louiscklaw/kicad_library/README.md

# My kicad library and footprint collection

### build status
#### master


#### develop
