louiscklaw/kicad_library/kicad-packages3d/15EDGK/15EDGRC_15EDGK_5_08.PNG

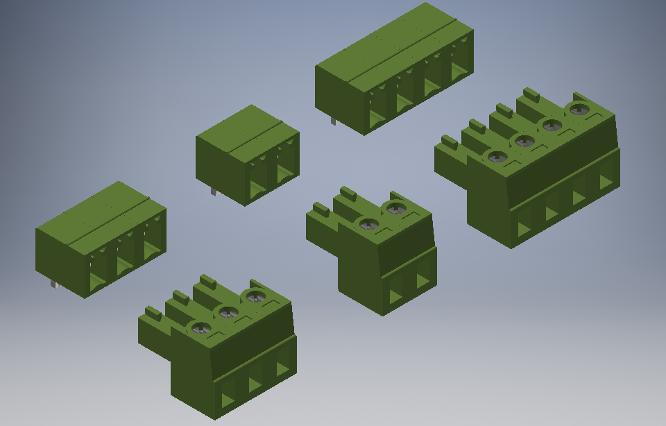
kicad-packages3d/15EDGK/15EDGRC_15EDGK_5_08.PNG
