louiscklaw/kicad_library/kicad-packages3d/connectors TH/Renderings/overview.png

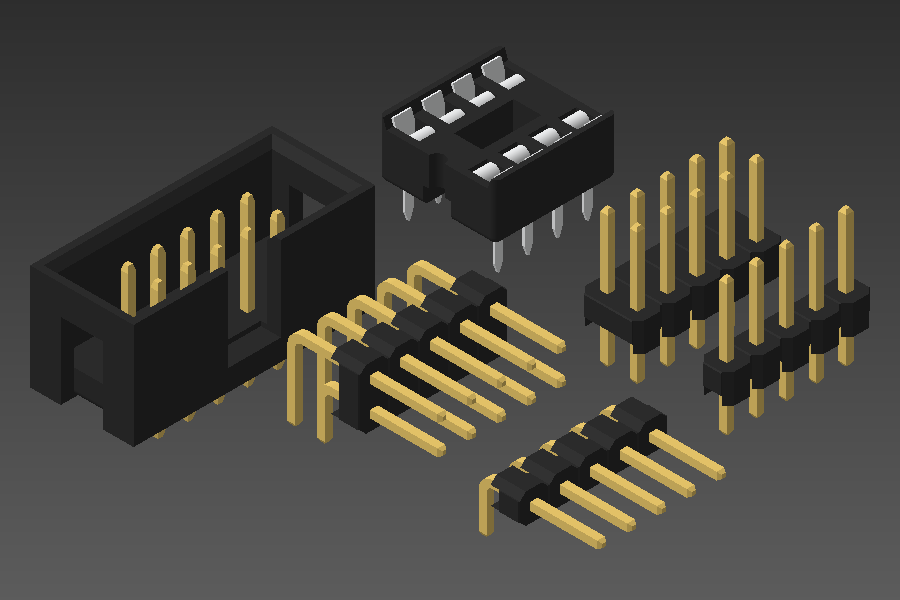
kicad-packages3d/connectors TH/Renderings/overview.png
