louiscklaw/kicad_library/kicad-packages3d/passive smd/Renderings/overview.png

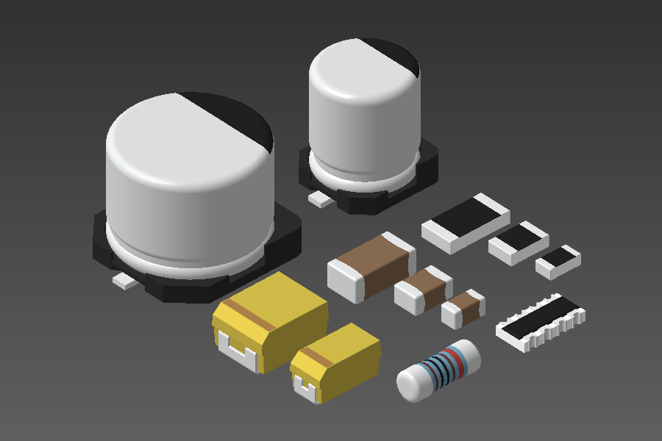
kicad-packages3d/passive smd/Renderings/overview.png
