louiscklaw/kicad_library/components/espressif/ESP-WROOM-32.step

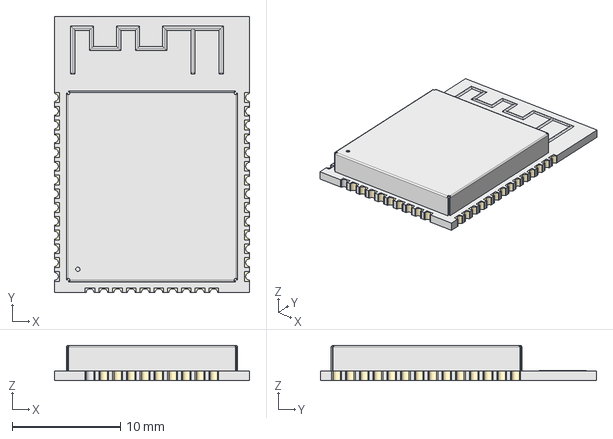
[picture p22: CAD file, 2019-06-11]
components/espressif/ESP-WROOM-32.step
18.0 x 25.5 x 3.25 mm
