louiscklaw/kicad_library/components/KiCad-SSD1306_OLED-0.91-128x32/OLED_0.91_128x32.stp

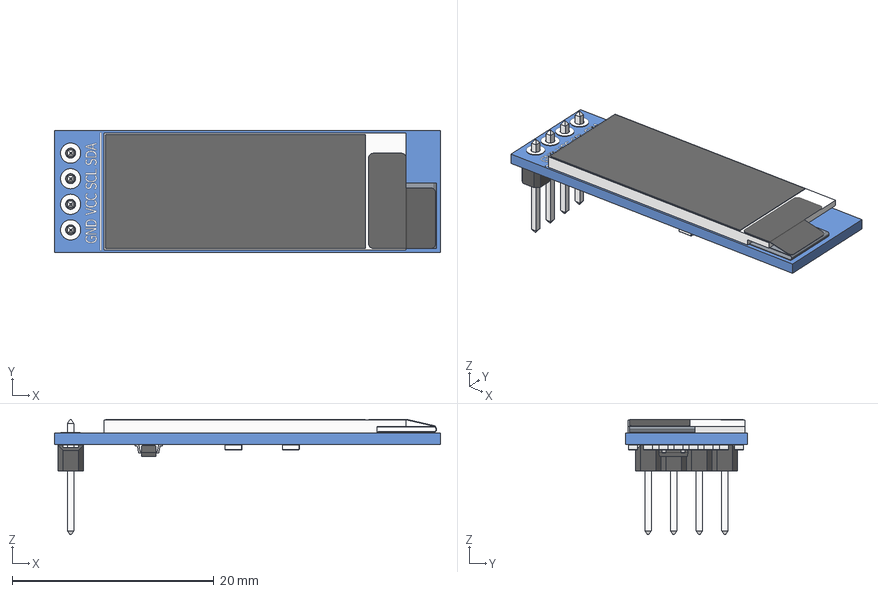
[picture p23: CAD file, 2019-06-02]
components/KiCad-SSD1306_OLED-0.91-128x32/OLED_0.91_128x32.stp
38.3 x 12.1 x 11.5 mm
OLED_0.91_128x32
Pin Header 4 x 1 TH 2.54mm Pitch
RESC-0603 x 13
2SD0601A
