louiscklaw/kicad_library/components/ublox/NEO-M8U Ublox Module.step

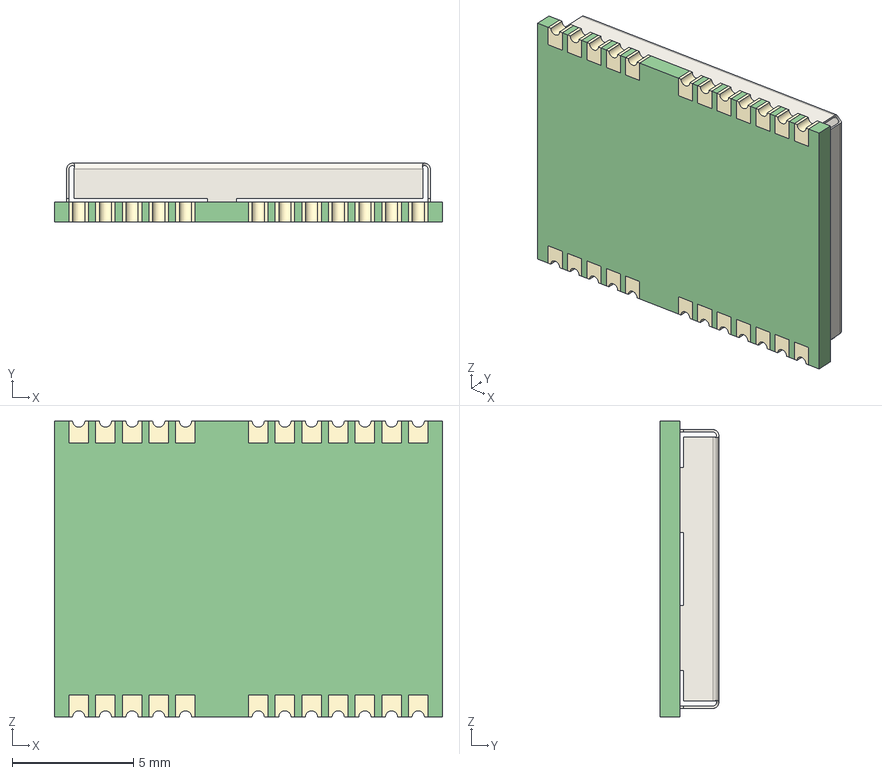
[picture p24: CAD file, 2019-05-14]
components/ublox/NEO-M8U Ublox Module.step
16.0 x 2.42 x 12.2 mm
Board
Solder pads
