louiscklaw/kicad_library/kicad-packages3d/15EDGK/15EDGRC-5.08- 11P-14-00A(H).stp

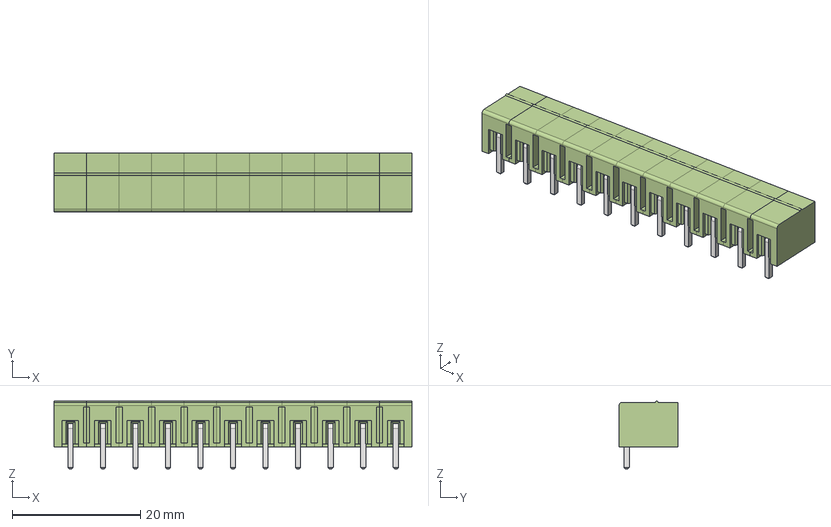
[picture p25: CAD file, 2019-10-14]
kicad-packages3d/15EDGK/15EDGRC-5.08- 11P-14-00A(H).stp
55.9 x 9.20 x 10.6 mm
body_1pc
contact x 11
body_1pc_1
body_1pc_2
body_1pc_3
body_1pc_4
body_1pc_5
body_1pc_6
body_1pc_7
body_1pc_8
body_1pc_9
body_1pc_10
