louiscklaw/kicad_library/kicad-packages3d/4_Pin_audio_jack.STEP

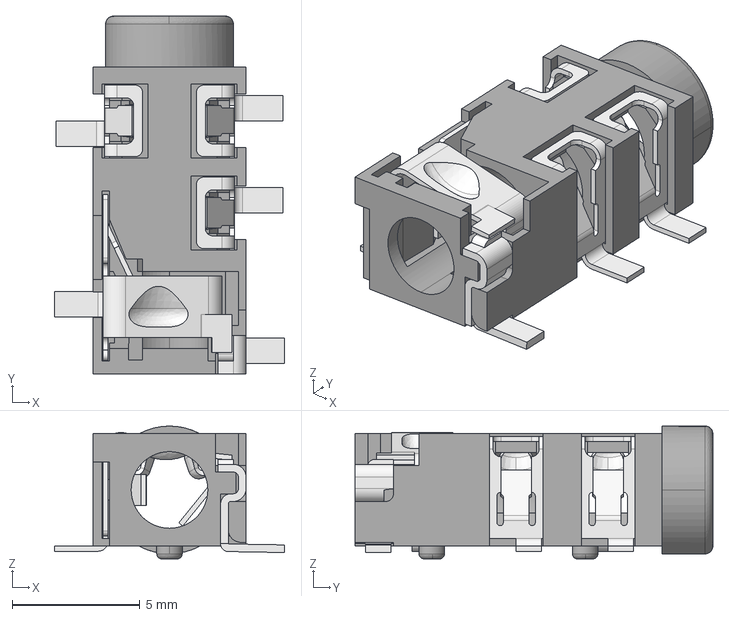
[picture p26: CAD file, 2019-07-07]
kicad-packages3d/4_Pin_audio_jack.STEP
9.00 x 14.0 x 5.20 mm
