louiscklaw/kicad_library/kicad-packages3d/ATX_20_pin_power_connector_vertical/c-2-1586037-0-b-3d.stp

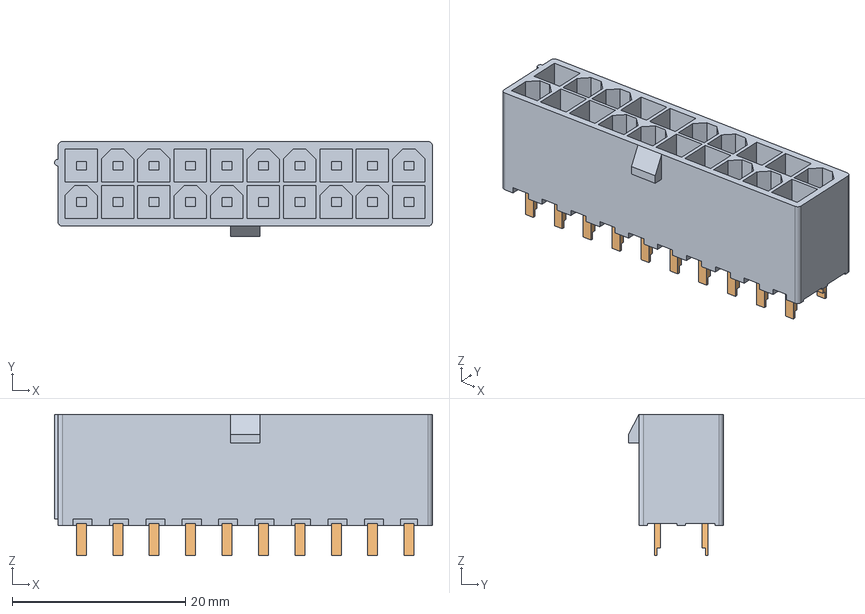
[picture p27: CAD file, 2020-01-22]
kicad-packages3d/ATX_20_pin_power_connector_vertical/c-2-1586037-0-b-3d.stp
43.6 x 10.9 x 16.3 mm
