louiscklaw/kicad_library/kicad-packages3d/connectors TH/DIP_sockets/DIP300-skt-flat-6.stp

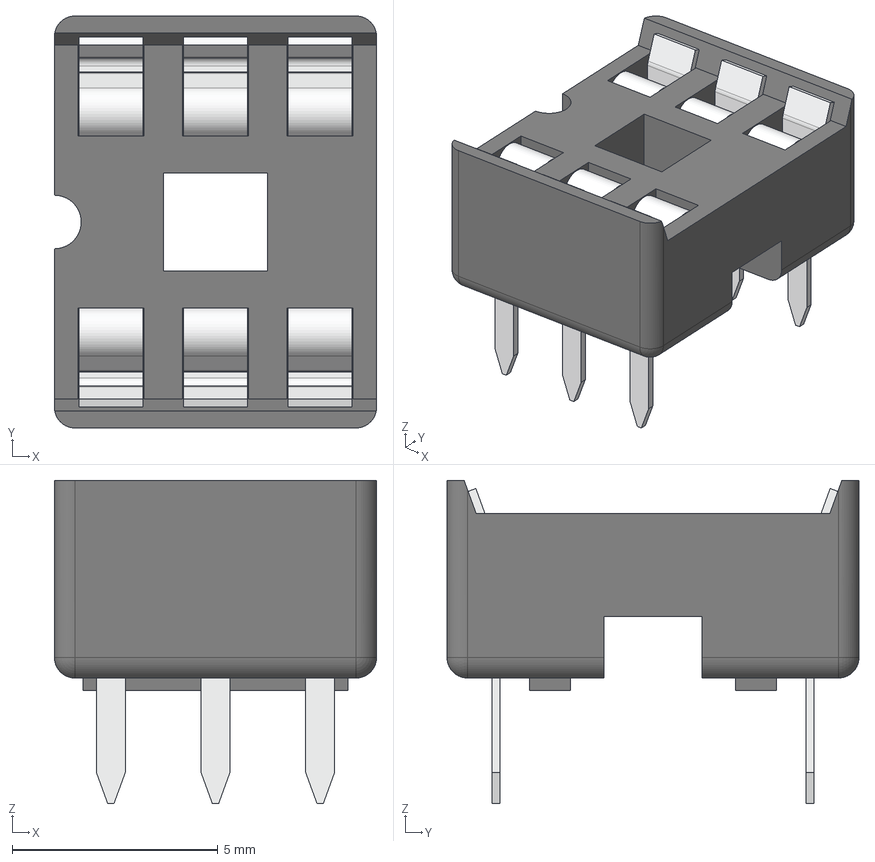
[picture p28: CAD file, 2018-12-04]
kicad-packages3d/connectors TH/DIP_sockets/DIP300-skt-flat-6.stp
7.82 x 10.0 x 7.85 mm
