louiscklaw/kicad_library/kicad-packages3d/connectors TH/rectangular/female/vertical/2.54mm/Samtec/SDL-102-TT-11.stp

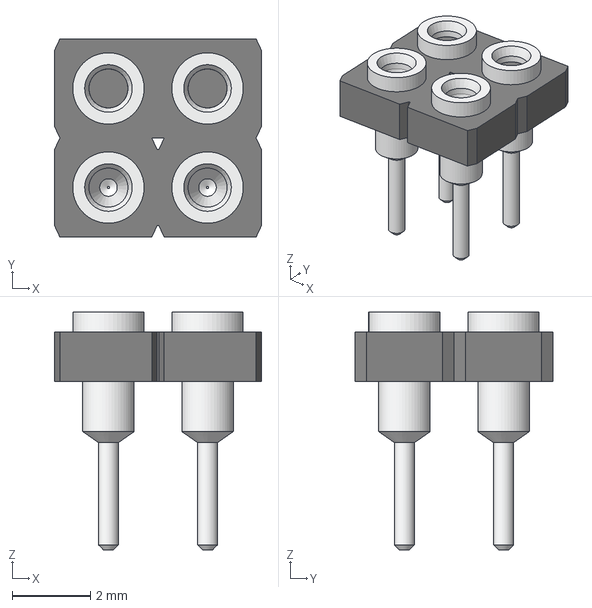
[picture p33: CAD file, 2018-12-04]
kicad-packages3d/connectors TH/rectangular/female/vertical/2.54mm/Samtec/SDL-102-TT-11.stp
5.31 x 5.08 x 6.10 mm
