louiscklaw/kicad_library/kicad-packages3d/connectors TH/rectangular/male/shrouded/right_angle/2.5mm/DS1069-3MRW6XB.stp

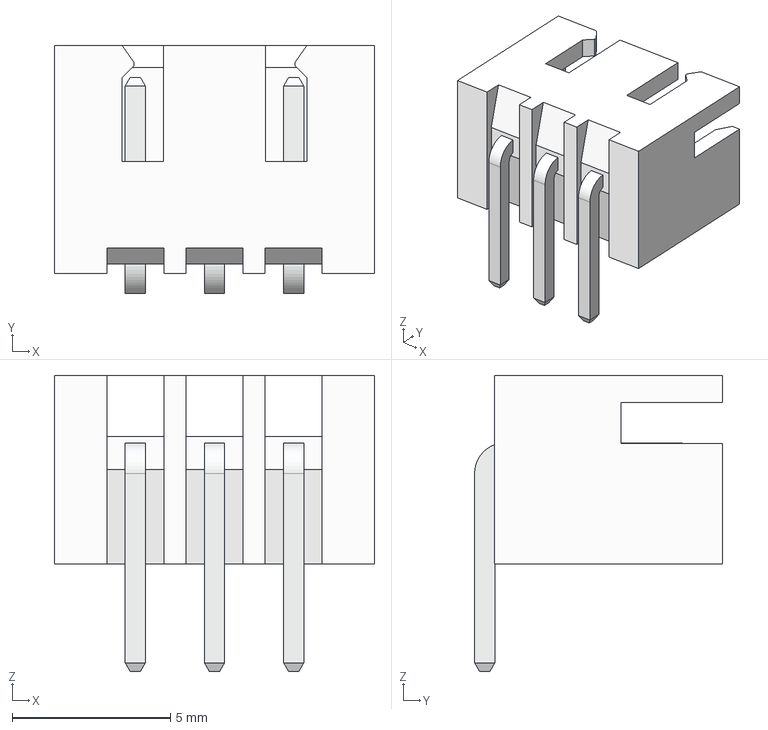
[picture p35: CAD file, 2018-12-04]
kicad-packages3d/connectors TH/rectangular/male/shrouded/right_angle/2.5mm/DS1069-3MRW6XB.stp
10.1 x 7.82 x 9.35 mm
