louiscklaw/kicad_library/kicad-packages3d/connectors TH/rectangular/male/shrouded/vertical/2.5mm/DS1069-2MVW6X.stp

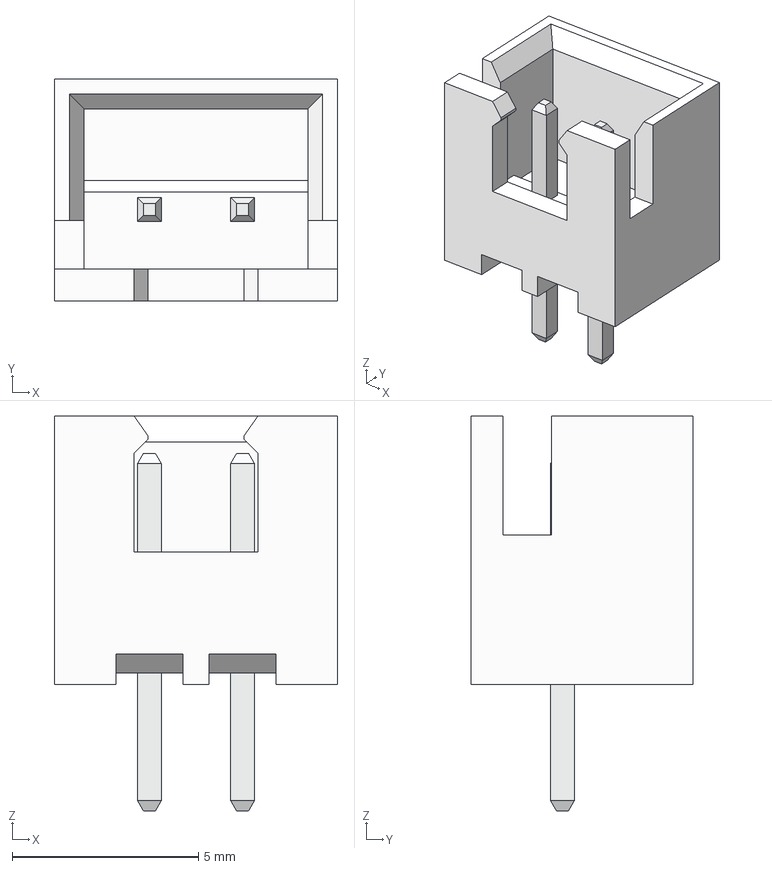
[picture p37: CAD file, 2018-12-04]
kicad-packages3d/connectors TH/rectangular/male/shrouded/vertical/2.5mm/DS1069-2MVW6X.stp
7.60 x 5.95 x 10.6 mm
