louiscklaw/kicad_library/kicad-packages3d/connectors TH/rectangular/male/unshrouded/vertical/1.27mm/DS1031-01-1x1P8BV2-1.stp

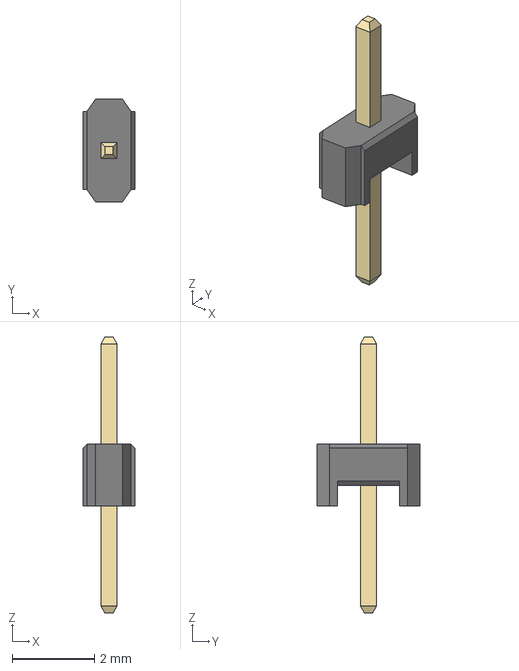
[picture p40: CAD file, 2018-12-04]
kicad-packages3d/connectors TH/rectangular/male/unshrouded/vertical/1.27mm/DS1031-01-1x1P8BV2-1.stp
1.27 x 2.50 x 6.70 mm
