louiscklaw/kicad_library/kicad-packages3d/connectors TH/rectangular/male/unshrouded/vertical/2.54mm/DS1070-7MVV6.stp

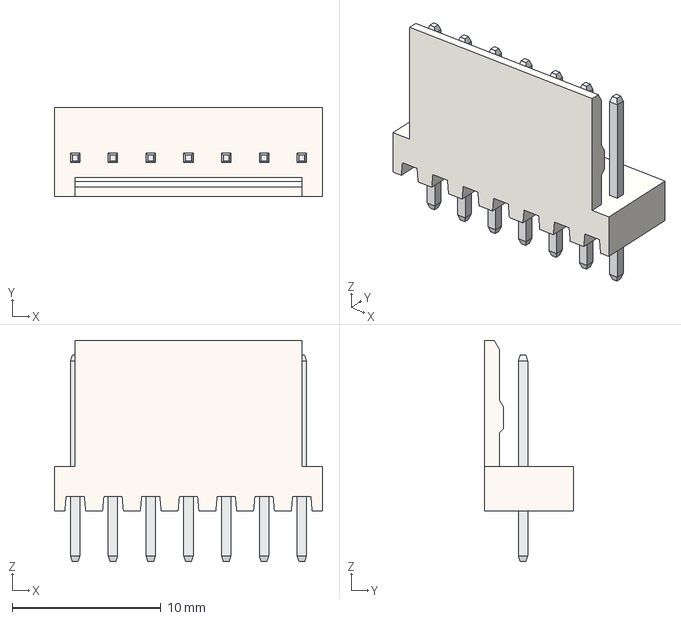
[picture p41: CAD file, 2018-12-04]
kicad-packages3d/connectors TH/rectangular/male/unshrouded/vertical/2.54mm/DS1070-7MVV6.stp
18.0 x 6.00 x 14.9 mm
