louiscklaw/kicad_library/kicad-packages3d/connectors TH/rectangular/male/unshrouded/vertical/5.08mm/10-32-1061.stp

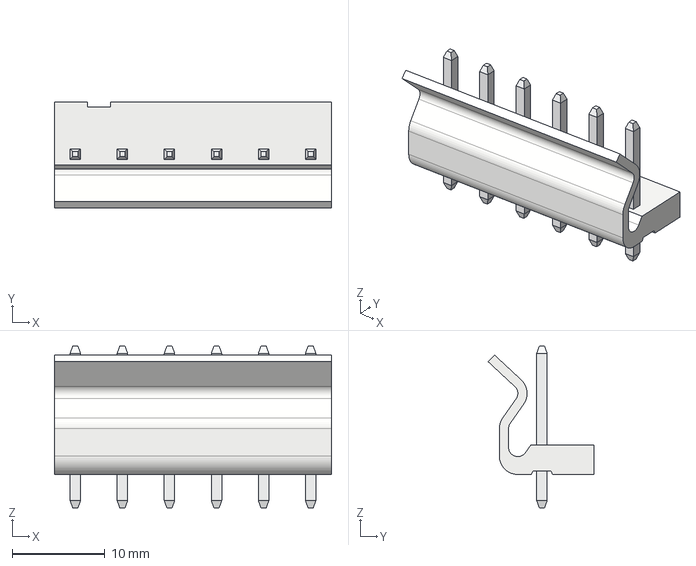
[picture p42: CAD file, 2018-12-04]
kicad-packages3d/connectors TH/rectangular/male/unshrouded/vertical/5.08mm/10-32-1061.stp
29.9 x 11.4 x 17.4 mm
