louiscklaw/kicad_library/kicad-packages3d/connectors TH/terminal/TE_1742361-1.stp

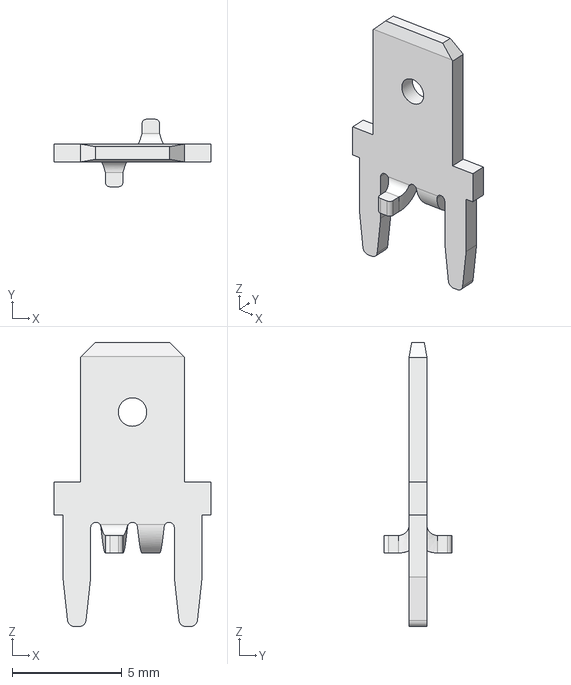
[picture p43: CAD file, 2018-12-04]
kicad-packages3d/connectors TH/terminal/TE_1742361-1.stp
7.14 x 3.08 x 13.0 mm
