louiscklaw/kicad_library/kicad-packages3d/Degson/DG103-5.0-02.stp

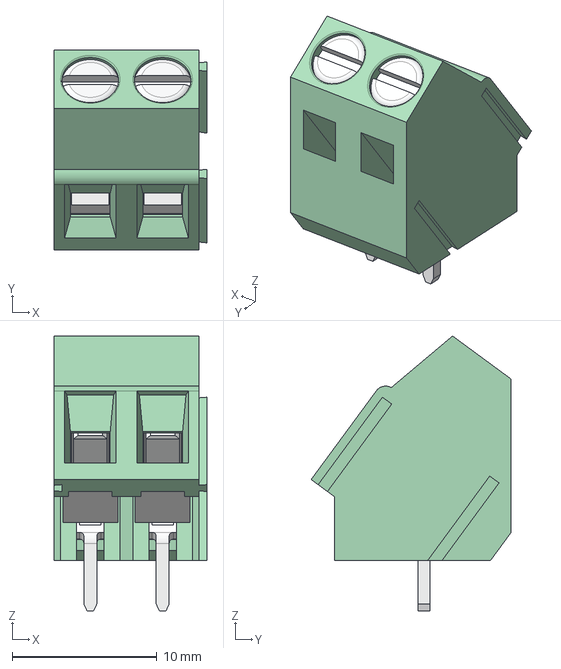
[picture p44: CAD file, 2018-12-04]
kicad-packages3d/Degson/DG103-5.0-02.stp
10.6 x 13.8 x 19.0 mm
