louiscklaw/kicad_library/kicad-packages3d/discrete SMD/SC-79.stp

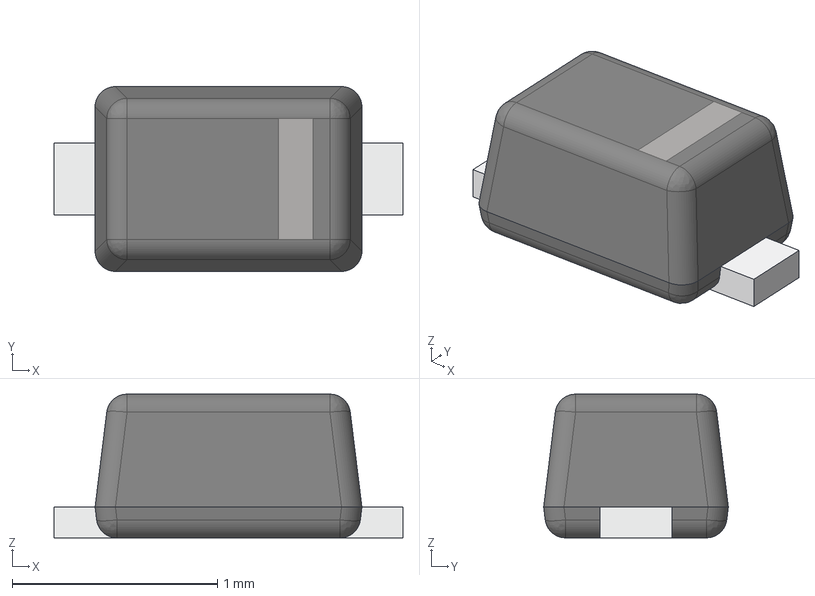
[picture p45: CAD file, 2018-12-04]
kicad-packages3d/discrete SMD/SC-79.stp
1.70 x 0.9 x 0.7 mm
