louiscklaw/kicad_library/kicad-packages3d/EDG/2EDG-5.08-02P.STEP

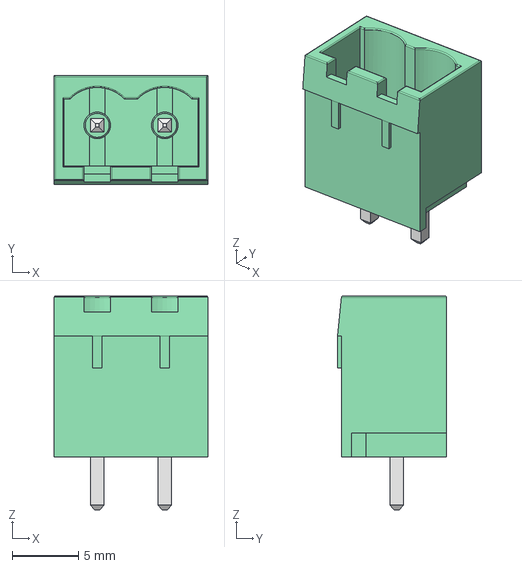
[picture p46: CAD file, 2019-06-20]
kicad-packages3d/EDG/2EDG-5.08-02P.STEP
11.6 x 8.20 x 16.1 mm
