louiscklaw/kicad_library/kicad-packages3d/IC/Fair_Power56_PQFN08AREV10.stp

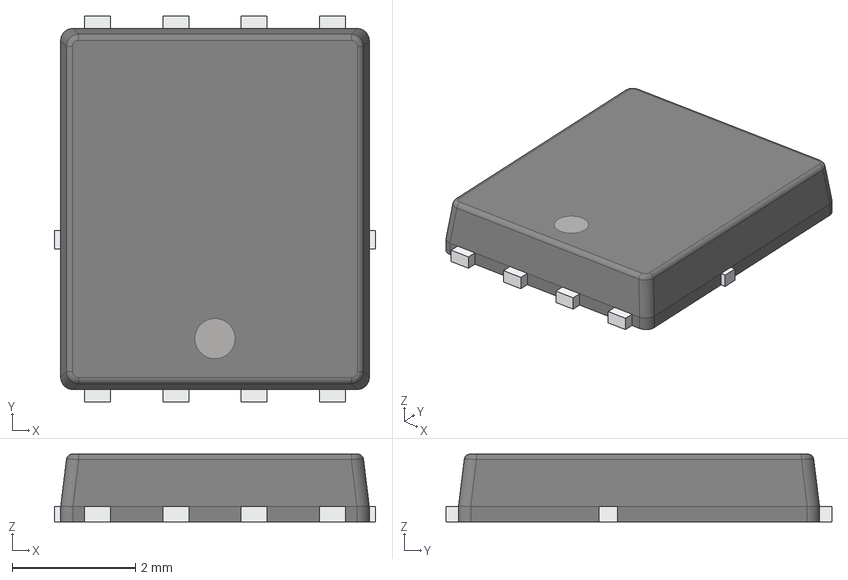
[picture p47: CAD file, 2018-12-04]
kicad-packages3d/IC/Fair_Power56_PQFN08AREV10.stp
5.20 x 6.25 x 1.10 mm
