louiscklaw/kicad_library/kicad-packages3d/keyboard/keycap_dsa_signatureplastics_r3.step

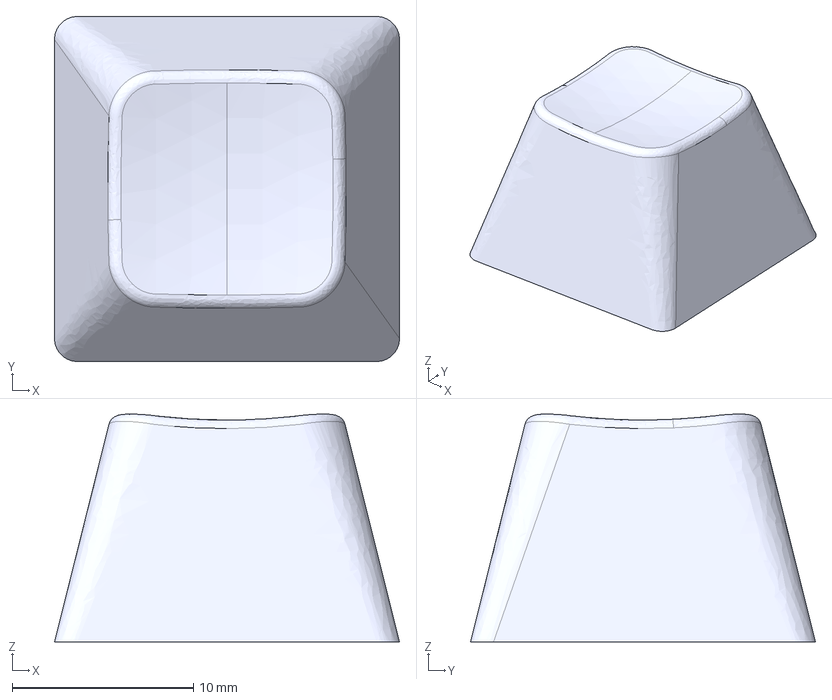
[picture p48: CAD file, 2019-06-03]
kicad-packages3d/keyboard/keycap_dsa_signatureplastics_r3.step
19.1 x 19.1 x 12.6 mm
