louiscklaw/kicad_library/kicad-packages3d/LED/STEP-WL-SBTW-3528-rev1(2.stp

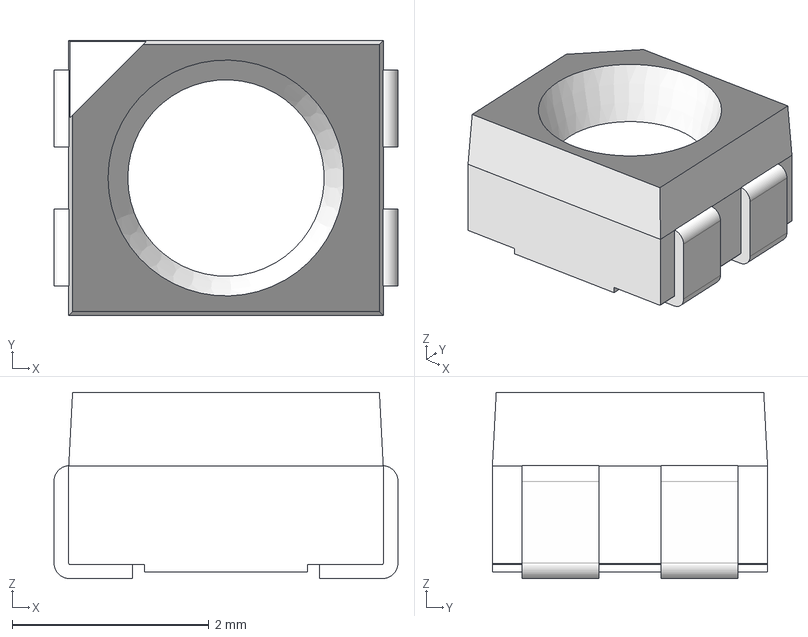
[picture p49: CAD file, 2018-12-04]
kicad-packages3d/LED/STEP-WL-SBTW-3528-rev1(2.stp
3.50 x 2.80 x 1.90 mm
cover
housing
base x 2
