louiscklaw/kicad_library/kicad-packages3d/LGA1155_FAN_MOUNT/kf2510_4p_right_angle.step

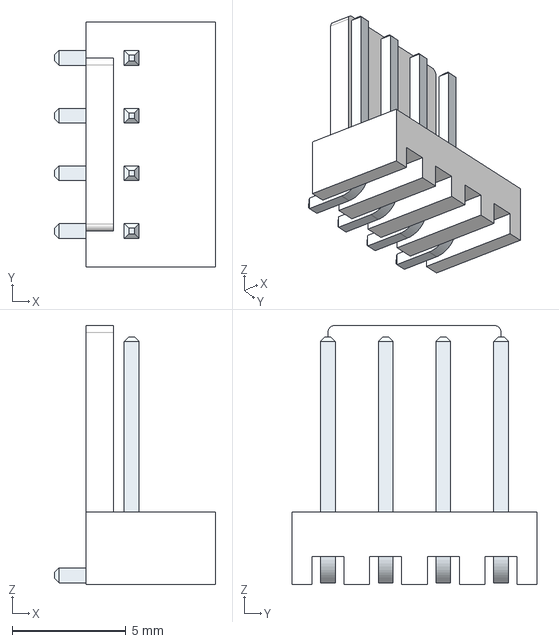
[picture p50: CAD file, 2021-09-15]
kicad-packages3d/LGA1155_FAN_MOUNT/kf2510_4p_right_angle.step
7.10 x 10.8 x 11.4 mm
