louiscklaw/kicad_library/kicad-packages3d/lora/RFM95.step

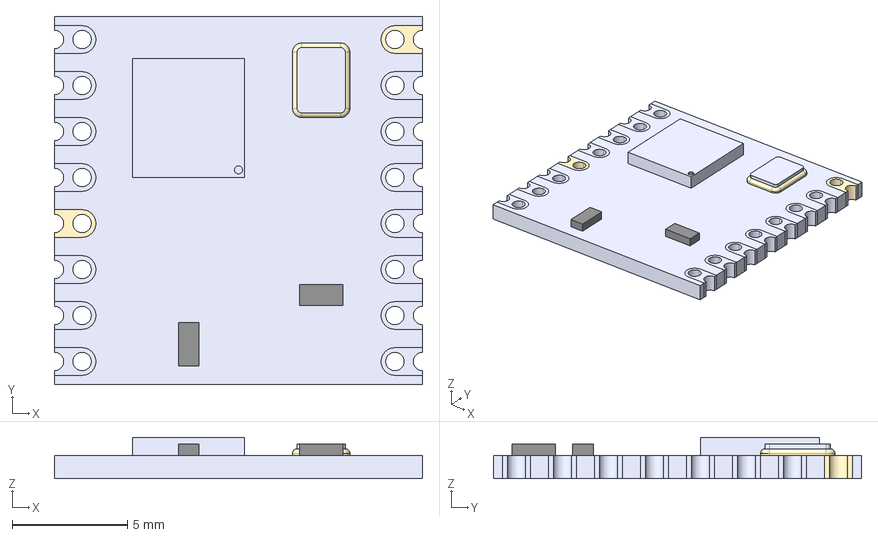
[picture p51: CAD file, 2019-06-14]
kicad-packages3d/lora/RFM95.step
16.0 x 16.0 x 1.80 mm
