louiscklaw/kicad_library/kicad-packages3d/MP1584_DC_DC_converter/D-SUN_dcdc_step_down_SIMPLE.step

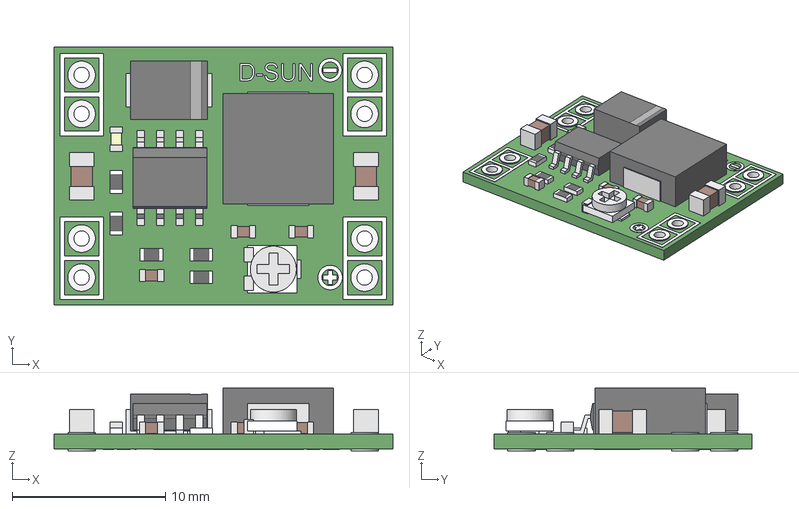
[picture p52: CAD file, 2019-05-25]
kicad-packages3d/MP1584_DC_DC_converter/D-SUN_dcdc_step_down_SIMPLE.step
22.1 x 16.8 x 4.10 mm
main001
silk-TOP
pins
silk-bot
comp-top
