louiscklaw/kicad_library/kicad-packages3d/orange-pi-zero/PinSocket_1x13_P254mm_Vertical.step

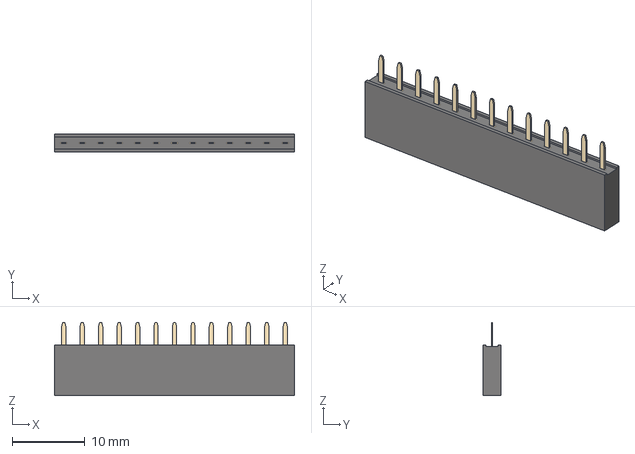
[picture p53: CAD file, 2019-07-07]
kicad-packages3d/orange-pi-zero/PinSocket_1x13_P254mm_Vertical.step
33.0 x 2.54 x 10.1 mm
