louiscklaw/kicad_library/kicad-packages3d/oscillator/OSC3225.STEP

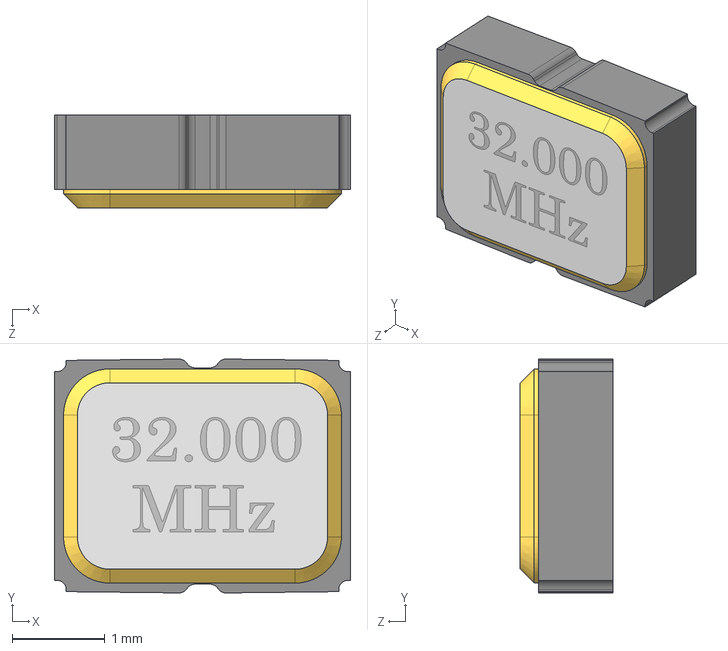
[picture p54: CAD file, 2019-05-09]
kicad-packages3d/oscillator/OSC3225.STEP
3.20 x 2.53 x 1.00 mm
