louiscklaw/kicad_library/kicad-packages3d/passive smd/Capacitors/CAPM-TANTA-YL.stp

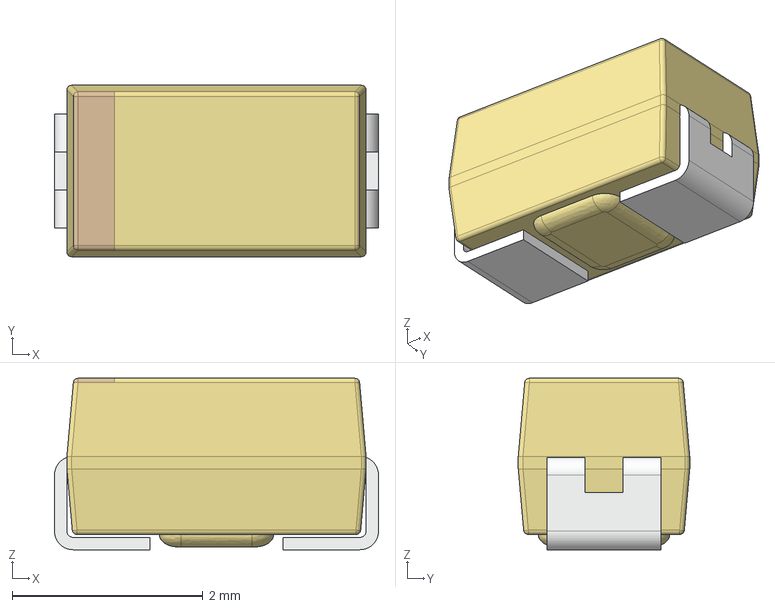
[picture p55: CAD file, 2018-12-04]
kicad-packages3d/passive smd/Capacitors/CAPM-TANTA-YL.stp
3.40 x 1.80 x 1.80 mm
