louiscklaw/kicad_library/kicad-packages3d/passive smd/Crystals/HC-49SM.stp

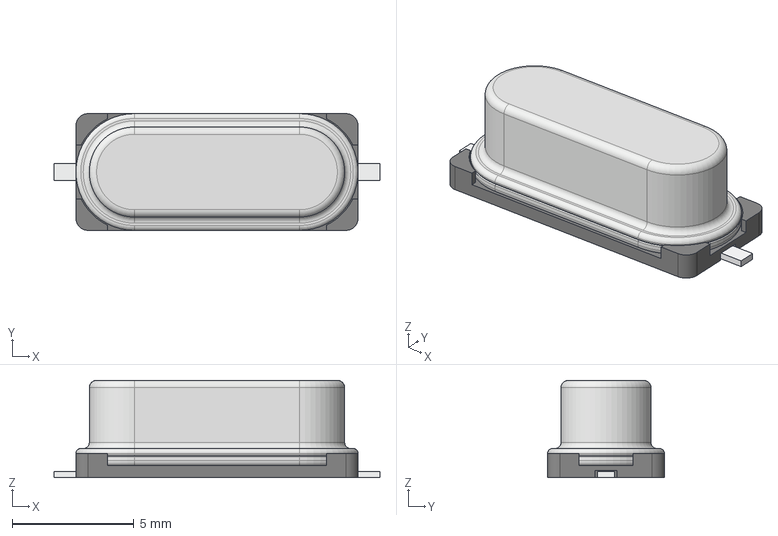
[picture p56: CAD file, 2018-12-04]
kicad-packages3d/passive smd/Crystals/HC-49SM.stp
13.4 x 4.80 x 4.00 mm
