louiscklaw/kicad_library/kicad-packages3d/passive smd/Inductors/SRP1038A-NLF.stp

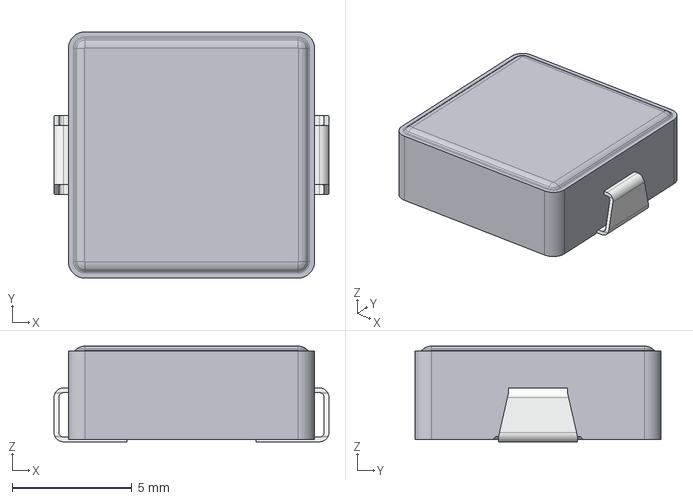
[picture p57: CAD file, 2018-12-04]
kicad-packages3d/passive smd/Inductors/SRP1038A-NLF.stp
11.5 x 10.3 x 4.00 mm
