louiscklaw/kicad_library/kicad-packages3d/passive smd/Resistors/RESMELF-0207.stp

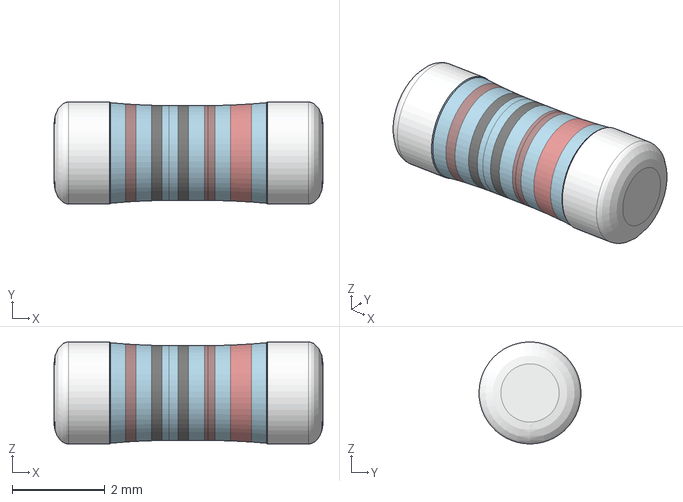
[picture p58: CAD file, 2018-12-04]
kicad-packages3d/passive smd/Resistors/RESMELF-0207.stp
5.80 x 2.20 x 2.20 mm
