louiscklaw/kicad_library/kicad-packages3d/qfn/QFN28.step

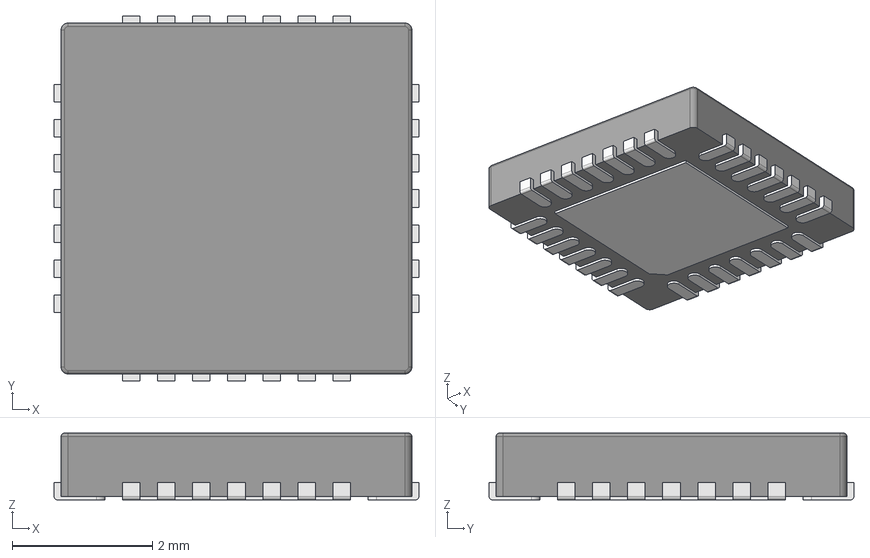
[picture p59: CAD file, 2019-05-31]
kicad-packages3d/qfn/QFN28.step
5.20 x 5.20 x 0.95 mm
