louiscklaw/kicad_library/kicad-packages3d/RJ45/RJ45 SH Plug.STEP

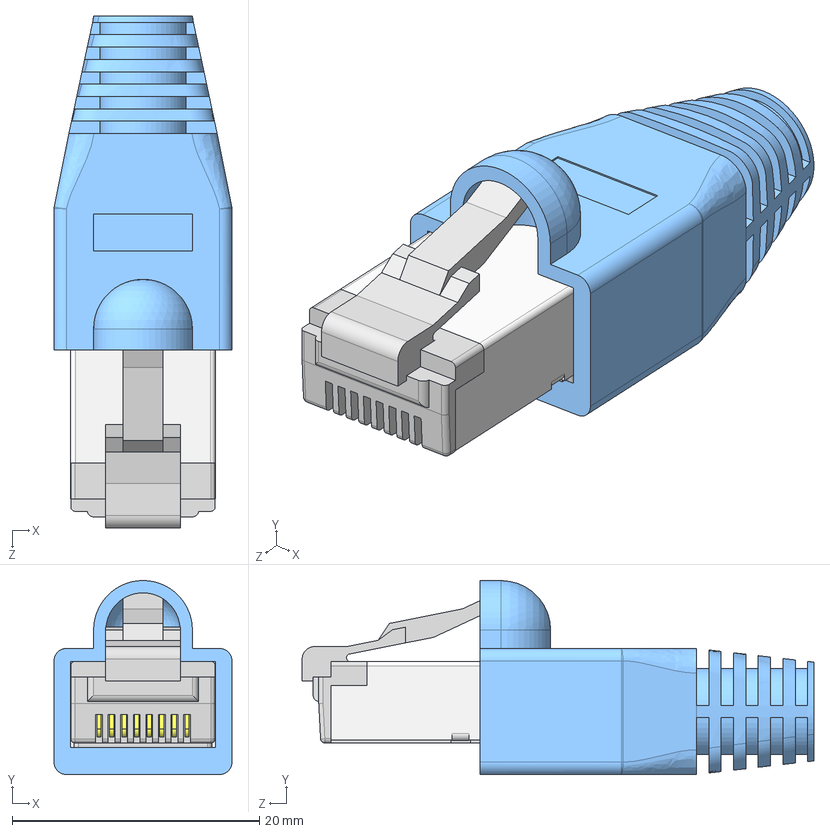
[picture p60: CAD file, 2022-02-03]
kicad-packages3d/RJ45/RJ45 SH Plug.STEP
14.4 x 15.7 x 41.4 mm
RJ45S Body^RJ45S Plug_00
RJ45 Pin^RJ45_00 x 8
RJ45S Shield^RJ45S Plug_00
Protective Jacket^RJ45Sh Plug_Orange
