louiscklaw/kicad_library/kicad-packages3d/rpi_zero/RaspberryPiZeroW.step

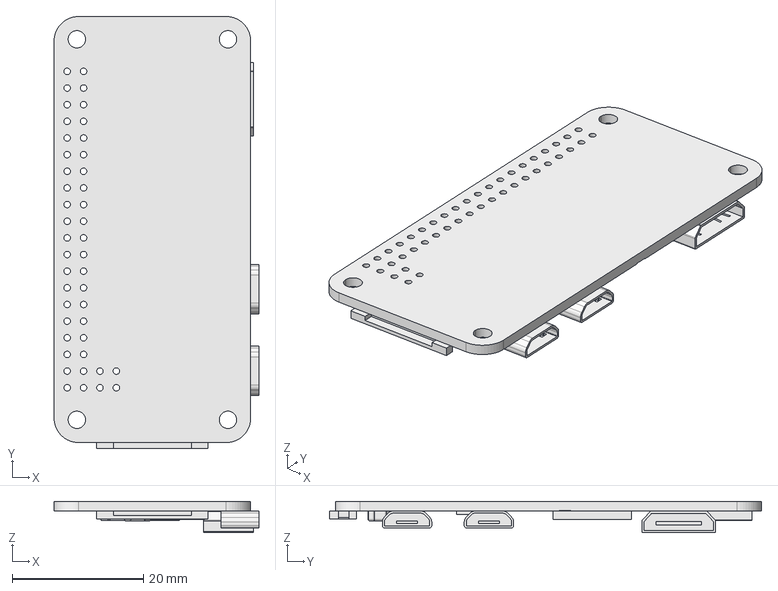
[picture p61: CAD file, 2019-07-12]
kicad-packages3d/rpi_zero/RaspberryPiZeroW.step
31.2 x 65.9 x 4.80 mm
