louiscklaw/kicad_library/kicad-packages3d/SD card/micro sd.stp

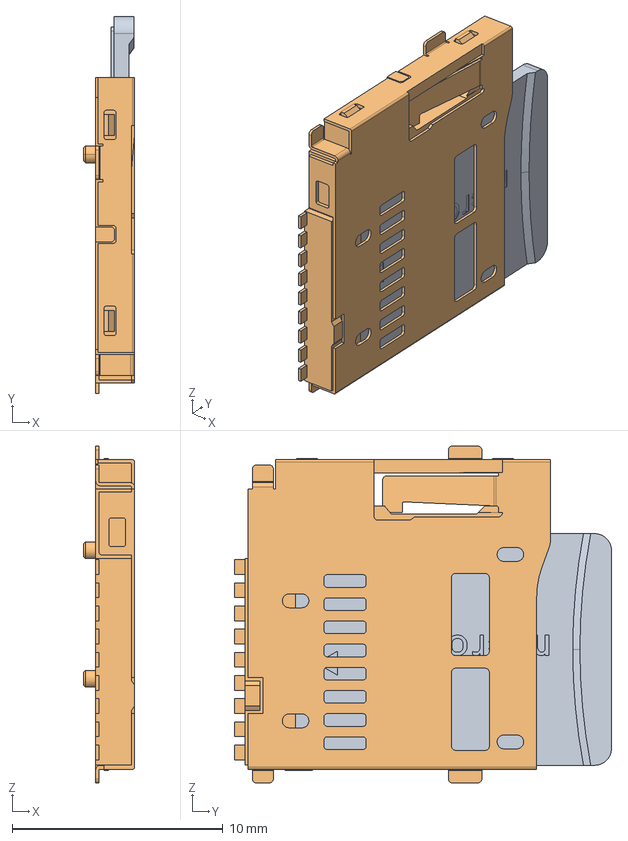
[picture p62: CAD file, 2018-12-04]
kicad-packages3d/SD card/micro sd.stp
2.44 x 17.9 x 16.0 mm
P1
sd
slot
