louiscklaw/kicad_library/kicad-packages3d/smd_fuse/C1.stp

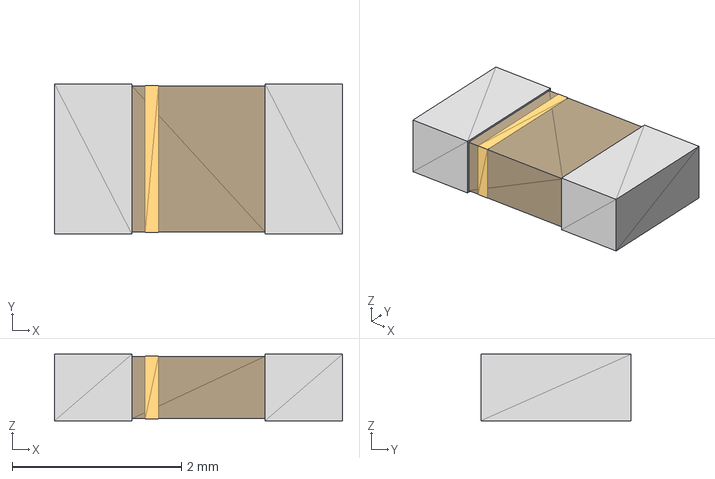
[picture p63: CAD file, 2018-12-04]
kicad-packages3d/smd_fuse/C1.stp
3.40 x 1.78 x 0.787 mm
