louiscklaw/kicad_library/kicad-packages3d/standoff/Hex Spacer MF M3 L50mm.stp

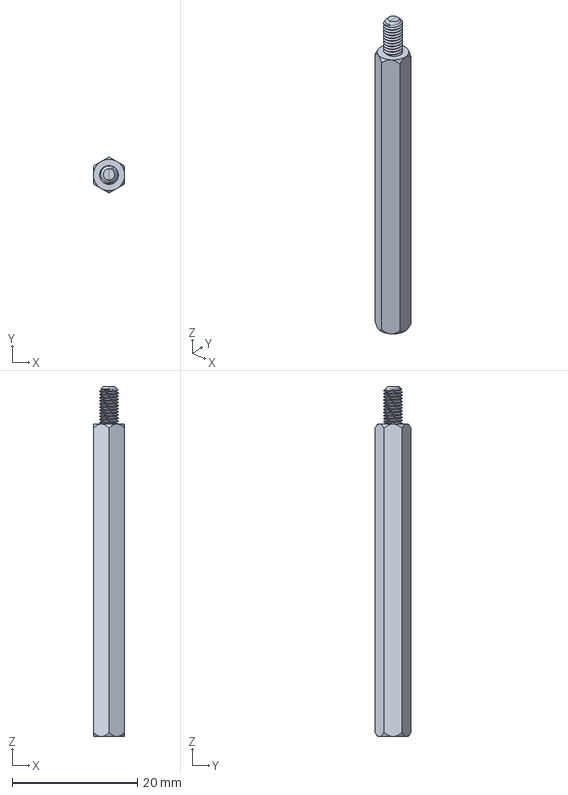
[picture p64: CAD file, 2018-12-04]
kicad-packages3d/standoff/Hex Spacer MF M3 L50mm.stp
5.00 x 5.77 x 56.0 mm
