louiscklaw/kicad_library/kicad-packages3d/terminals/tb5p-2p_p5_l10_w7-6_h10.stp

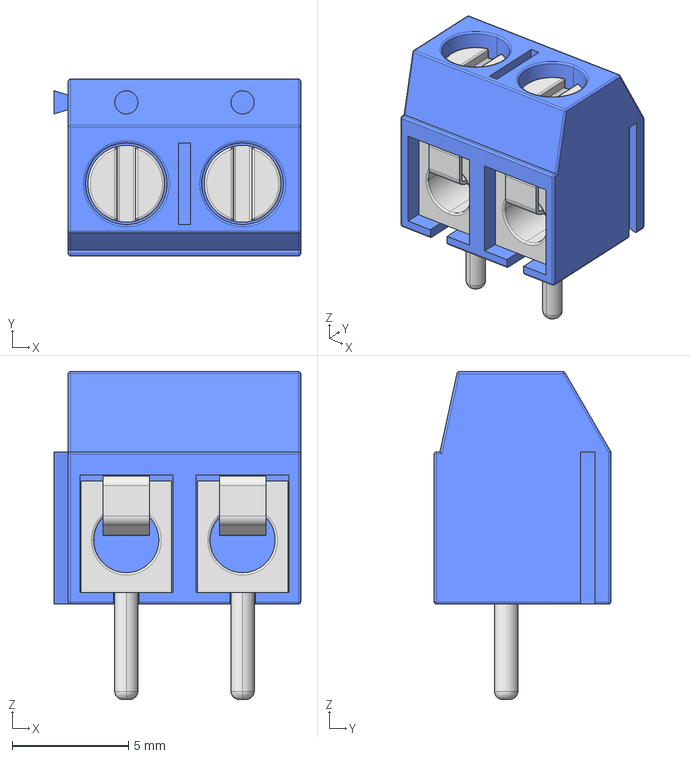
[picture p66: CAD file, 2020-08-20]
kicad-packages3d/terminals/tb5p-2p_p5_l10_w7-6_h10.stp
10.6 x 7.60 x 14.1 mm
