louiscklaw/kicad_library/kicad-packages3d/UBLOX/NEO-6M-0-001.step

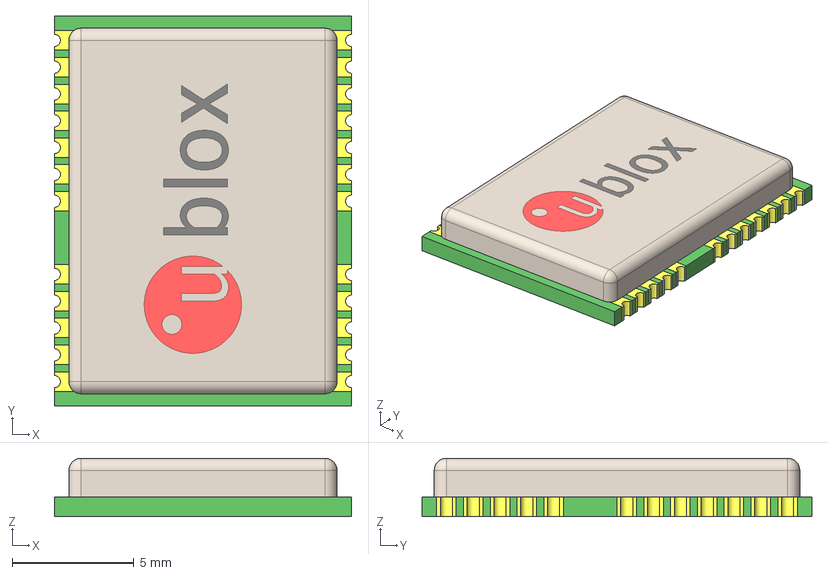
[picture p67: CAD file, 2019-06-25]
kicad-packages3d/UBLOX/NEO-6M-0-001.step
12.2 x 16.0 x 2.40 mm
