louiscklaw/kicad_library/components/espressif/ESP-12E.stl

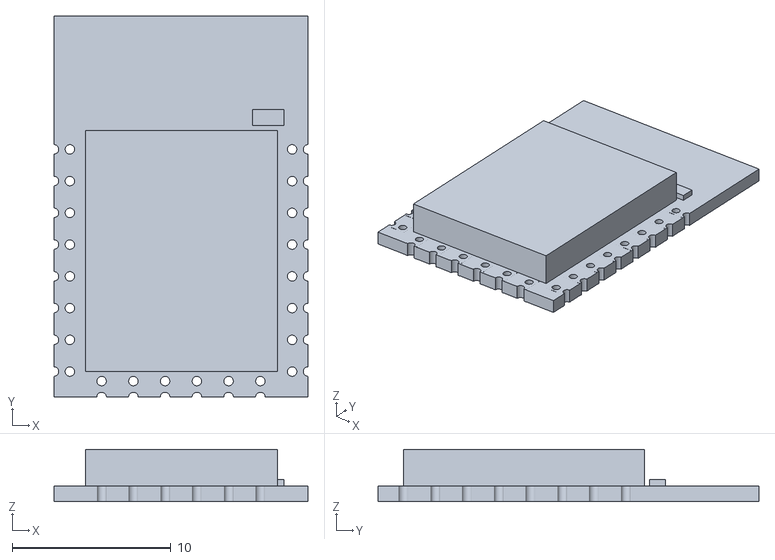
[picture p68: CAD file, 2019-05-08]
components/espressif/ESP-12E.stl
16.0 x 24.0 x 3.30
