louiscklaw/kicad_library/components/KiCad-SSD1306_OLED-0.91-128x32/SSD1306_OLED-0.91-128x32.step

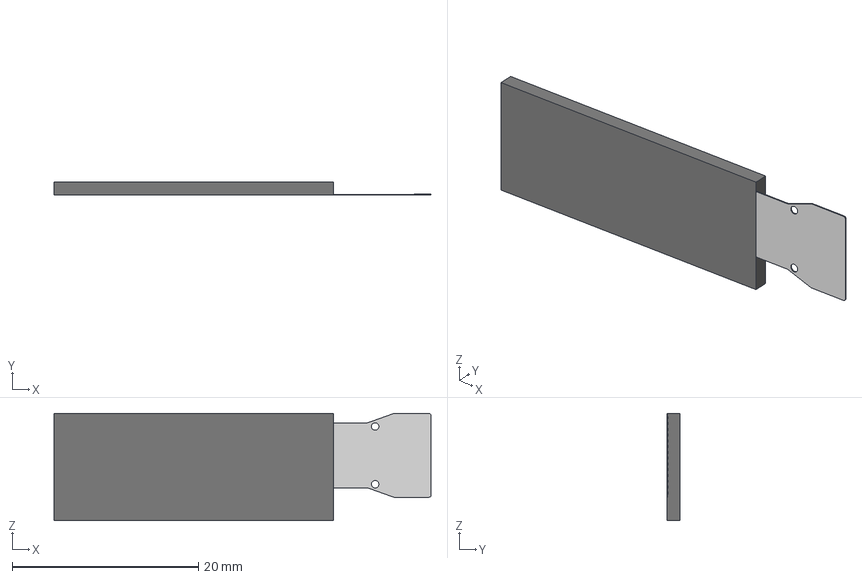
[picture p69: CAD file, 2019-01-09]
components/KiCad-SSD1306_OLED-0.91-128x32/SSD1306_OLED-0.91-128x32.step
40.5 x 1.45 x 11.5 mm
