louiscklaw/kicad_library/generator/kicad-footprint-generator/scripts/Connector/Connector_JST/JST-PH-SMT-TOP_ENTRY.fcstd

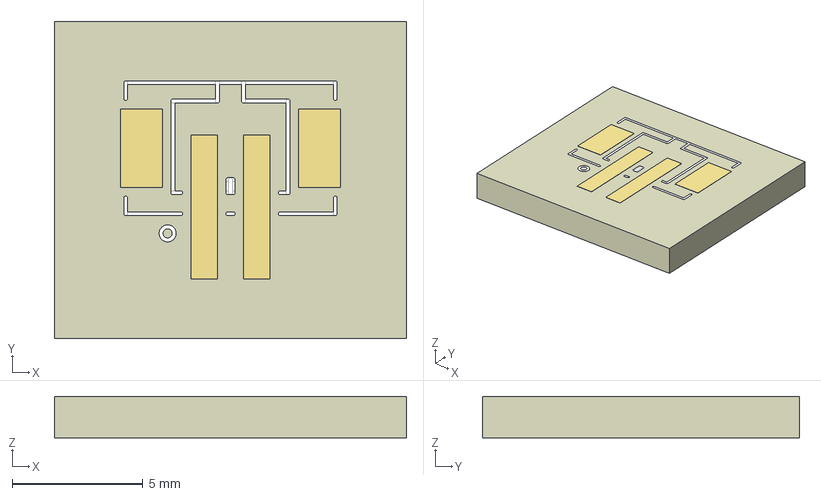
[picture p70: CAD file, 2018-10-22]
generator/kicad-footprint-generator/scripts/Connector/Connector_JST/JST-PH-SMT-TOP_ENTRY.fcstd
13.4 x 12.1 x 1.60 mm
FrontSilk
TopPads
Pcb
