louiscklaw/kicad_library/kicad-packages3d/15EDGK/15EDGRC-5.08- 07P-14-00A(H).stp

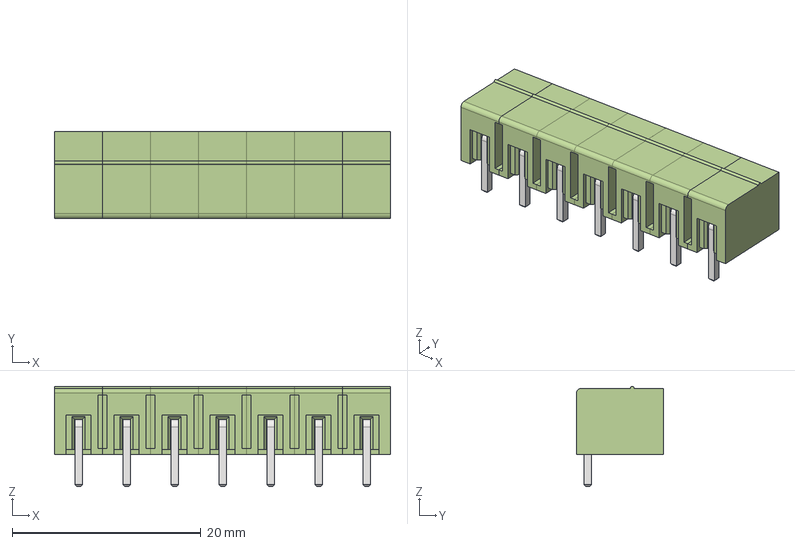
[picture p71: CAD file, 2019-10-14]
kicad-packages3d/15EDGK/15EDGRC-5.08- 07P-14-00A(H).stp
35.6 x 9.20 x 10.6 mm
body_1pc
contact x 7
body_1pc_1
body_1pc_2
body_1pc_3
body_1pc_4
body_1pc_5
body_1pc_6
