louiscklaw/kicad_library/kicad-packages3d/ATX_20_pin_power_connector_vertical/ATX_20_pin_power_connector.step

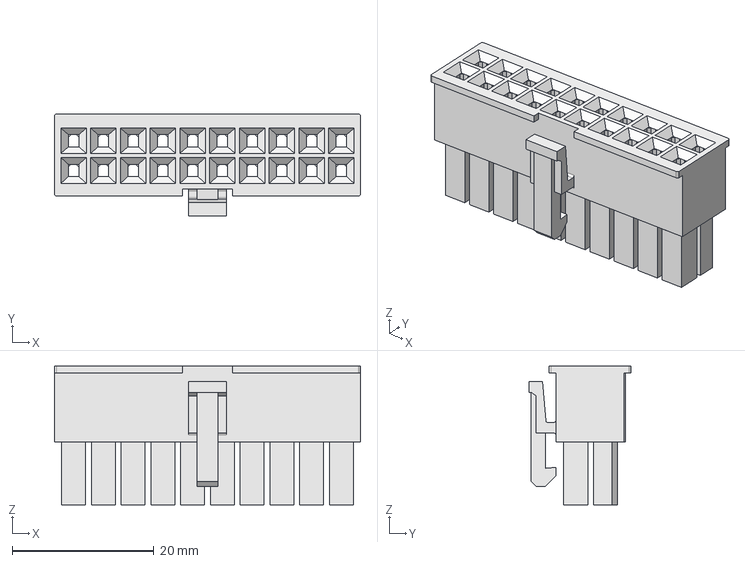
[picture p72: CAD file, 2020-01-22]
kicad-packages3d/ATX_20_pin_power_connector_vertical/ATX_20_pin_power_connector.step
43.2 x 14.4 x 19.6 mm
