louiscklaw/kicad_library/kicad-packages3d/connectors TH/DIP_sockets/DIP300-skt-flat-14.stp

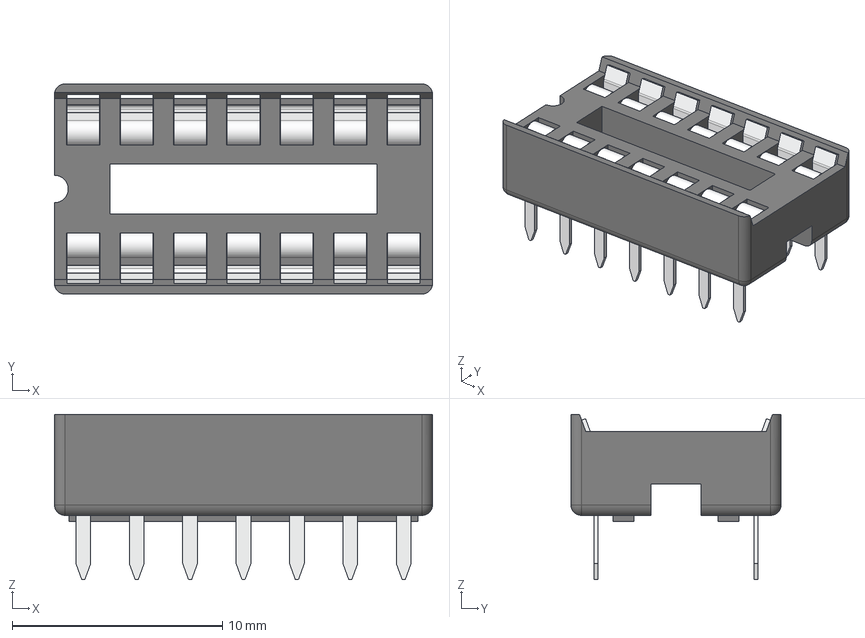
[picture p73: CAD file, 2018-12-04]
kicad-packages3d/connectors TH/DIP_sockets/DIP300-skt-flat-14.stp
18.0 x 10.0 x 7.85 mm
