louiscklaw/kicad_library/kicad-packages3d/connectors TH/modular/A-2014-0-4-R.stp

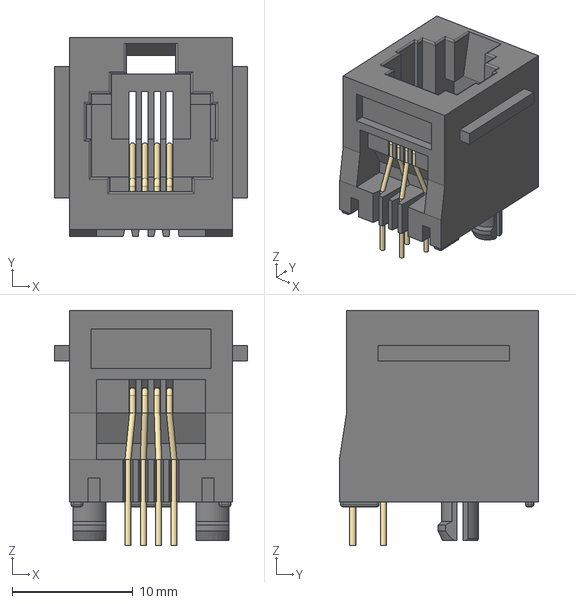
[picture p74: CAD file, 2018-12-04]
kicad-packages3d/connectors TH/modular/A-2014-0-4-R.stp
16.0 x 16.5 x 19.4 mm
