louiscklaw/kicad_library/kicad-packages3d/connectors TH/rectangular/direct_wire/2.54mm/DS1018-166B.stp

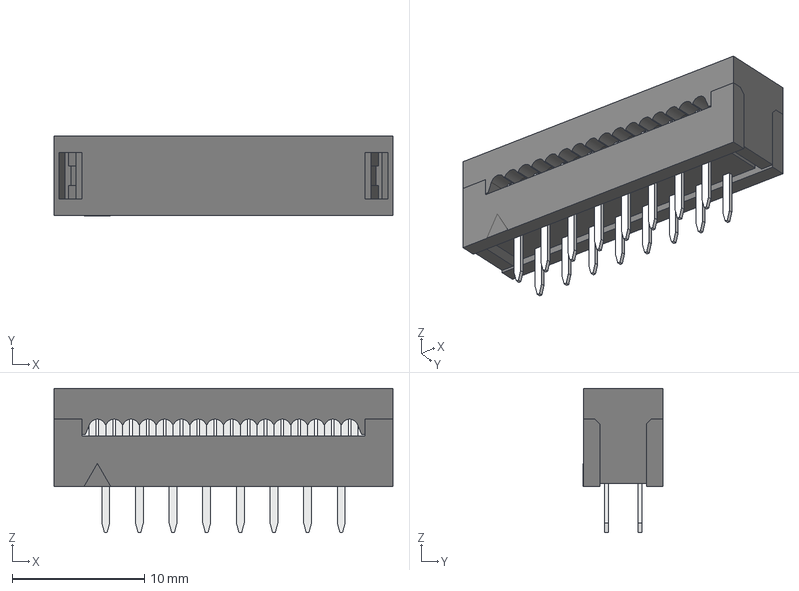
[picture p75: CAD file, 2018-12-04]
kicad-packages3d/connectors TH/rectangular/direct_wire/2.54mm/DS1018-166B.stp
25.6 x 6.03 x 10.9 mm
