louiscklaw/kicad_library/kicad-packages3d/connectors TH/rectangular/female/right_angle/2.54mm/DS1024-1x5RF1.stp

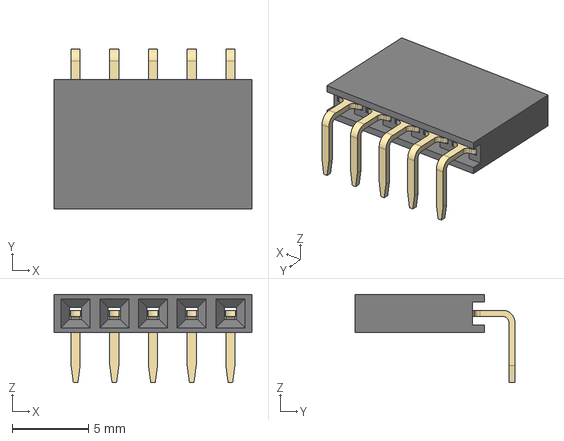
[picture p76: CAD file, 2018-12-04]
kicad-packages3d/connectors TH/rectangular/female/right_angle/2.54mm/DS1024-1x5RF1.stp
13.0 x 10.5 x 5.80 mm
