louiscklaw/kicad_library/kicad-packages3d/connectors TH/rectangular/female/vertical/2.54mm/DS1023-1x10SF11.stp

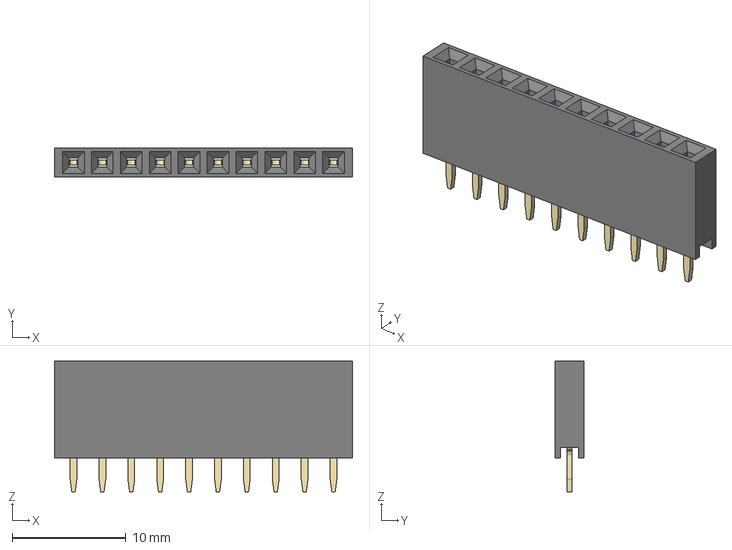
[picture p77: CAD file, 2018-12-04]
kicad-packages3d/connectors TH/rectangular/female/vertical/2.54mm/DS1023-1x10SF11.stp
26.2 x 2.54 x 11.5 mm
