louiscklaw/kicad_library/kicad-packages3d/connectors TH/rectangular/female/vertical/2.54mm/Samtec/SL-110-TT-19.stp

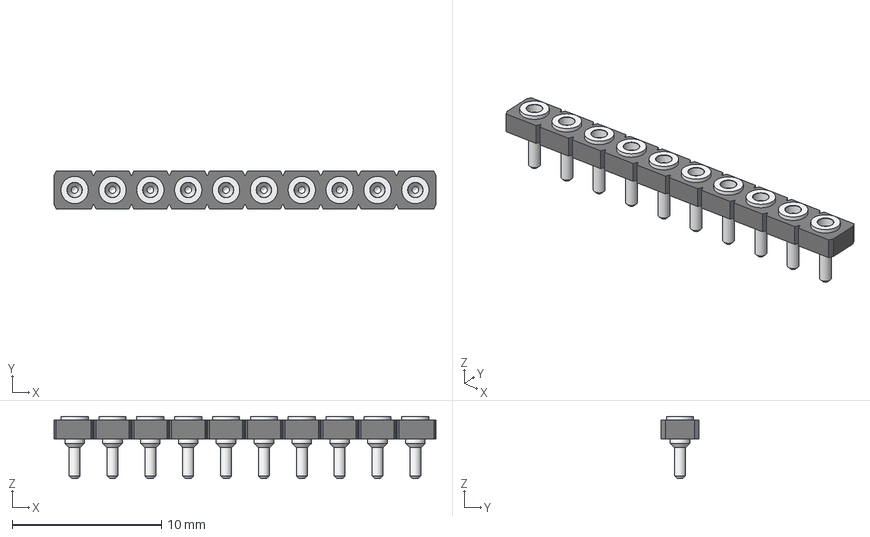
[picture p78: CAD file, 2018-12-04]
kicad-packages3d/connectors TH/rectangular/female/vertical/2.54mm/Samtec/SL-110-TT-19.stp
25.6 x 2.54 x 4.19 mm
