louiscklaw/kicad_library/kicad-packages3d/connectors TH/rectangular/male/shrouded/vertical/2.54mm/DS1013-14SSiB.stp

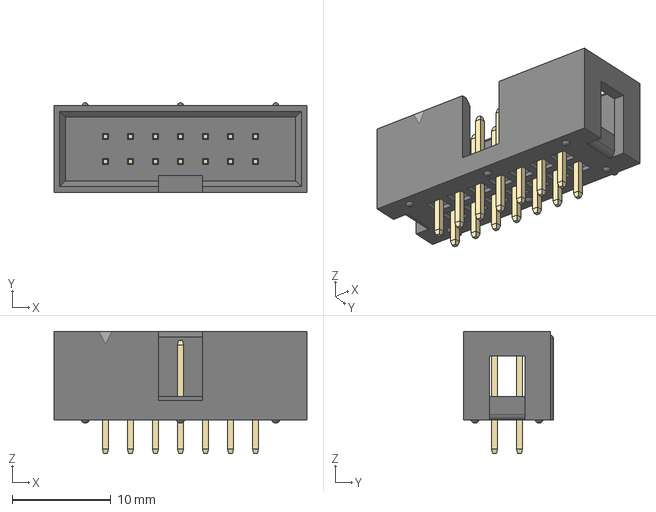
[picture p81: CAD file, 2018-12-04]
kicad-packages3d/connectors TH/rectangular/male/shrouded/vertical/2.54mm/DS1013-14SSiB.stp
25.7 x 9.10 x 12.4 mm
