louiscklaw/kicad_library/kicad-packages3d/connectors TH/rectangular/male/unshrouded/right_angle/2.54mm/DS1022-1x1RDF11.stp

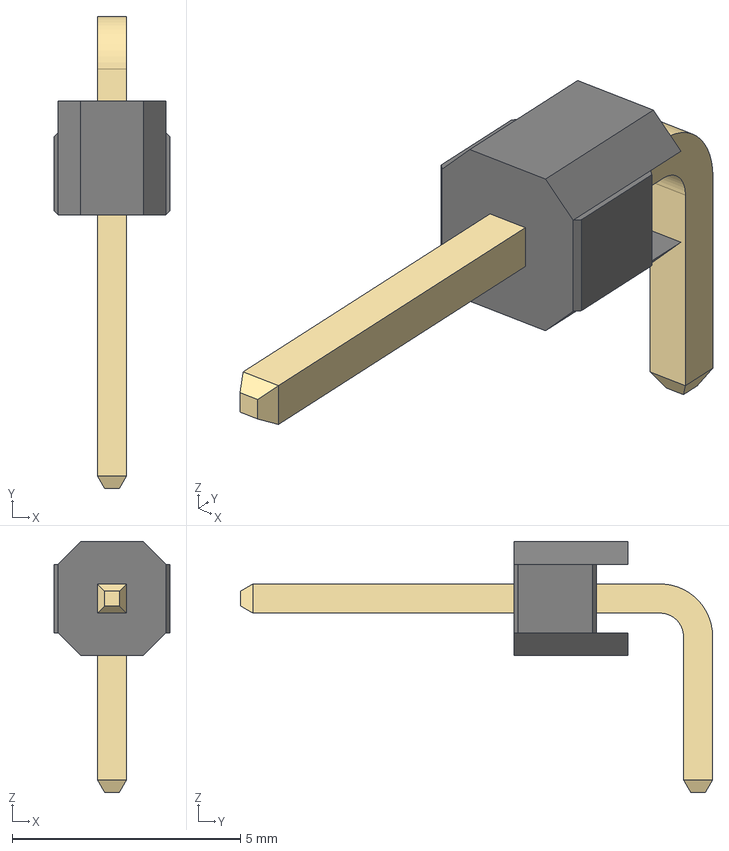
[picture p83: CAD file, 2018-12-04]
kicad-packages3d/connectors TH/rectangular/male/unshrouded/right_angle/2.54mm/DS1022-1x1RDF11.stp
2.54 x 10.4 x 5.50 mm
