louiscklaw/kicad_library/kicad-packages3d/connectors TH/rectangular/male/unshrouded/vertical/1.27mm/DS1031-01-1x5P8BV3-1.stp

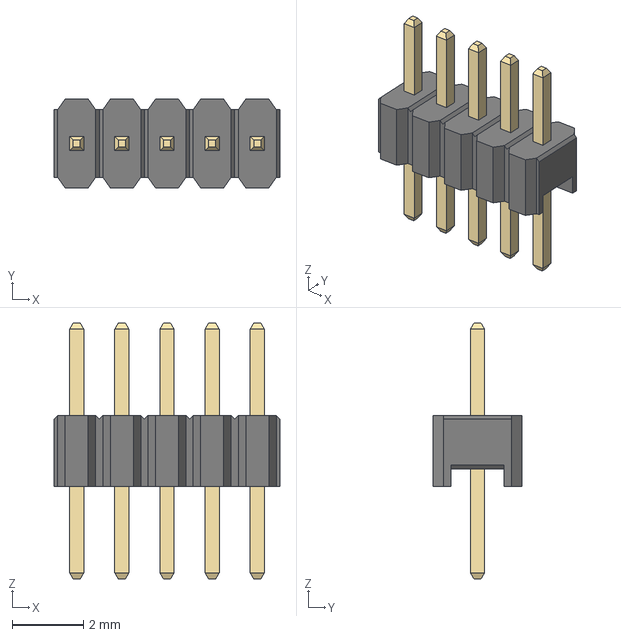
[picture p85: CAD file, 2018-12-04]
kicad-packages3d/connectors TH/rectangular/male/unshrouded/vertical/1.27mm/DS1031-01-1x5P8BV3-1.stp
6.35 x 2.50 x 7.20 mm
