louiscklaw/kicad_library/kicad-packages3d/connectors TH/rectangular/male/unshrouded/vertical/2.54mm/DS1021-2x10SF11.stp

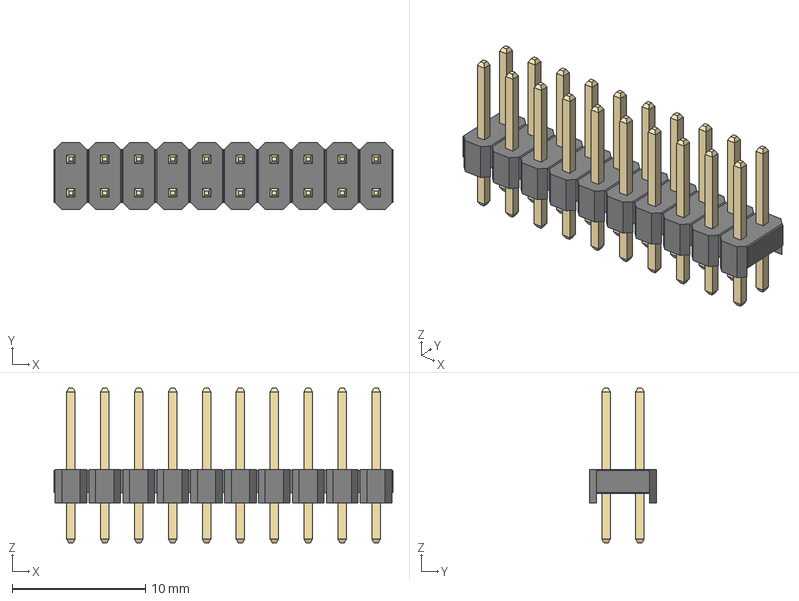
[picture p86: CAD file, 2018-12-04]
kicad-packages3d/connectors TH/rectangular/male/unshrouded/vertical/2.54mm/DS1021-2x10SF11.stp
25.4 x 5.00 x 11.6 mm
