louiscklaw/kicad_library/kicad-packages3d/connectors TH/terminal/TE_1217133-1.stp

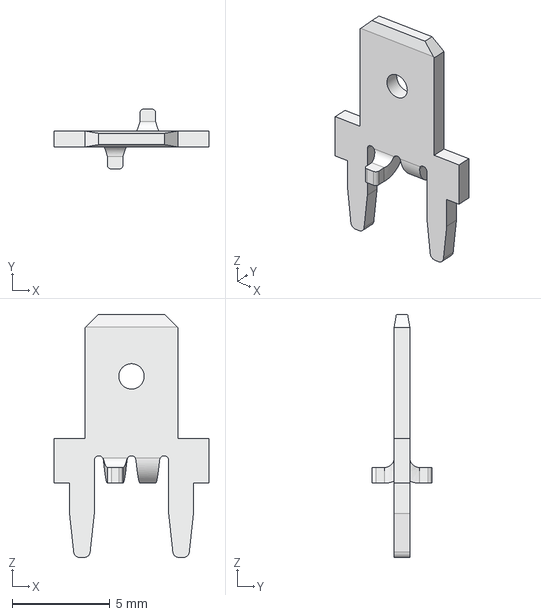
[picture p88: CAD file, 2018-12-04]
kicad-packages3d/connectors TH/terminal/TE_1217133-1.stp
7.92 x 3.08 x 12.5 mm
