louiscklaw/kicad_library/kicad-packages3d/Degson/DG103-5.0-06.stp

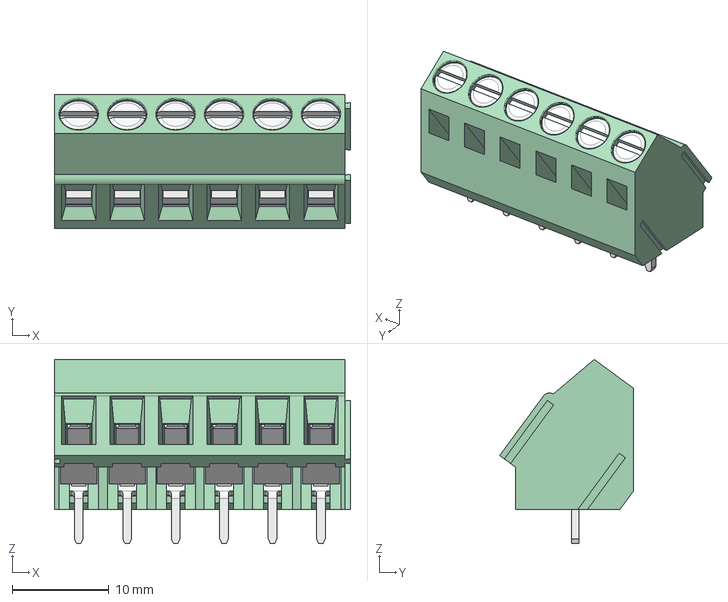
[picture p89: CAD file, 2018-12-04]
kicad-packages3d/Degson/DG103-5.0-06.stp
30.6 x 13.8 x 19.0 mm
