louiscklaw/kicad_library/kicad-packages3d/discrete SMD/DO-219AB.stp

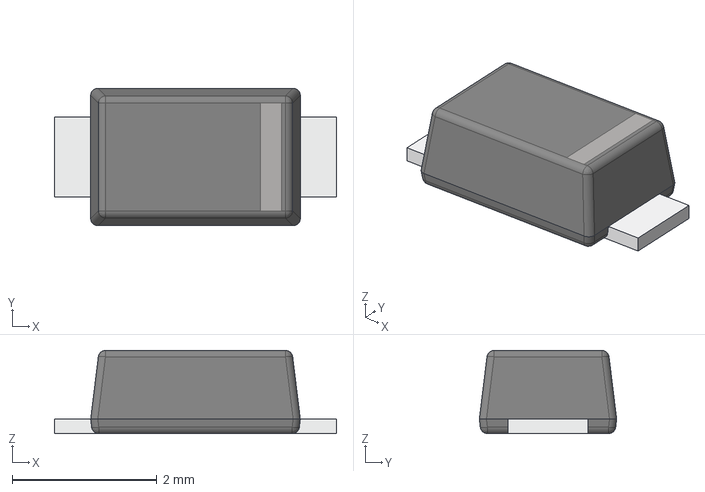
[picture p90: CAD file, 2018-12-04]
kicad-packages3d/discrete SMD/DO-219AB.stp
3.90 x 1.90 x 1.15 mm
