louiscklaw/kicad_library/kicad-packages3d/EDG/DG306-5.STEP

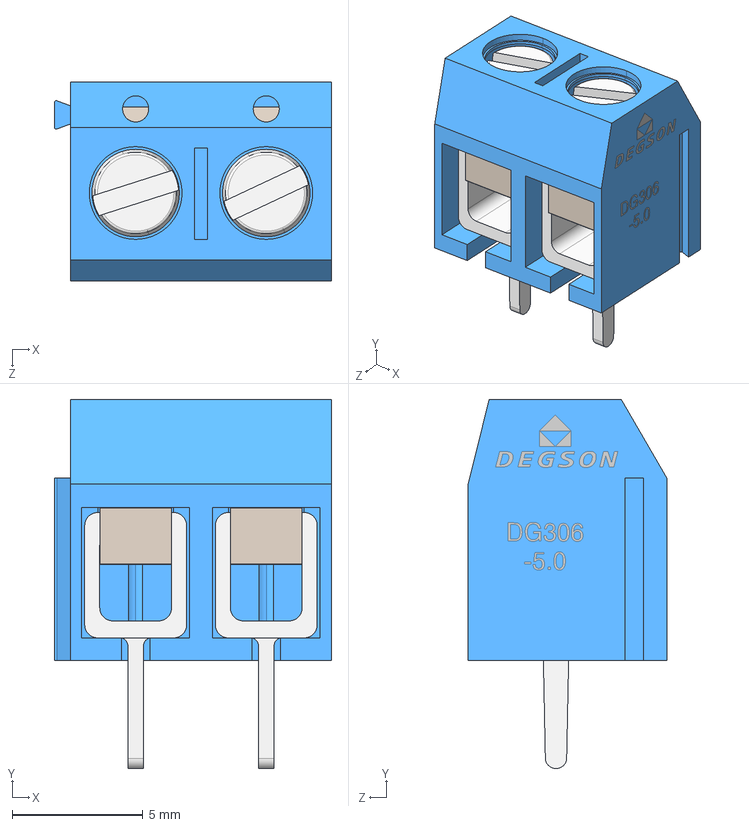
[picture p91: CAD file, 2019-06-20]
kicad-packages3d/EDG/DG306-5.STEP
10.6 x 14.1 x 7.60 mm
Case
Screw x 2
Terminal x 2
Spring x 2
