louiscklaw/kicad_library/kicad-packages3d/FanPinHeader_1x04_P2.54mm_Vertical/FanConnector4pin.stp

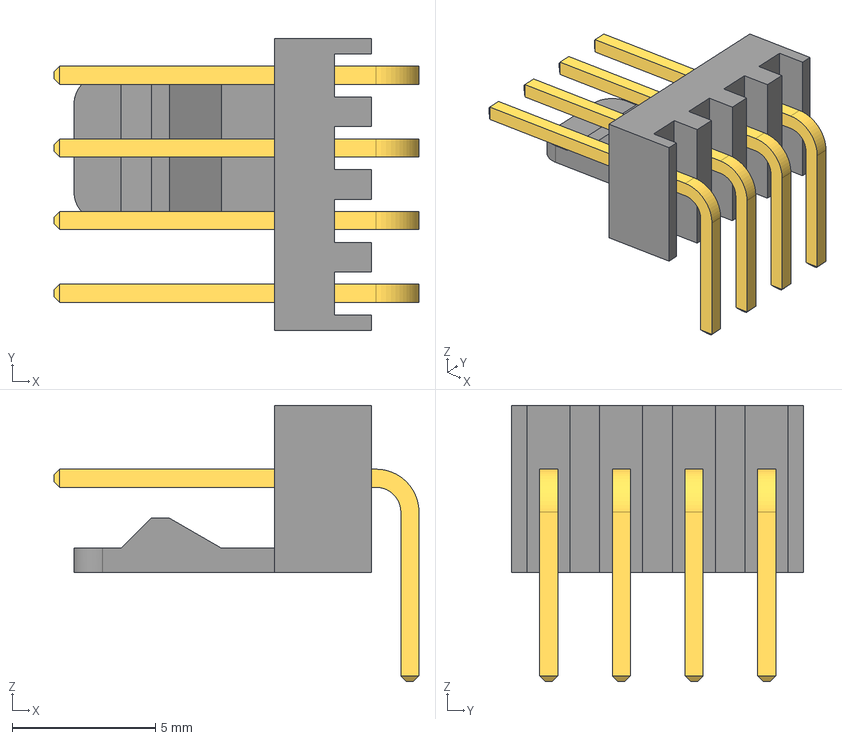
[picture p92: CAD file, 2021-09-17]
kicad-packages3d/FanPinHeader_1x04_P2.54mm_Vertical/FanConnector4pin.stp
12.8 x 10.2 x 9.66 mm
