louiscklaw/kicad_library/kicad-packages3d/IC/MO-187BA-T.stp

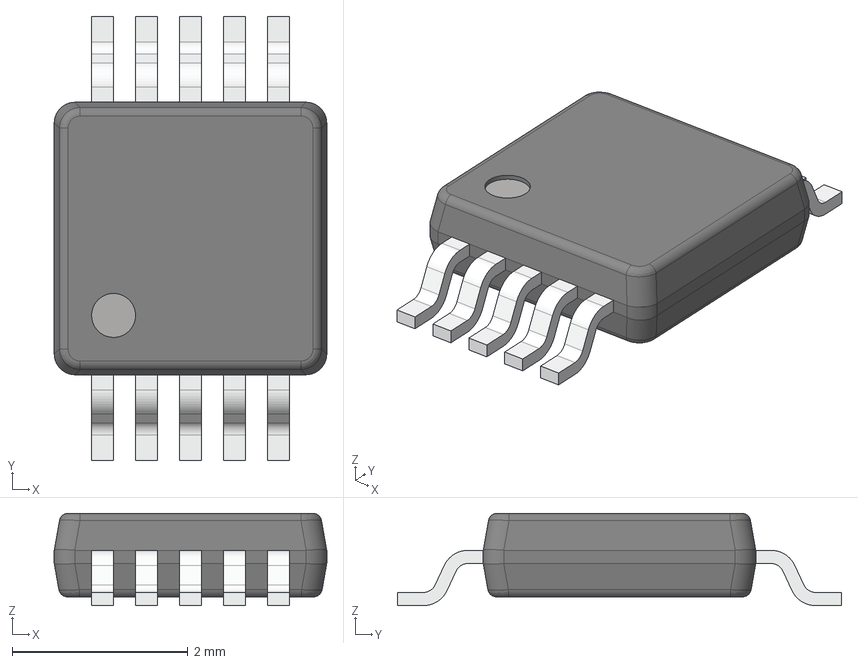
[picture p93: CAD file, 2018-12-04]
kicad-packages3d/IC/MO-187BA-T.stp
3.10 x 5.05 x 1.05 mm
