louiscklaw/kicad_library/kicad-packages3d/keyboard/cherry mx.step

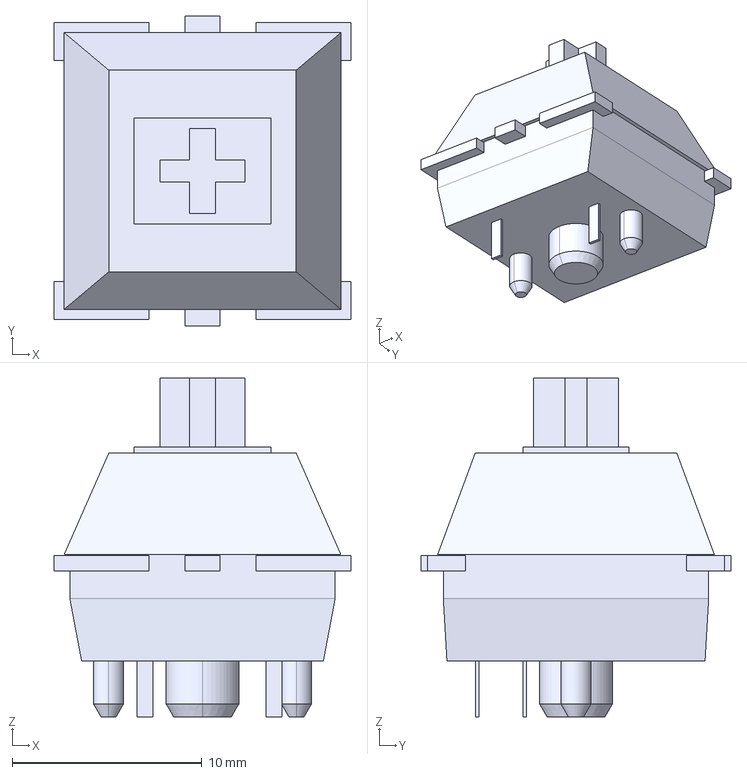
[picture p94: CAD file, 2019-06-03]
kicad-packages3d/keyboard/cherry mx.step
15.6 x 16.3 x 17.9 mm
