louiscklaw/kicad_library/kicad-packages3d/lora/User Library-RA-02.STEP

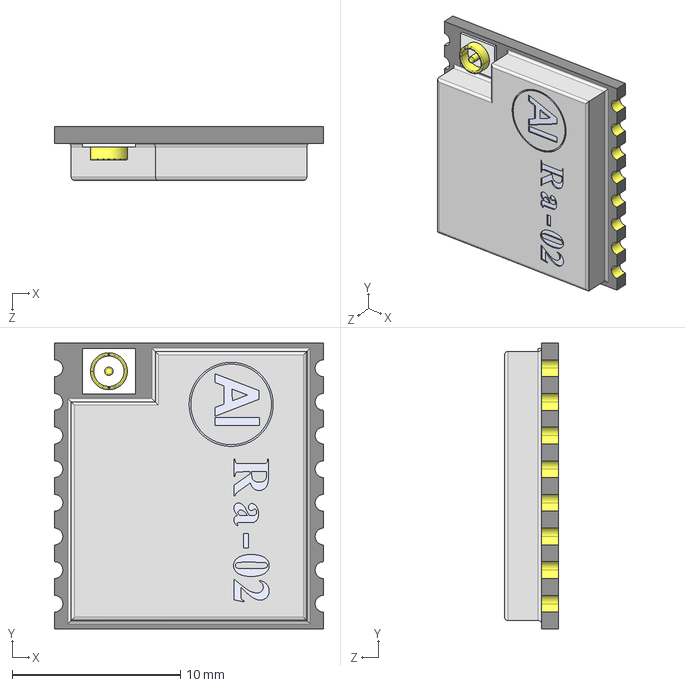
[picture p95: CAD file, 2019-06-10]
kicad-packages3d/lora/User Library-RA-02.STEP
16.0 x 17.0 x 3.20 mm
