louiscklaw/kicad_library/kicad-packages3d/orange-pi-zero/PinSocket_2x13_P254mm_Vertical.step

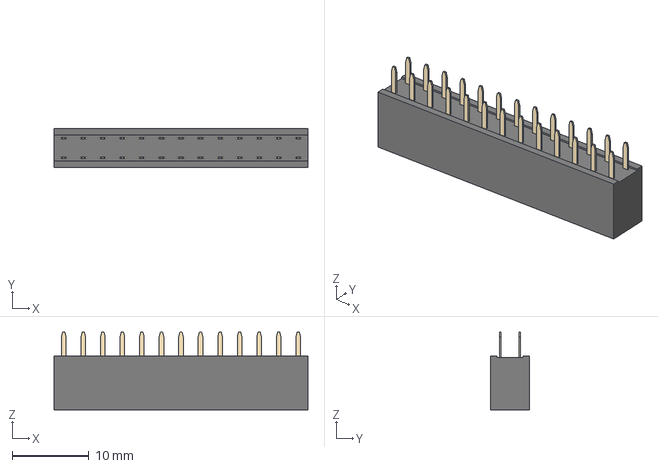
[picture p96: CAD file, 2019-07-07]
kicad-packages3d/orange-pi-zero/PinSocket_2x13_P254mm_Vertical.step
33.0 x 5.08 x 10.1 mm
