louiscklaw/kicad_library/kicad-packages3d/passive smd/Capacitors/CAPAE-D5.0x5.4.stp

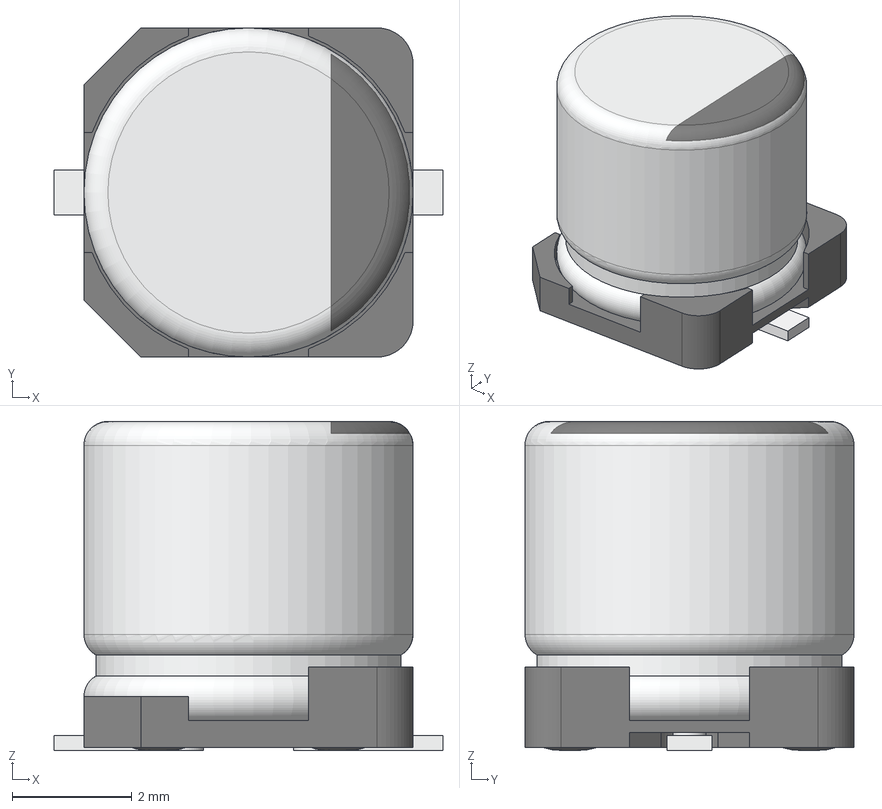
[picture p97: CAD file, 2018-12-04]
kicad-packages3d/passive smd/Capacitors/CAPAE-D5.0x5.4.stp
6.50 x 5.50 x 5.50 mm
