louiscklaw/kicad_library/kicad-packages3d/passive smd/Inductors/SRR1208.stp

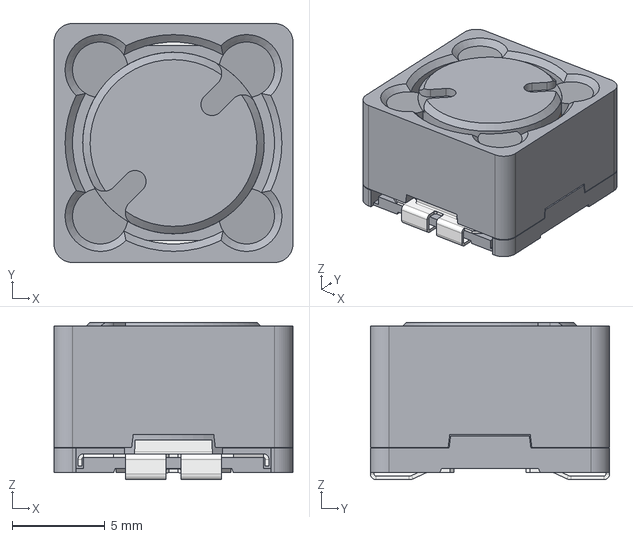
[picture p98: CAD file, 2018-12-04]
kicad-packages3d/passive smd/Inductors/SRR1208.stp
12.9 x 12.9 x 8.50 mm
