louiscklaw/kicad_library/kicad-packages3d/passive smd/Resistors/RESC-0402.stp

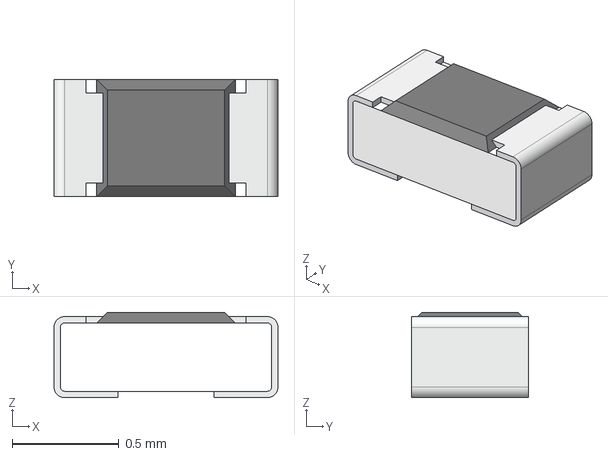
[picture p99: CAD file, 2018-12-04]
kicad-packages3d/passive smd/Resistors/RESC-0402.stp
1.05 x 0.55 x 0.4 mm
