louiscklaw/kicad_library/kicad-packages3d/Relay - SLA-05VDC-SL-C.step

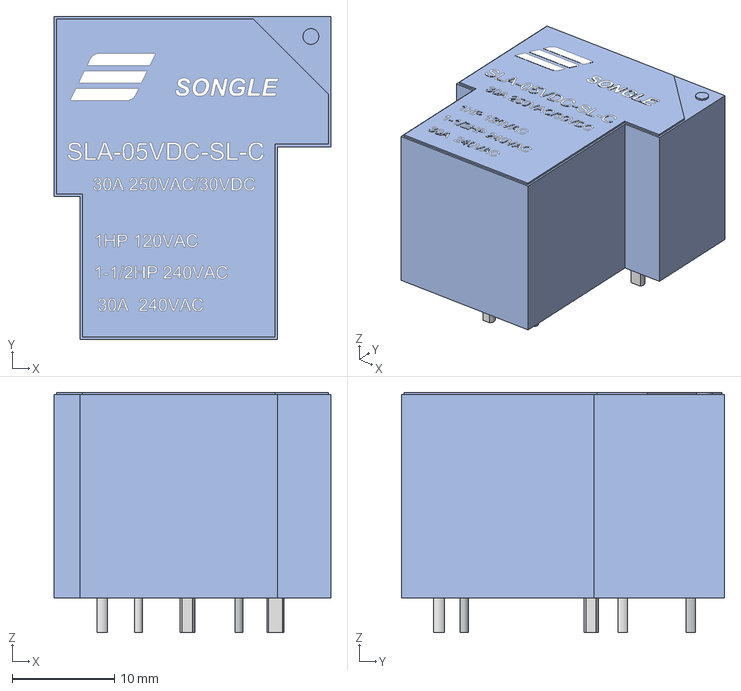
[picture p100: CAD file, 2019-07-06]
kicad-packages3d/Relay - SLA-05VDC-SL-C.step
27.1 x 31.6 x 23.5 mm
