louiscklaw/kicad_library/kicad-packages3d/RJ45/RJ45 Modular Jack - AMP 1-406541-1.stp

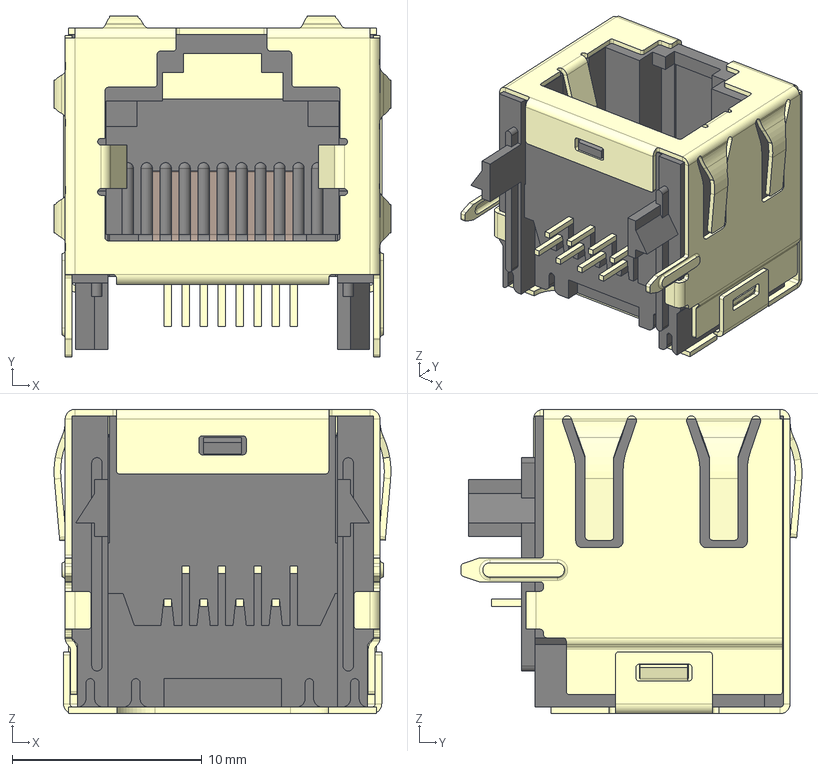
[picture p101: CAD file, 2022-02-03]
kicad-packages3d/RJ45/RJ45 Modular Jack - AMP 1-406541-1.stp
17.8 x 18.0 x 16.1 mm
AMP RJ45 Modular Jack Housing
AMP RJ45 Modular Jack Pin x 8
AMP RJ45 Modular Jack Solder Pin x 8
AMP RJ45 Modular Jack Shield
