louiscklaw/kicad_library/kicad-packages3d/rpi_zero/PinHeader_2x20_P254mm_Vertical.step

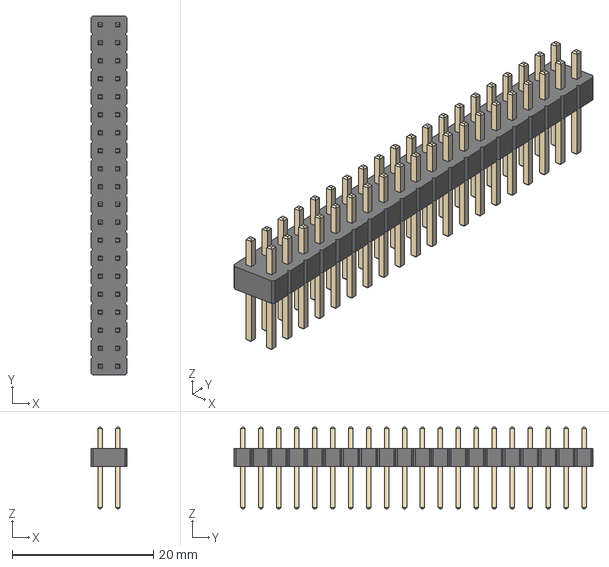
[picture p102: CAD file, 2019-07-12]
kicad-packages3d/rpi_zero/PinHeader_2x20_P254mm_Vertical.step
5.08 x 50.8 x 11.5 mm
