louiscklaw/kicad_library/kicad-packages3d/standoff/Hex Spacer MF M3 L16mm.stp

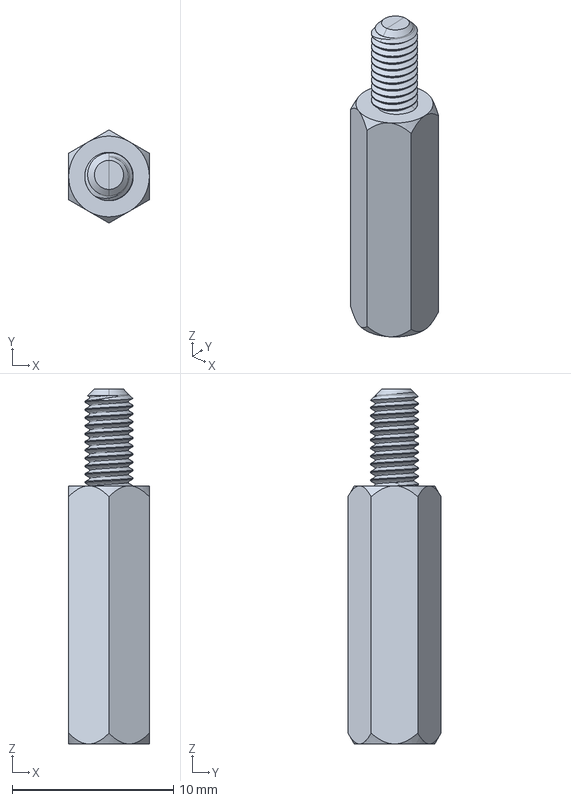
[picture p103: CAD file, 2018-12-04]
kicad-packages3d/standoff/Hex Spacer MF M3 L16mm.stp
5.00 x 5.77 x 22.0 mm
