louiscklaw/kicad_library/components/espressif/ESP-13-wroom-02.stl

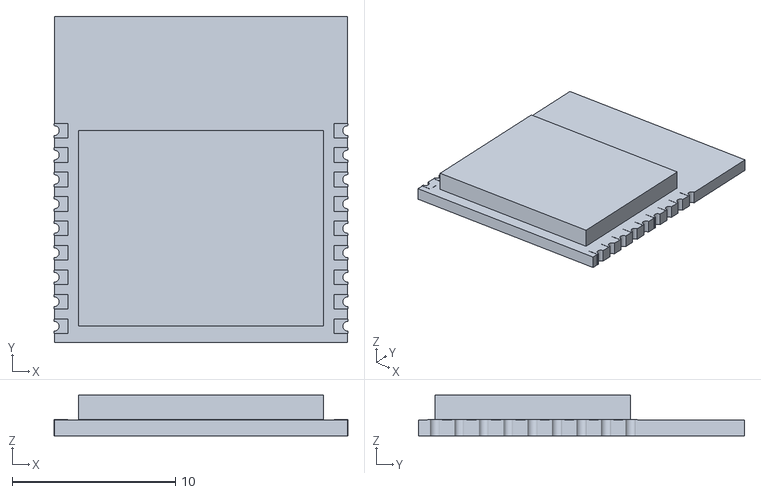
[picture p104: CAD file, 2019-05-08]
components/espressif/ESP-13-wroom-02.stl
18.0 x 20.0 x 2.50
