louiscklaw/kicad_library/generator/kicad-footprint-generator/scripts/Connector/Connector_JST/JST-PH-SMT-SIDE_ENTRY.fcstd

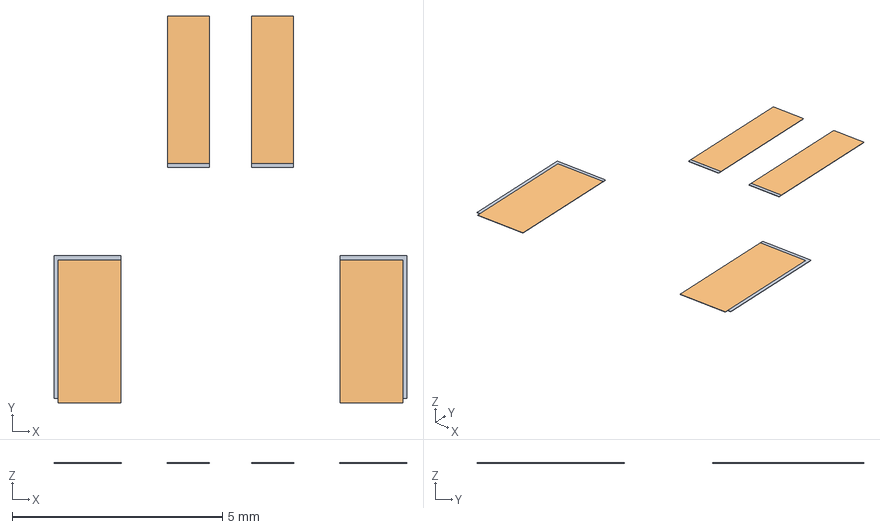
[picture p105: CAD file, 2018-10-22]
generator/kicad-footprint-generator/scripts/Connector/Connector_JST/JST-PH-SMT-SIDE_ENTRY.fcstd
8.40 x 9.20 x 0.01 mm
TopPads
TopPads001
