louiscklaw/kicad_library/kicad-packages3d/15EDGK/15EDGRC-5.08- 08P-14-00A(H).stp

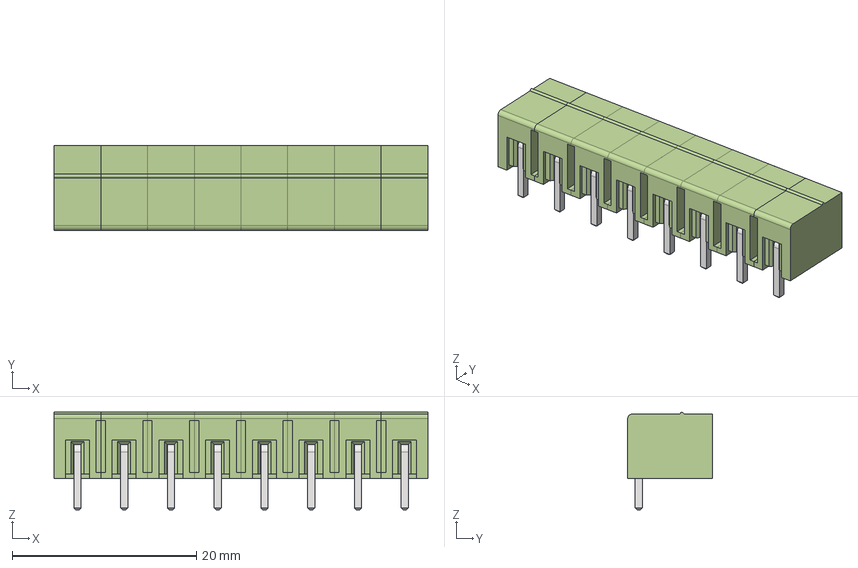
[picture p106: CAD file, 2019-10-14]
kicad-packages3d/15EDGK/15EDGRC-5.08- 08P-14-00A(H).stp
40.6 x 9.20 x 10.6 mm
body_1pc
contact x 8
body_1pc_1
body_1pc_2
body_1pc_3
body_1pc_4
body_1pc_5
body_1pc_6
body_1pc_7
