louiscklaw/kicad_library/kicad-packages3d/connectors TH/DIP_sockets/DIP300-skt-flat-16.stp

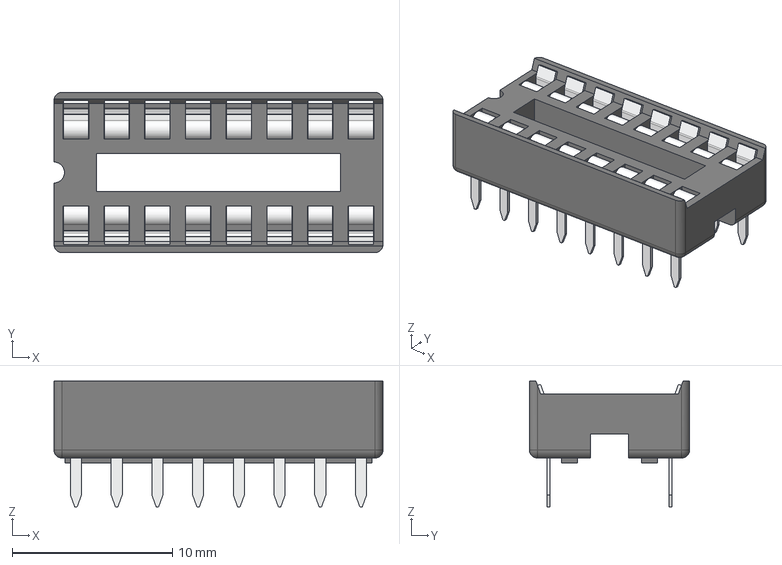
[picture p107: CAD file, 2018-12-04]
kicad-packages3d/connectors TH/DIP_sockets/DIP300-skt-flat-16.stp
20.5 x 10.0 x 7.85 mm
