louiscklaw/kicad_library/kicad-packages3d/connectors TH/rectangular/direct_wire/2.54mm/DS1018-206B.stp

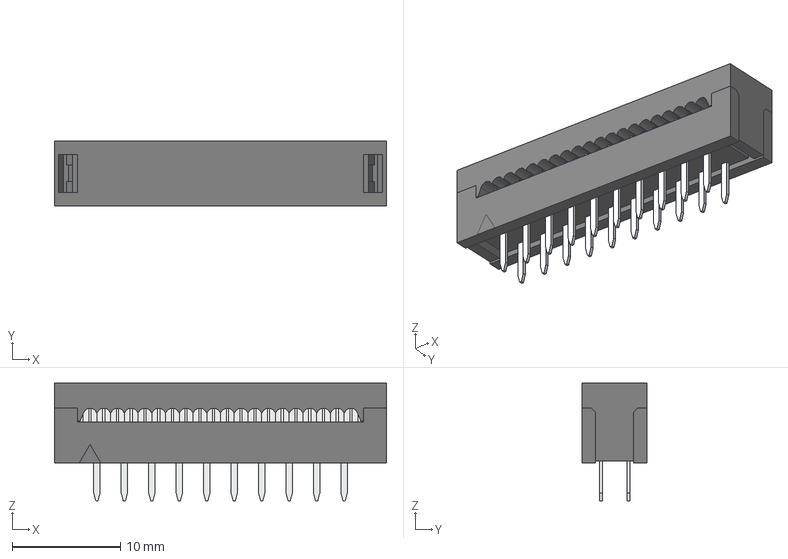
[picture p108: CAD file, 2018-12-04]
kicad-packages3d/connectors TH/rectangular/direct_wire/2.54mm/DS1018-206B.stp
30.7 x 6.03 x 10.9 mm
