louiscklaw/kicad_library/kicad-packages3d/connectors TH/rectangular/female/right_angle/2.54mm/DS1024-1x10RF1.stp

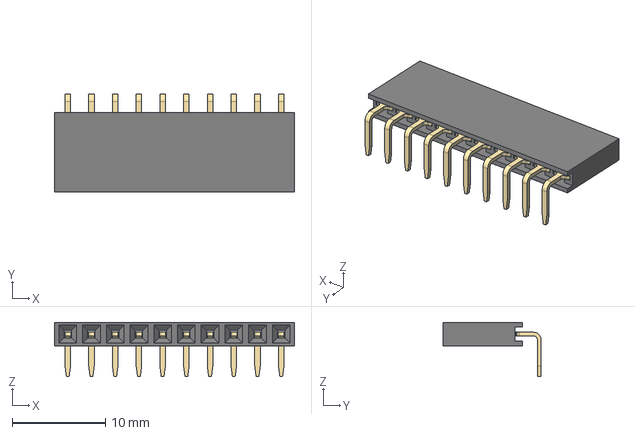
[picture p109: CAD file, 2018-12-04]
kicad-packages3d/connectors TH/rectangular/female/right_angle/2.54mm/DS1024-1x10RF1.stp
25.7 x 10.5 x 5.80 mm
