louiscklaw/kicad_library/kicad-packages3d/connectors TH/rectangular/female/vertical/2.54mm/DS1023-1x1SF11.stp

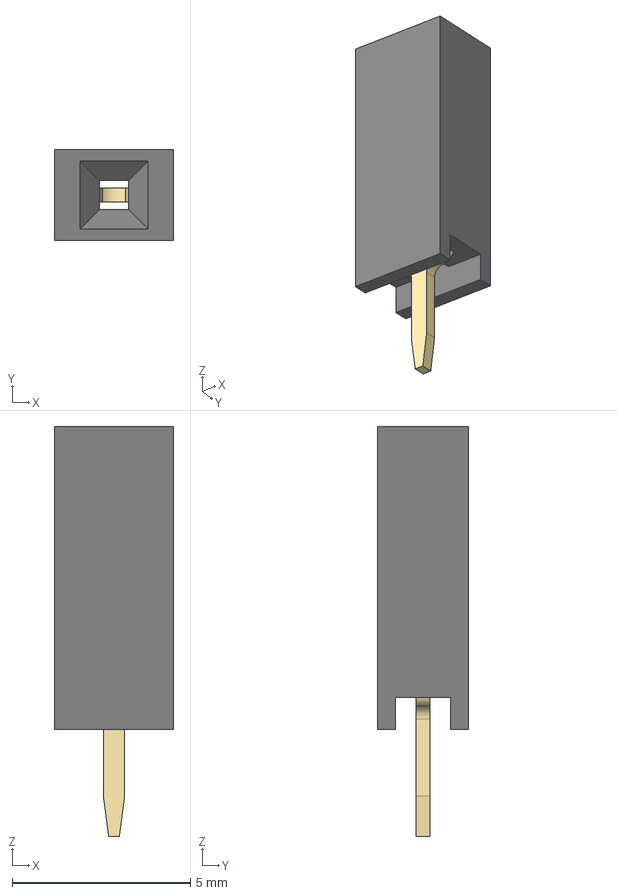
[picture p110: CAD file, 2018-12-04]
kicad-packages3d/connectors TH/rectangular/female/vertical/2.54mm/DS1023-1x1SF11.stp
3.34 x 2.54 x 11.5 mm
