louiscklaw/kicad_library/kicad-packages3d/connectors TH/rectangular/male/shrouded/right_angle/2.54mm/DS1013-10RSiB.stp

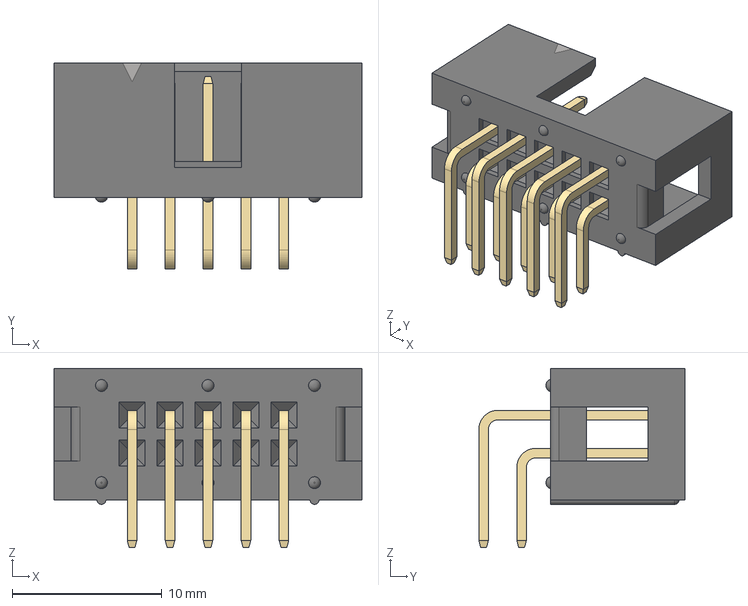
[picture p112: CAD file, 2018-12-04]
kicad-packages3d/connectors TH/rectangular/male/shrouded/right_angle/2.54mm/DS1013-10RSiB.stp
20.6 x 13.8 x 12.0 mm
