louiscklaw/kicad_library/kicad-packages3d/connectors TH/rectangular/male/unshrouded/right_angle/2.54mm/DS1022-2x7R61.stp

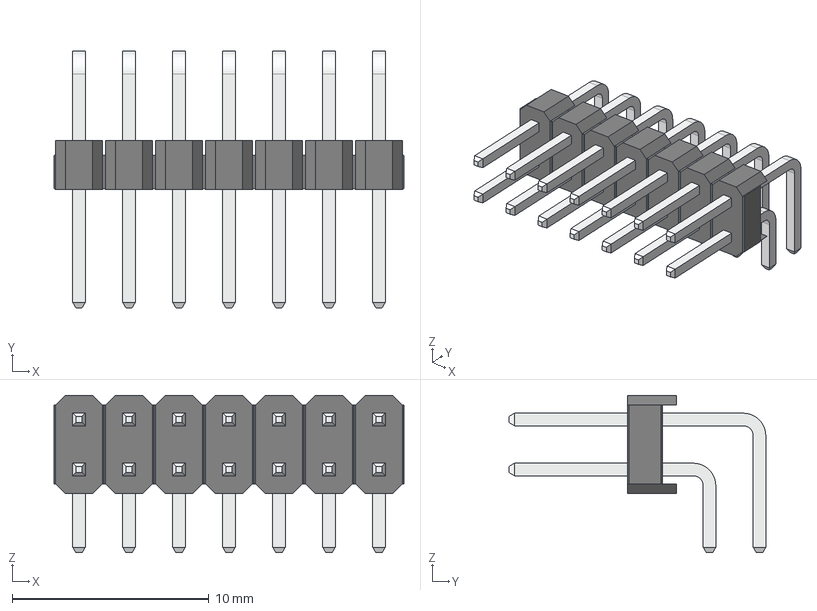
[picture p116: CAD file, 2018-12-04]
kicad-packages3d/connectors TH/rectangular/male/unshrouded/right_angle/2.54mm/DS1022-2x7R61.stp
17.8 x 13.0 x 8.00 mm
