louiscklaw/kicad_library/kicad-packages3d/connectors TH/rectangular/male/unshrouded/right_angle/3.96mm/DS1072-3MRT6.stp

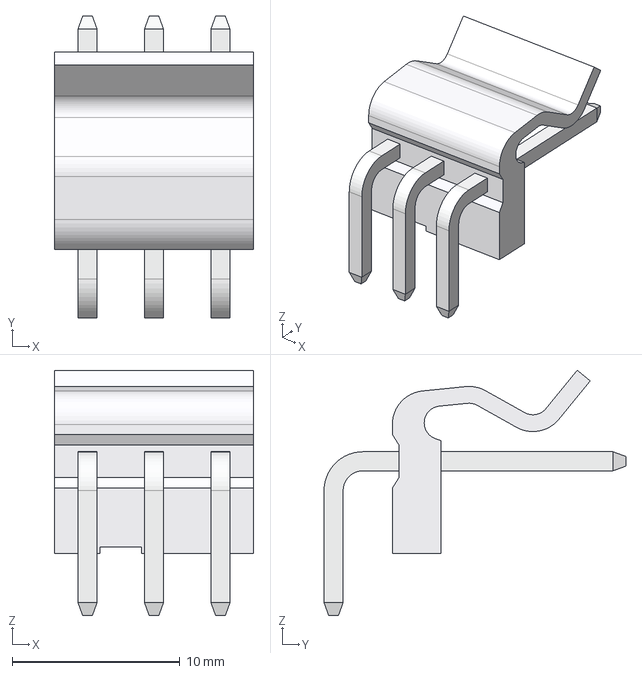
[picture p117: CAD file, 2018-12-04]
kicad-packages3d/connectors TH/rectangular/male/unshrouded/right_angle/3.96mm/DS1072-3MRT6.stp
11.9 x 18.0 x 14.6 mm
