louiscklaw/kicad_library/kicad-packages3d/connectors TH/rectangular/male/unshrouded/vertical/1.27mm/DS1031-01-1x6P8BV2-1.stp

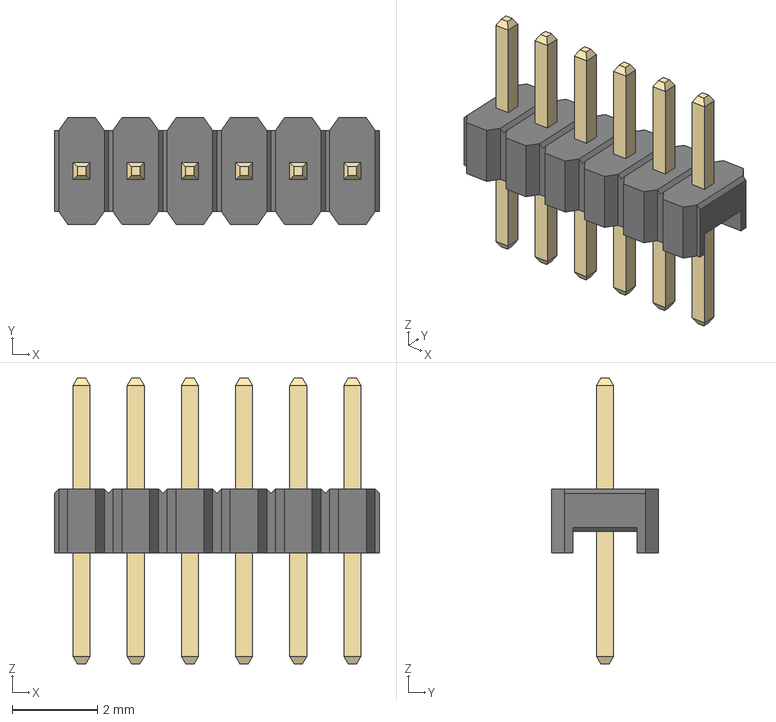
[picture p118: CAD file, 2018-12-04]
kicad-packages3d/connectors TH/rectangular/male/unshrouded/vertical/1.27mm/DS1031-01-1x6P8BV2-1.stp
7.62 x 2.50 x 6.70 mm
