louiscklaw/kicad_library/kicad-packages3d/connectors TH/rectangular/male/unshrouded/vertical/2.54mm/DS1021-1x2S61.stp

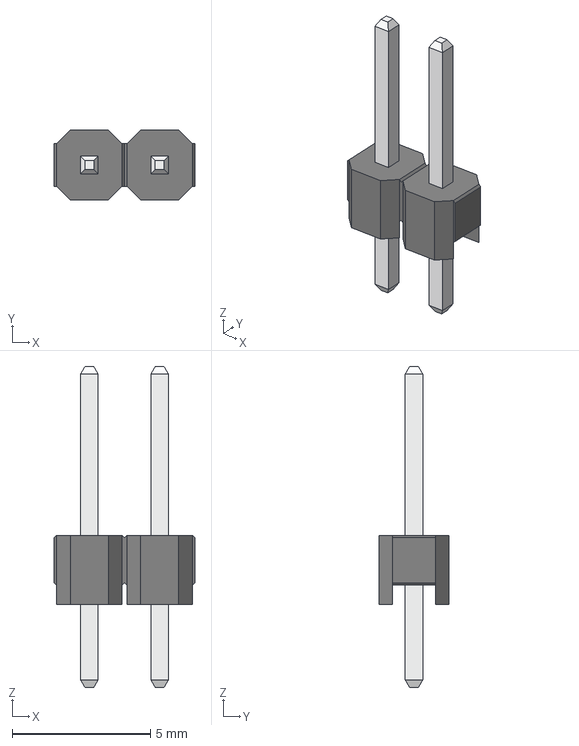
[picture p119: CAD file, 2018-12-04]
kicad-packages3d/connectors TH/rectangular/male/unshrouded/vertical/2.54mm/DS1021-1x2S61.stp
5.08 x 2.54 x 11.6 mm
