louiscklaw/kicad_library/kicad-packages3d/connectors TH/rectangular/male/unshrouded/vertical/5.08mm/10-32-1071.stp

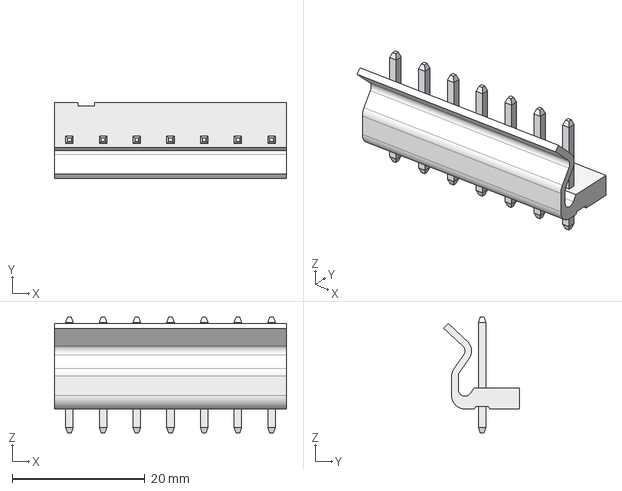
[picture p120: CAD file, 2018-12-04]
kicad-packages3d/connectors TH/rectangular/male/unshrouded/vertical/5.08mm/10-32-1071.stp
35.0 x 11.4 x 17.4 mm
