louiscklaw/kicad_library/kicad-packages3d/connectors TH/terminal/Keystone_1212.stp

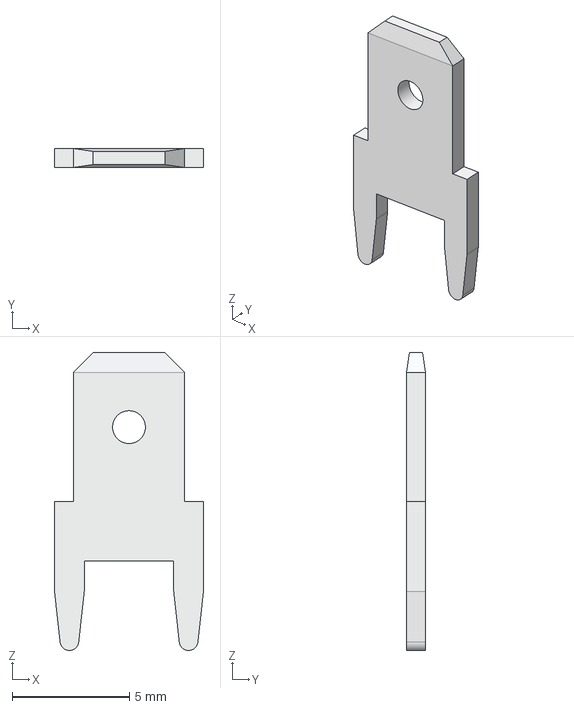
[picture p121: CAD file, 2018-12-04]
kicad-packages3d/connectors TH/terminal/Keystone_1212.stp
6.35 x 0.81 x 12.7 mm
