louiscklaw/kicad_library/kicad-packages3d/Degson/DG103-5.0-04.stp

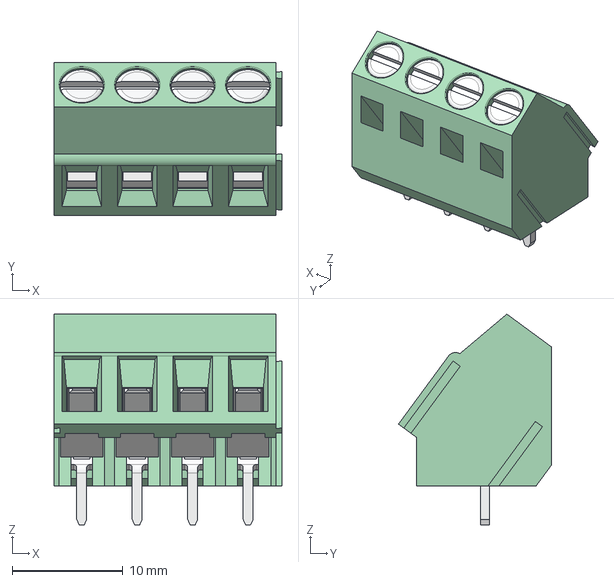
[picture p122: CAD file, 2018-12-04]
kicad-packages3d/Degson/DG103-5.0-04.stp
20.6 x 13.8 x 19.0 mm
