louiscklaw/kicad_library/kicad-packages3d/discrete SMD/DO-221BB.stp

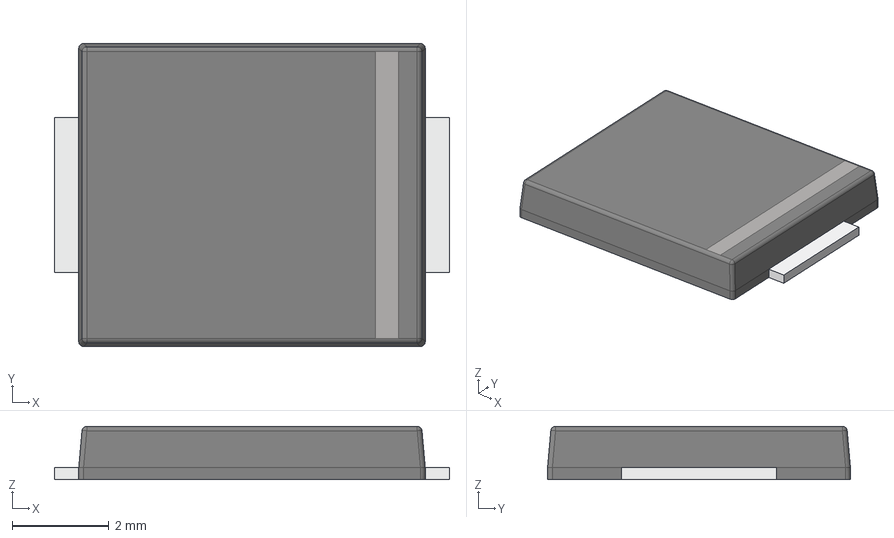
[picture p123: CAD file, 2018-12-04]
kicad-packages3d/discrete SMD/DO-221BB.stp
8.15 x 6.25 x 1.10 mm
