louiscklaw/kicad_library/kicad-packages3d/IC/MO-153AA.stp

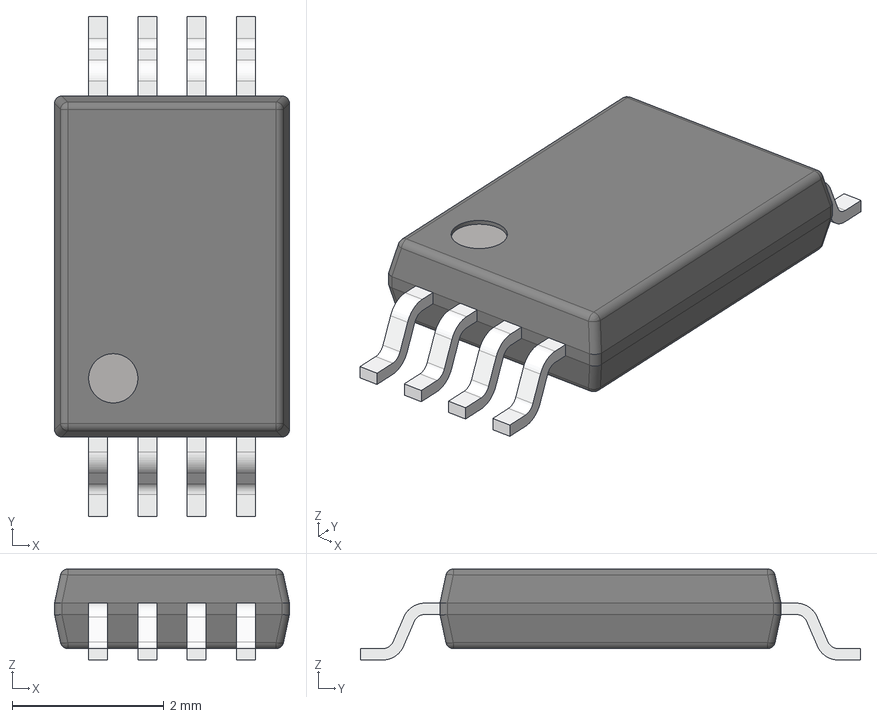
[picture p124: CAD file, 2018-12-04]
kicad-packages3d/IC/MO-153AA.stp
3.10 x 6.60 x 1.20 mm
