louiscklaw/kicad_library/kicad-packages3d/keyboard/Cherry MX Keycap.STL

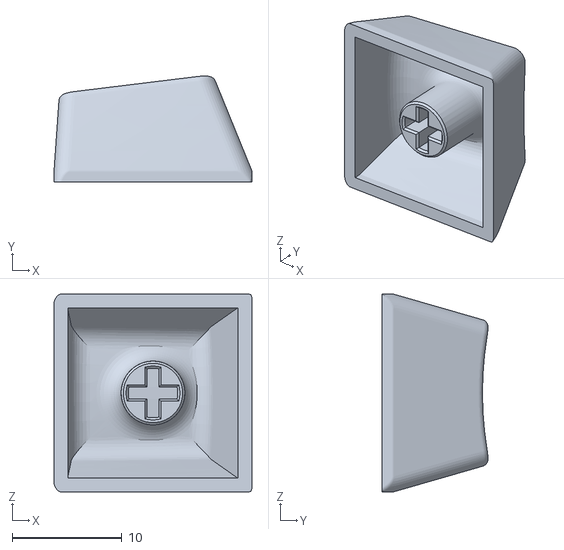
[picture p125: CAD file, 2019-06-03]
kicad-packages3d/keyboard/Cherry MX Keycap.STL
18.0 x 9.63 x 18.0
