louiscklaw/kicad_library/kicad-packages3d/passive smd/Capacitors/CAPM-TANTD-YL.stp

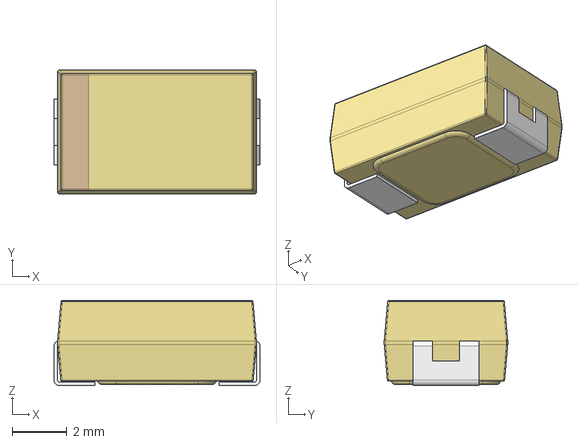
[picture p126: CAD file, 2018-12-04]
kicad-packages3d/passive smd/Capacitors/CAPM-TANTD-YL.stp
7.50 x 4.50 x 3.10 mm
