louiscklaw/kicad_library/kicad-packages3d/passive smd/Inductors/CDRH3D16.stp

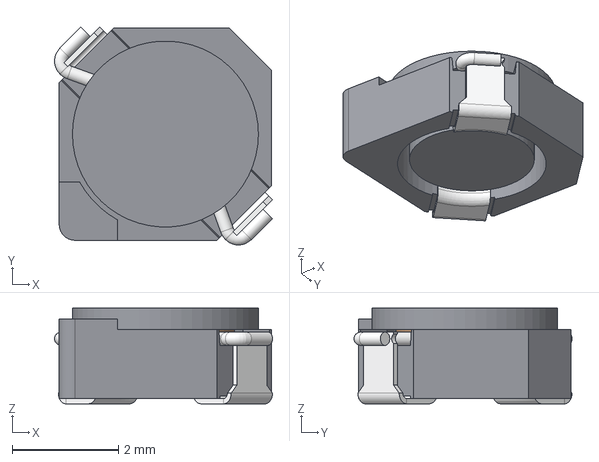
[picture p127: CAD file, 2018-12-04]
kicad-packages3d/passive smd/Inductors/CDRH3D16.stp
4.10 x 4.10 x 1.80 mm
