louiscklaw/kicad_library/kicad-packages3d/passive smd/Resistors/CAT16-x8.stp

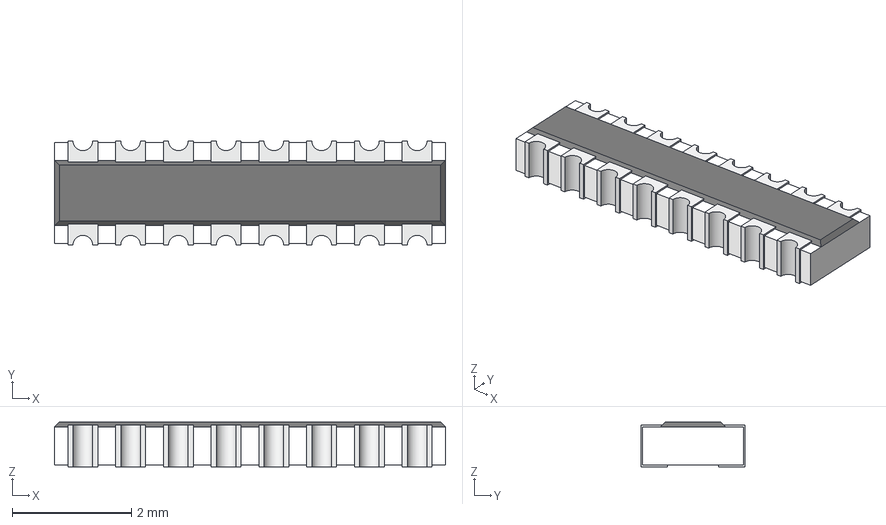
[picture p128: CAD file, 2018-12-04]
kicad-packages3d/passive smd/Resistors/CAT16-x8.stp
6.55 x 1.75 x 0.75 mm
