louiscklaw/kicad_library/kicad-packages3d/Relay - G3MB-202P.step

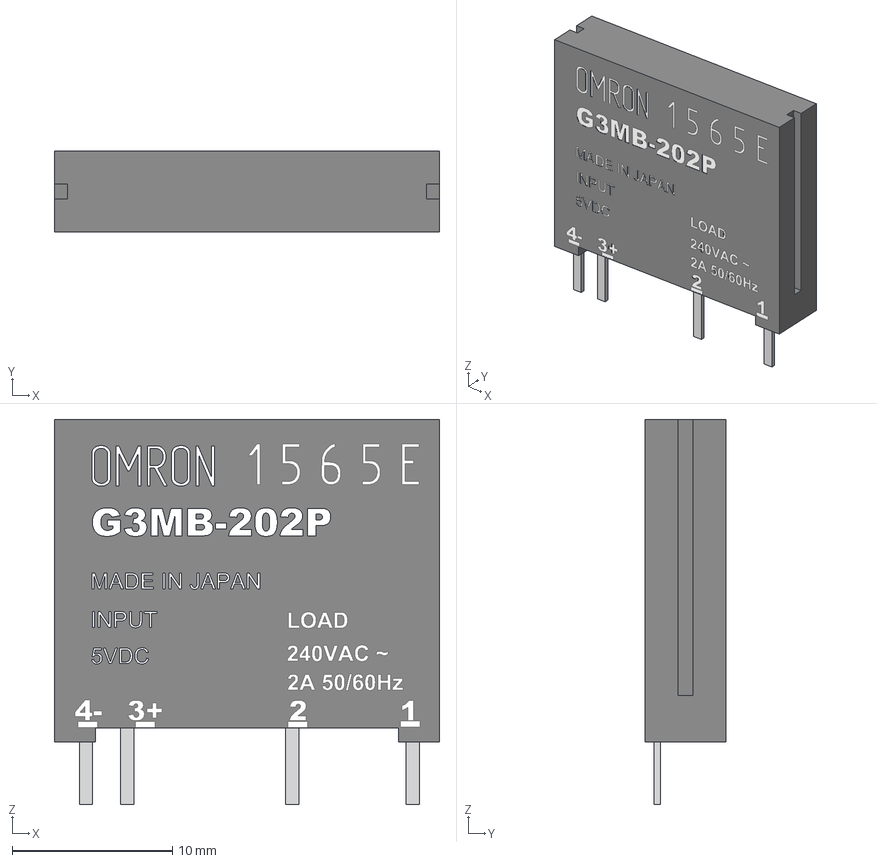
[picture p129: CAD file, 2019-07-06]
kicad-packages3d/Relay - G3MB-202P.step
24.1 x 5.08 x 24.1 mm
