louiscklaw/kicad_library/kicad-packages3d/standoff/Hex Spacer MF M3 L17mm.stp

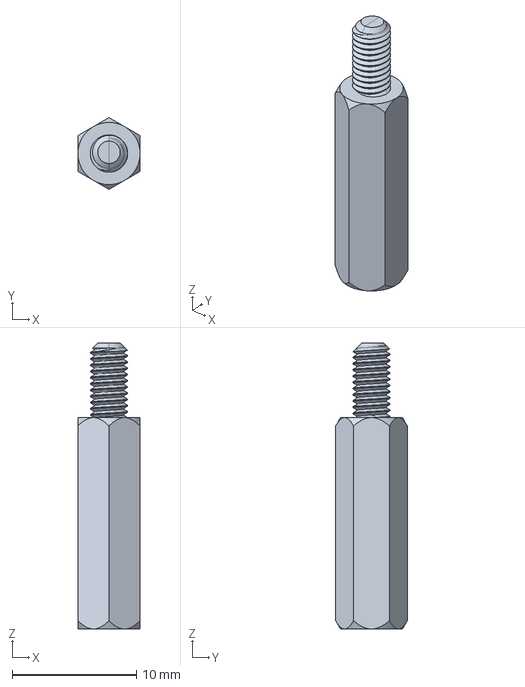
[picture p131: CAD file, 2018-12-04]
kicad-packages3d/standoff/Hex Spacer MF M3 L17mm.stp
5.00 x 5.77 x 23.0 mm
