louiscklaw/kicad_library/kicad-packages3d/terminal block/PCB terminal block FFKDS 5.08_9.STEP

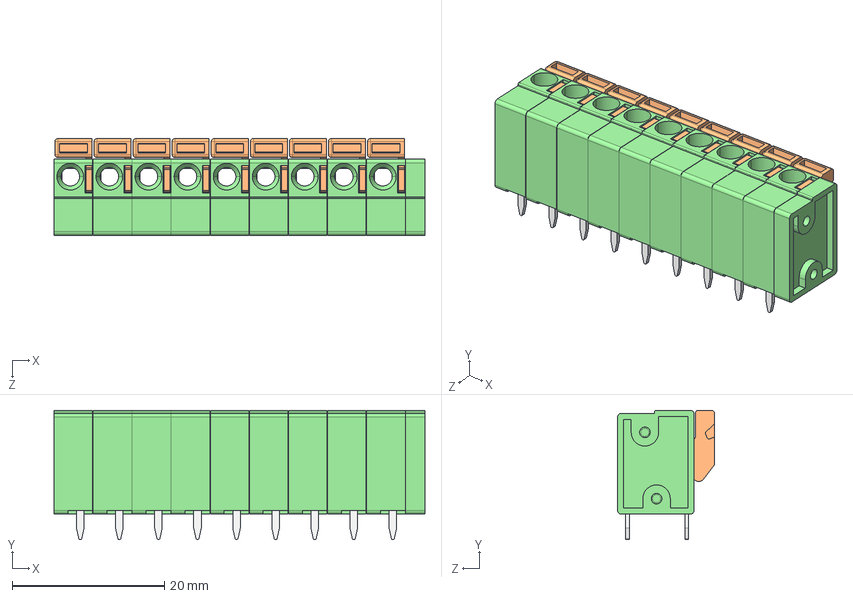
[picture p132: CAD file, 2018-12-04]
kicad-packages3d/terminal block/PCB terminal block FFKDS 5.08_9.STEP
48.7 x 17.0 x 12.7 mm
FFKDS 5.08 x 9
FFKDS CAP
