louiscklaw/kicad_library/kicad-packages3d/connectors TH/DIP_sockets/DIP300-skt-flat-20.stp

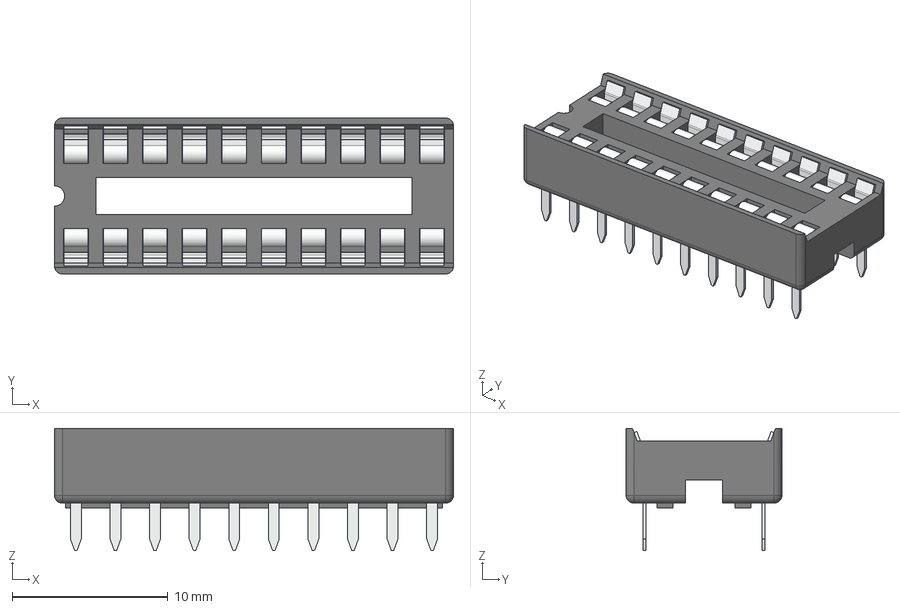
[picture p134: CAD file, 2018-12-04]
kicad-packages3d/connectors TH/DIP_sockets/DIP300-skt-flat-20.stp
25.6 x 10.0 x 7.85 mm
