louiscklaw/kicad_library/kicad-packages3d/connectors TH/rectangular/direct_wire/2.54mm/DS1018-146B.stp

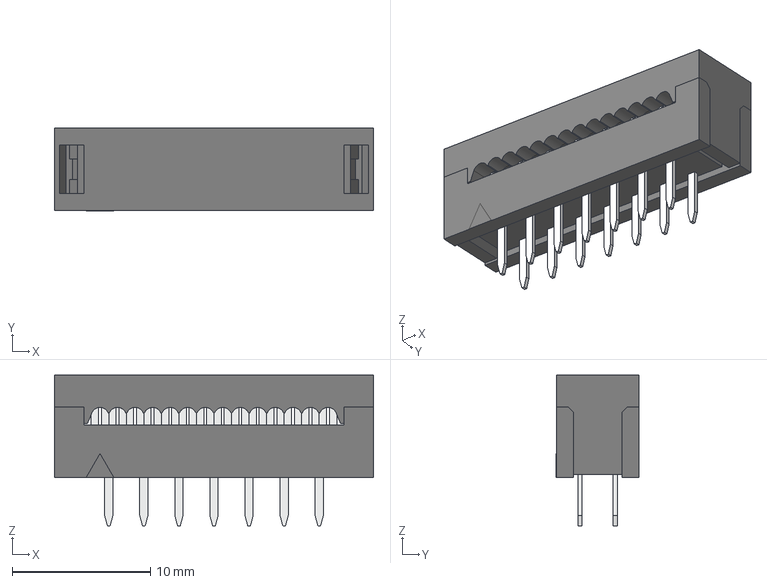
[picture p135: CAD file, 2018-12-04]
kicad-packages3d/connectors TH/rectangular/direct_wire/2.54mm/DS1018-146B.stp
23.1 x 6.03 x 10.9 mm
