louiscklaw/kicad_library/kicad-packages3d/connectors TH/rectangular/female/vertical/2.54mm/DS1023-2x8SF11.stp

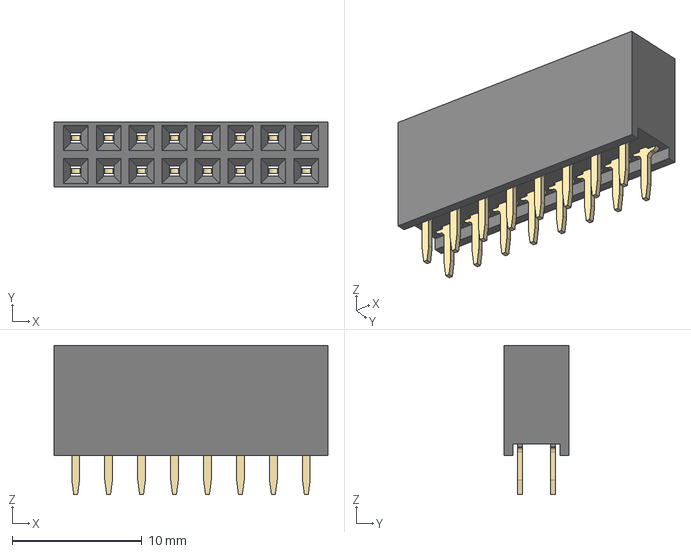
[picture p137: CAD file, 2018-12-04]
kicad-packages3d/connectors TH/rectangular/female/vertical/2.54mm/DS1023-2x8SF11.stp
21.1 x 5.00 x 11.5 mm
