louiscklaw/kicad_library/kicad-packages3d/connectors TH/rectangular/female/vertical/2.54mm/Samtec/SL-107-TT-10.stp

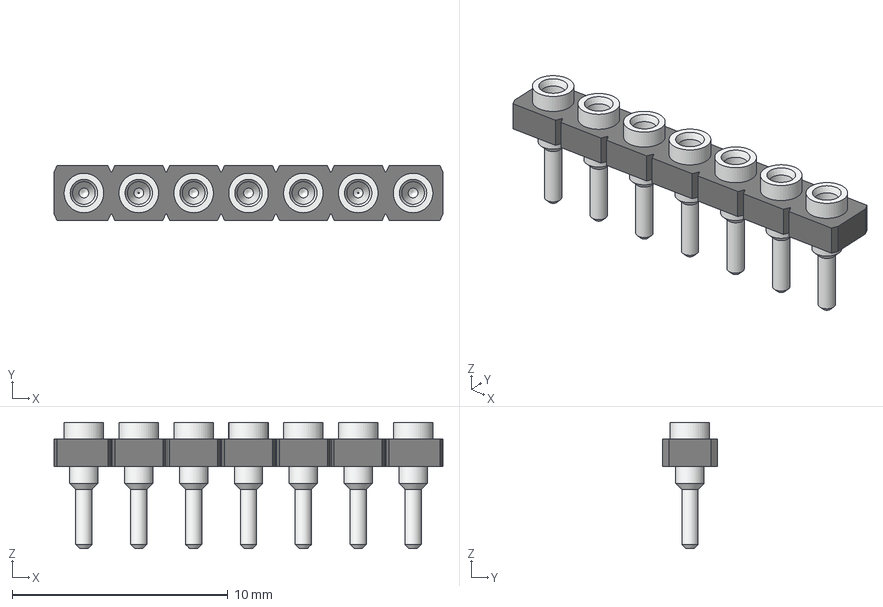
[picture p138: CAD file, 2018-12-04]
kicad-packages3d/connectors TH/rectangular/female/vertical/2.54mm/Samtec/SL-107-TT-10.stp
18.0 x 2.54 x 5.84 mm
