louiscklaw/kicad_library/kicad-packages3d/connectors TH/rectangular/male/unshrouded/right_angle/2.54mm/DS1022-2x4RF11.stp

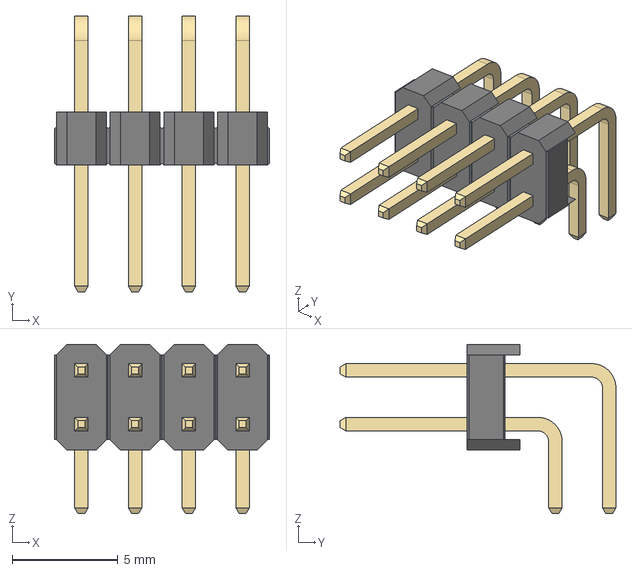
[picture p143: CAD file, 2018-12-04]
kicad-packages3d/connectors TH/rectangular/male/unshrouded/right_angle/2.54mm/DS1022-2x4RF11.stp
10.2 x 13.0 x 8.00 mm
