louiscklaw/kicad_library/kicad-packages3d/Degson/DG128-5.0-08.stp

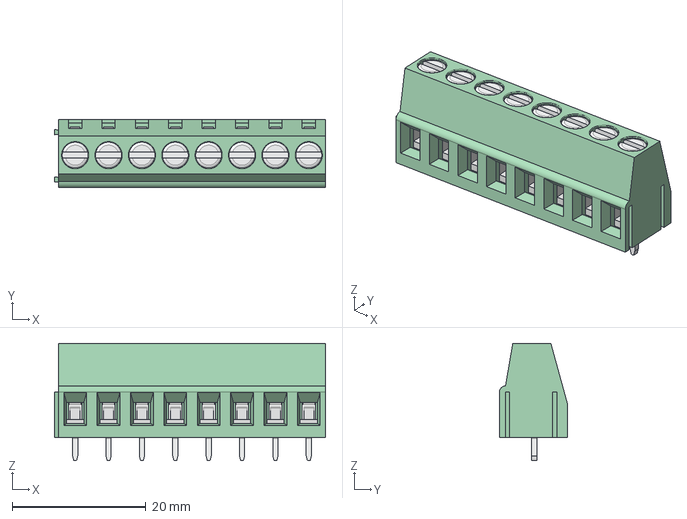
[picture p149: CAD file, 2018-12-04]
kicad-packages3d/Degson/DG128-5.0-08.stp
40.6 x 10.2 x 17.6 mm
