louiscklaw/kicad_library/kicad-packages3d/discrete SMD/SC-75.stp

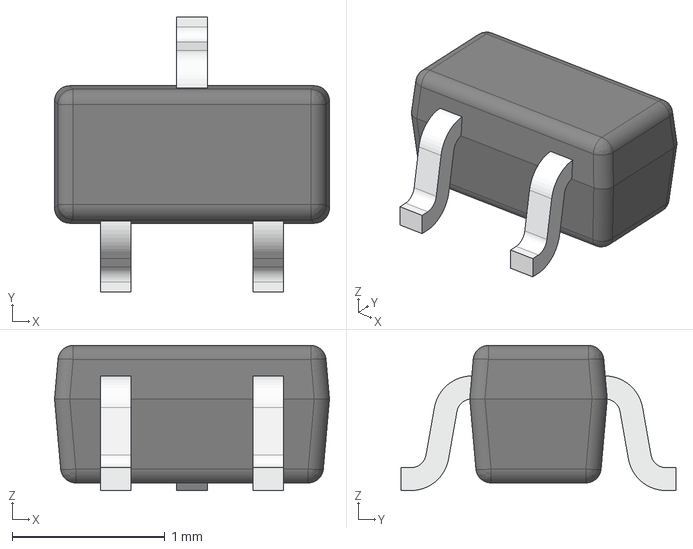
[picture p150: CAD file, 2018-12-04]
kicad-packages3d/discrete SMD/SC-75.stp
1.80 x 1.80 x 0.95 mm
