louiscklaw/kicad_library/kicad-packages3d/IC/8S2.stp

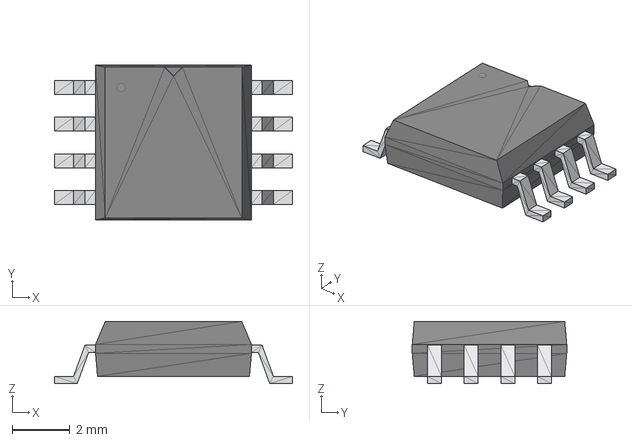
[picture p151: CAD file, 2018-12-04]
kicad-packages3d/IC/8S2.stp
8.25 x 5.36 x 2.16 mm
