louiscklaw/kicad_library/kicad-packages3d/passive smd/Capacitors/CAPM-TANTN-BK.stp

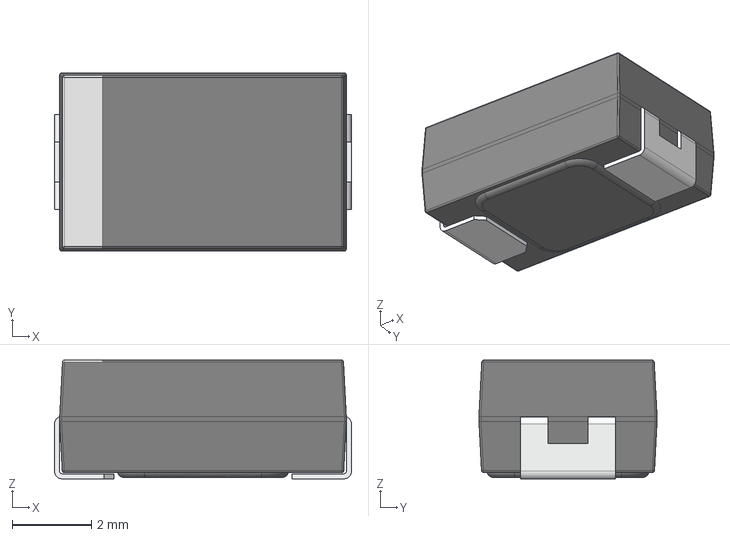
[picture p152: CAD file, 2018-12-04]
kicad-packages3d/passive smd/Capacitors/CAPM-TANTN-BK.stp
7.50 x 4.50 x 3.00 mm
