louiscklaw/kicad_library/kicad-packages3d/passive smd/Inductors/SRN4018.stp

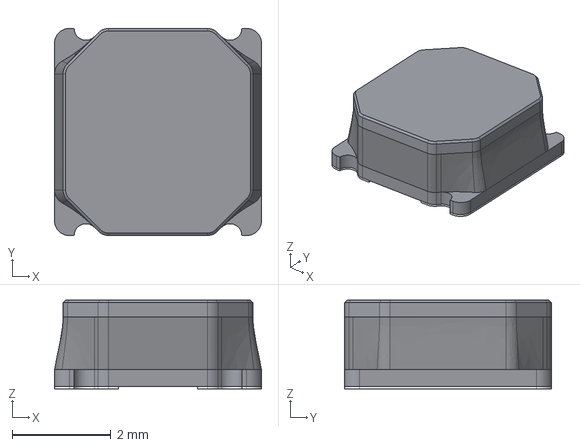
[picture p153: CAD file, 2018-12-04]
kicad-packages3d/passive smd/Inductors/SRN4018.stp
4.20 x 4.20 x 1.80 mm
