louiscklaw/kicad_library/kicad-packages3d/passive smd/Resistors/RESC-0603.stp

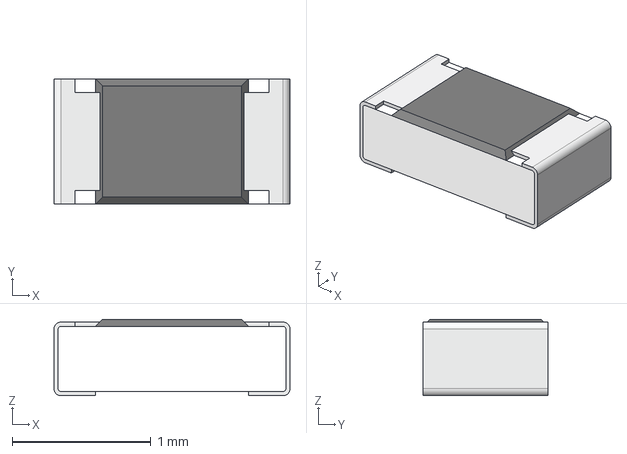
[picture p154: CAD file, 2018-12-04]
kicad-packages3d/passive smd/Resistors/RESC-0603.stp
1.70 x 0.9 x 0.55 mm
