louiscklaw/kicad_library/kicad-packages3d/standoff/Hex Spacer MF M3 L19mm.stp

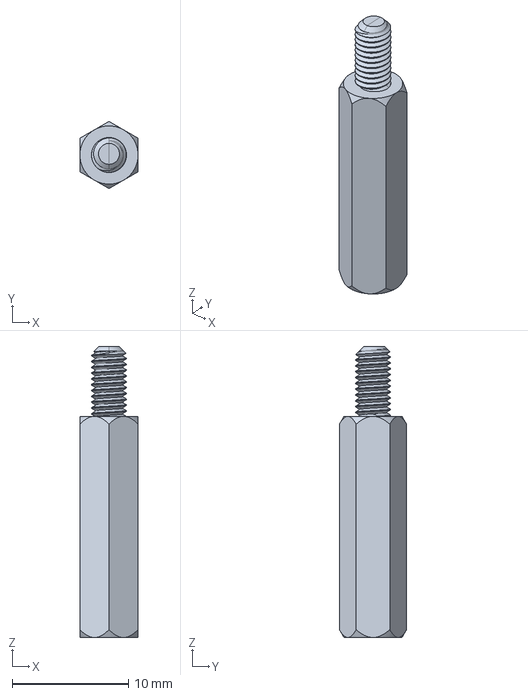
[picture p155: CAD file, 2018-12-04]
kicad-packages3d/standoff/Hex Spacer MF M3 L19mm.stp
5.00 x 5.77 x 25.0 mm
