louiscklaw/kicad_library/kicad-packages3d/terminal block/DG243-5.0-02P-11-00A(H).stp

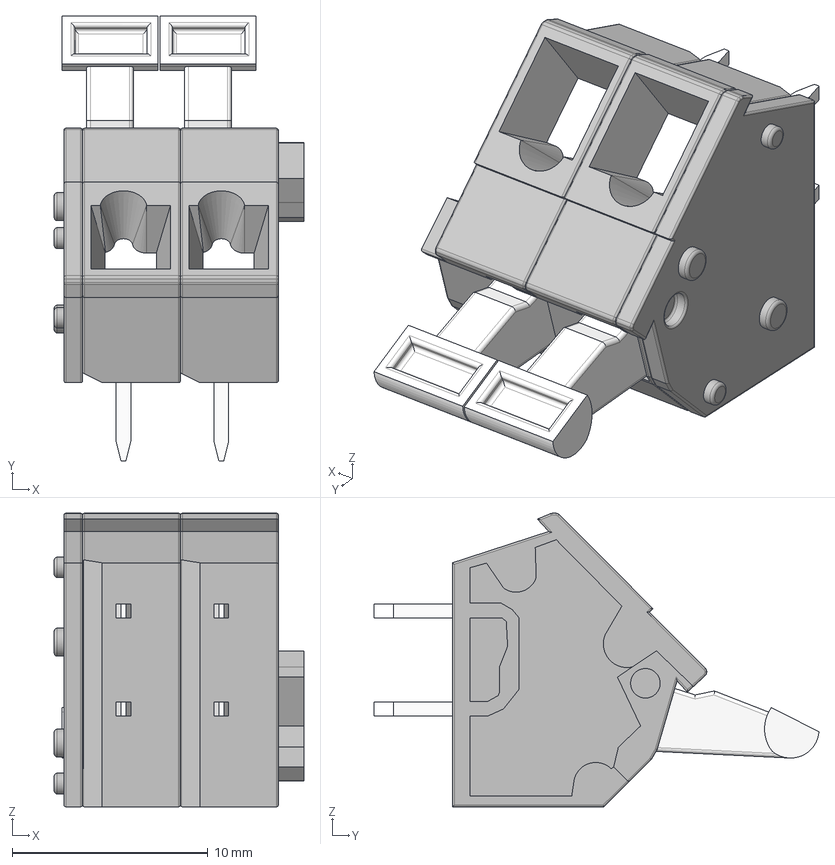
[picture p156: CAD file, 2018-12-04]
kicad-packages3d/terminal block/DG243-5.0-02P-11-00A(H).stp
12.8 x 22.7 x 15.0 mm
