louiscklaw/kicad_library/components/espressif/ESP-07v2_4wings.stl

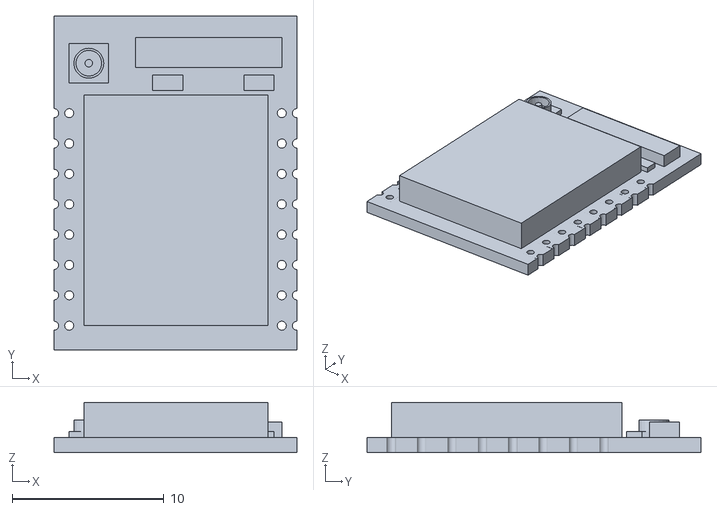
[picture p157: CAD file, 2019-05-08]
components/espressif/ESP-07v2_4wings.stl
16.0 x 22.0 x 3.30
