louiscklaw/kicad_library/kicad-packages3d/15EDGK/15EDGK-5.08-11P-14-00A(H).stp

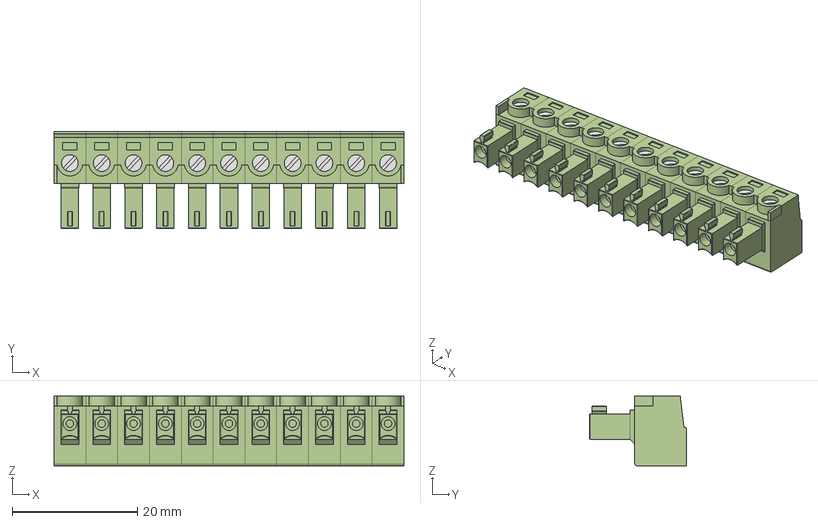
[picture p158: CAD file, 2019-10-14]
kicad-packages3d/15EDGK/15EDGK-5.08-11P-14-00A(H).stp
55.9 x 15.5 x 11.1 mm
body_1pc EC350V x 11
body_screw EC350V x 11
body_15edgk_top x 2
