louiscklaw/kicad_library/kicad-packages3d/connectors TH/DIP_sockets/DIP300-skt-flat-28.stp

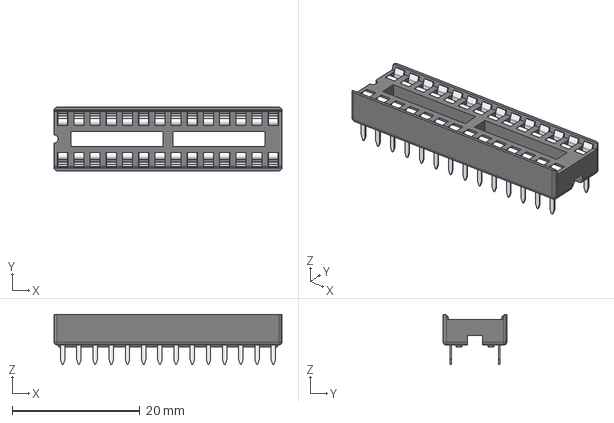
[picture p159: CAD file, 2018-12-04]
kicad-packages3d/connectors TH/DIP_sockets/DIP300-skt-flat-28.stp
35.8 x 10.0 x 7.85 mm
