louiscklaw/kicad_library/kicad-packages3d/connectors TH/rectangular/female/right_angle/2.54mm/DS1024-2x5RF1.stp

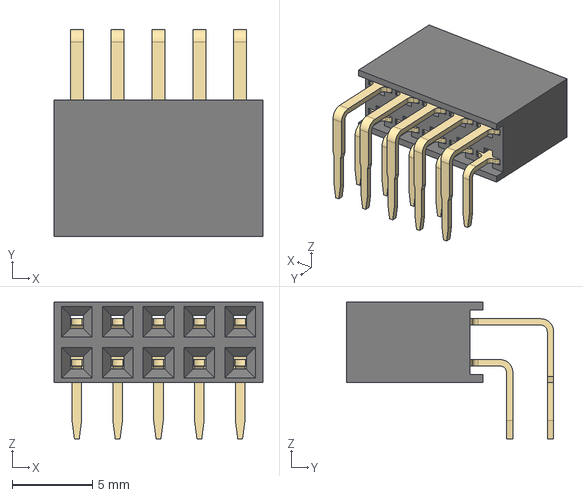
[picture p160: CAD file, 2018-12-04]
kicad-packages3d/connectors TH/rectangular/female/right_angle/2.54mm/DS1024-2x5RF1.stp
13.0 x 12.9 x 8.50 mm
