louiscklaw/kicad_library/kicad-packages3d/connectors TH/rectangular/female/vertical/2.54mm/DS1023-2x6SF11.stp

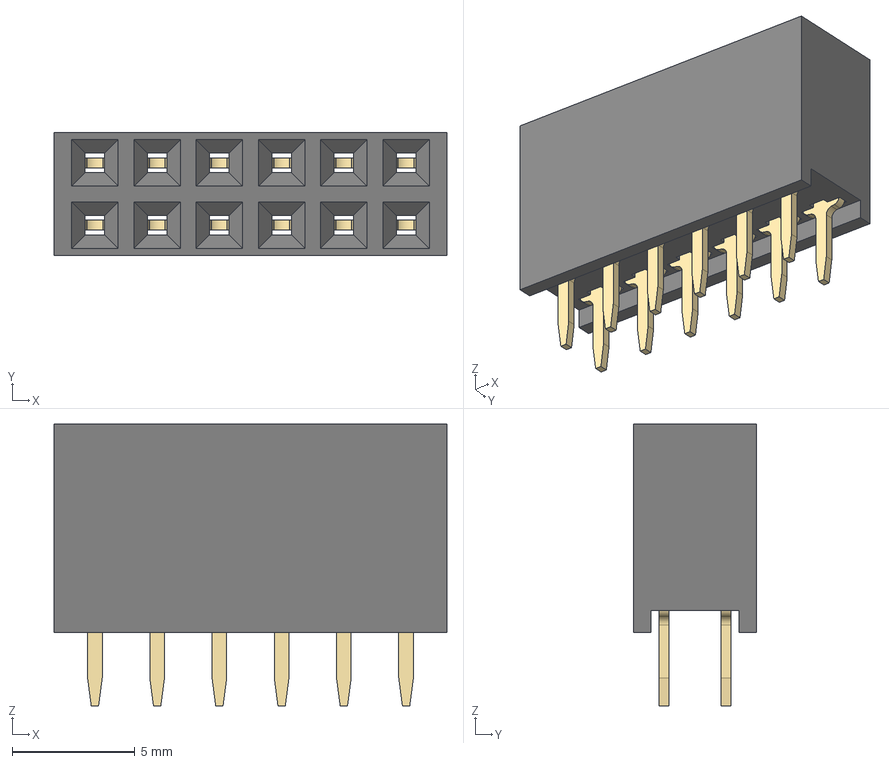
[picture p161: CAD file, 2018-12-04]
kicad-packages3d/connectors TH/rectangular/female/vertical/2.54mm/DS1023-2x6SF11.stp
16.0 x 5.00 x 11.5 mm
