louiscklaw/kicad_library/kicad-packages3d/connectors TH/rectangular/female/vertical/2.54mm/Samtec/SDL-109-TT-19.stp

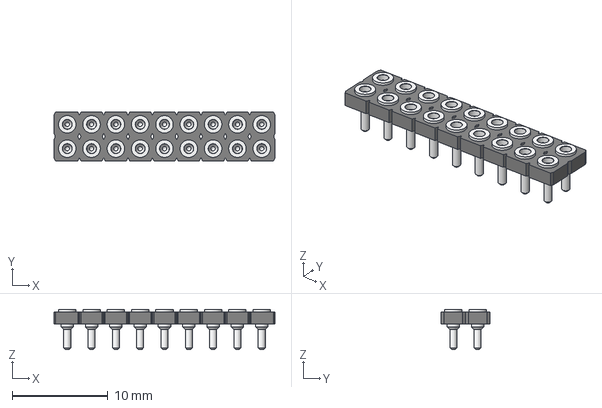
[picture p162: CAD file, 2018-12-04]
kicad-packages3d/connectors TH/rectangular/female/vertical/2.54mm/Samtec/SDL-109-TT-19.stp
23.1 x 5.08 x 4.19 mm
