louiscklaw/kicad_library/kicad-packages3d/connectors TH/rectangular/male/shrouded/vertical/2.54mm/DS1013-08SSiB.stp

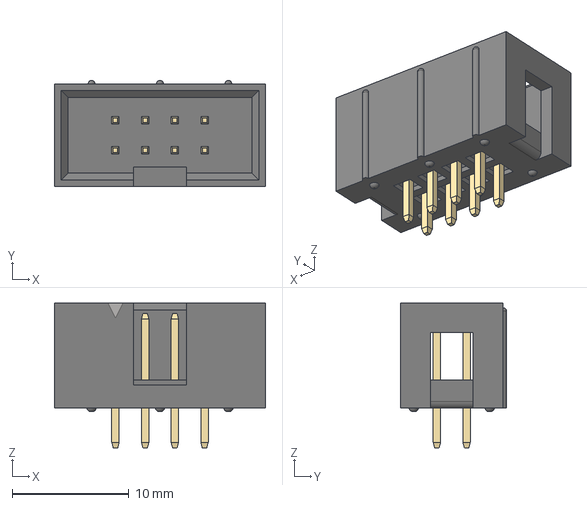
[picture p165: CAD file, 2018-12-04]
kicad-packages3d/connectors TH/rectangular/male/shrouded/vertical/2.54mm/DS1013-08SSiB.stp
18.1 x 9.10 x 12.4 mm
