louiscklaw/kicad_library/kicad-packages3d/connectors TH/rectangular/male/shrouded/vertical/2.5mm/DS1069-7MVW6X.stp

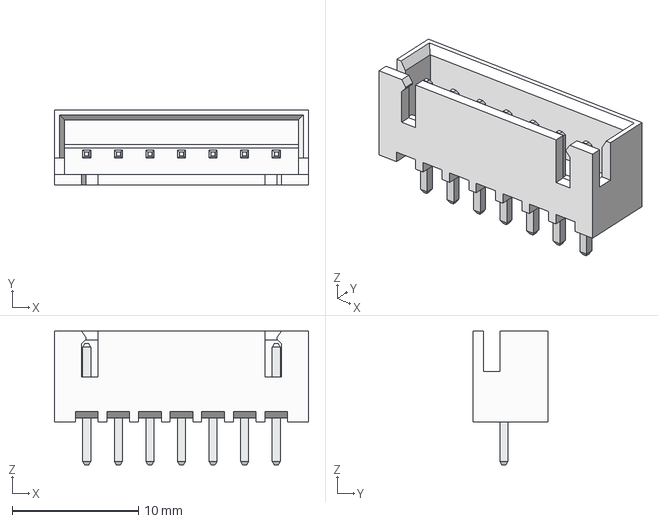
[picture p166: CAD file, 2018-12-04]
kicad-packages3d/connectors TH/rectangular/male/shrouded/vertical/2.5mm/DS1069-7MVW6X.stp
20.1 x 5.95 x 10.6 mm
