louiscklaw/kicad_library/kicad-packages3d/connectors TH/rectangular/male/unshrouded/right_angle/2.54mm/DS1022-1x2RD61.stp

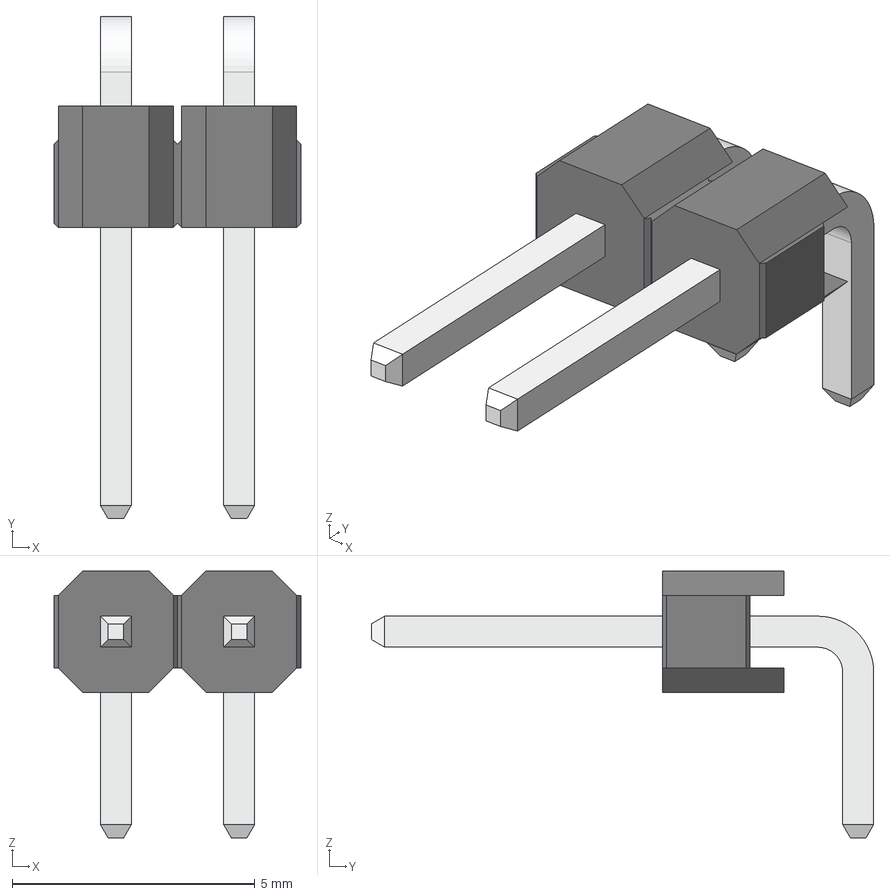
[picture p167: CAD file, 2018-12-04]
kicad-packages3d/connectors TH/rectangular/male/unshrouded/right_angle/2.54mm/DS1022-1x2RD61.stp
5.08 x 10.4 x 5.50 mm
