louiscklaw/kicad_library/(list of files, cad)

Other CAD files:
generator/kicad-footprint-generator/scripts/Connector/Connector_JST/JST_ZE_top_entry_pad_size.fcstd
kicad-packages3d/ATX_20_pin_power_connector_vertical/C_2_1586037_0_cp.step
components/espressif/ESP-13-wroom-02_4wings.stl
kicad-packages3d/SLA-05VDC-SL-C.step
kicad-packages3d/kicad-jst-xh-2.5/script/JST_BXB-XH-A.scad
components/espressif/ESP-07v2.stl
components/espressif/ESP-12.stl
components/espressif/ESP-12E_4wings.stl
components/espressif/ESP-12_4wings.stl
components/espressif/esp-wroom-32.stp
kicad-packages3d/15EDGK/15EDGK-5.08-02P-14-00A(H).stp
kicad-packages3d/15EDGK/15EDGK-5.08-03P-14-00A(H).stp
kicad-packages3d/15EDGK/15EDGK-5.08-04P-14-00A(H).stp
kicad-packages3d/15EDGK/15EDGK-5.08-05P-14-00A(H).stp
kicad-packages3d/15EDGK/15EDGK-5.08-06P-14-00A(H).stp
kicad-packages3d/15EDGK/15EDGK-5.08-07P-14-00A(H).stp
kicad-packages3d/15EDGK/15EDGK-5.08-08P-14-00A(H).stp
kicad-packages3d/15EDGK/15EDGK-5.08-09P-14-00A(H).stp
kicad-packages3d/15EDGK/15EDGK-5.08-12P-14-00A(H).stp
kicad-packages3d/15EDGK/15EDGRC-5.08- 02P-14-00A(H).stp
kicad-packages3d/15EDGK/15EDGRC-5.08- 03P-14-00A(H).stp
kicad-packages3d/15EDGK/15EDGRC-5.08- 04P-14-00A(H).stp
kicad-packages3d/15EDGK/15EDGRC-5.08- 05P-14-00A(H).stp
kicad-packages3d/15EDGK/15EDGRC-5.08- 06P-14-00A(H).stp
kicad-packages3d/15EDGK/15EDGRC-5.08- 09P-14-00A(H).stp
kicad-packages3d/15EDGK/15EDGRC-5.08- 10P-14-00A(H).stp
kicad-packages3d/15EDGK/15EDGRC-5.08- 12P-14-00A(H).stp
kicad-packages3d/A4988 one body.step
kicad-packages3d/AN9520.step
kicad-packages3d/BMP180.step
kicad-packages3d/BMP280.step
kicad-packages3d/BU2032SM_HD_GCR2032_Battery_Holder003_cp.step
kicad-packages3d/CUI_PJ-102A.STEP
kicad-packages3d/Degson/DG103-5.0-03.stp
kicad-packages3d/Degson/DG103-5.0-05.stp
kicad-packages3d/Degson/DG103-5.0-07.stp
kicad-packages3d/Degson/DG103-5.0-08.stp
kicad-packages3d/Degson/DG103-5.0-09.stp
kicad-packages3d/Degson/DG103-5.0-10.stp
kicad-packages3d/Degson/DG128-5.0-02.stp
kicad-packages3d/Degson/DG128-5.0-03.stp
kicad-packages3d/Degson/DG128-5.0-04.stp
kicad-packages3d/Degson/DG128-5.0-05.stp
kicad-packages3d/Degson/DG128-5.0-06.stp
kicad-packages3d/Degson/DG128-5.0-07.stp
kicad-packages3d/Degson/DG128-5.0-09.stp
kicad-packages3d/Degson/DG128-5.0-10.stp
kicad-packages3d/Degson/DG301-5.0-02.stp
kicad-packages3d/Degson/DG301-5.0-03.stp
kicad-packages3d/Degson/DG301-5.0-04.stp
kicad-packages3d/Degson/DG301-5.0-05.stp
kicad-packages3d/Degson/DG301-5.0-06.stp
kicad-packages3d/Degson/DG301-5.0-07.stp
kicad-packages3d/Degson/DG301-5.0-08.stp
kicad-packages3d/Degson/DG301-5.0-09.stp
kicad-packages3d/Degson/DG301-5.0-10.stp
kicad-packages3d/Degson/DG301-5.0-12.stp
kicad-packages3d/EL817S1.step
kicad-packages3d/FanPinHeader_1x04_P2.54mm_Vertical/022232041.stp
kicad-packages3d/FanPinHeader_1x04_P2.54mm_Vertical/FanConnector4pin.stl
kicad-packages3d/HRS1H-S-DC5V.step
kicad-packages3d/IC/21-0114C.stp
kicad-packages3d/IC/401.14-6.stp
kicad-packages3d/IC/8S2-L.stp
kicad-packages3d/IC/8S2-M.stp
kicad-packages3d/IC/AD-CP-72-6-LFCSP_VQ-72-10x10.stp
kicad-packages3d/IC/AD-CP-72-7-LFCSP_VQ-72-10x10.stp
kicad-packages3d/IC/MO-153AAT.stp
kicad-packages3d/IC/MO-153AB-1.stp
kicad-packages3d/IC/MO-153AB.stp
kicad-packages3d/IC/MO-153AC.stp
kicad-packages3d/IC/MO-153AD.stp
kicad-packages3d/IC/MO-153AE.stp
kicad-packages3d/IC/MO-178AA.stp
kicad-packages3d/IC/MO-178AB.stp
kicad-packages3d/IC/MO-178BA.stp
kicad-packages3d/IC/MO-187AA-T.stp
kicad-packages3d/IC/MO-187AA.stp
kicad-packages3d/IC/MO-187BA.stp
kicad-packages3d/IC/MO-187CA.stp
kicad-packages3d/IC/MO-193AA.stp
kicad-packages3d/IC/MO-193AB.stp
kicad-packages3d/IC/MO-193BA.stp
kicad-packages3d/IC/MO-220VJJE-1.stp
kicad-packages3d/IC/MO-220WGGE.stp
kicad-packages3d/IC/MO-229V3030C-1.stp
kicad-packages3d/IC/MO-229W3030D-1.stp
kicad-packages3d/IC/MO-235AA.stp
kicad-packages3d/IC/MS-012AA.stp
kicad-packages3d/IC/MS-012AB.stp
kicad-packages3d/IC/MS-012AC.stp
kicad-packages3d/IC/MS-013AA.stp
kicad-packages3d/IC/MS-013AB.stp
kicad-packages3d/IC/MS-013AC.stp
kicad-packages3d/IC/MS-013AD.stp
kicad-packages3d/IC/MS-013AE.stp
kicad-packages3d/IC/MS-026ABA.stp
kicad-packages3d/IC/MS-026ACB.stp
kicad-packages3d/IC/MS-026ACD.stp
kicad-packages3d/IC/MS-026BBC.stp
kicad-packages3d/IC/MS-026BED.stp
kicad-packages3d/IC/SC-74.stp
kicad-packages3d/IC/SC-74A.stp
kicad-packages3d/IC/SC-88.stp
kicad-packages3d/IC/SC-88A.stp
kicad-packages3d/IC/ST_TDFN8DG_2x2.stp
kicad-packages3d/IC/TI_DCU_R-PDSO-G8.stp
kicad-packages3d/MMA8452QR025_cp.step
kicad-packages3d/NanoV3 v4.step
kicad-packages3d/OLED_27x27.step
kicad-packages3d/PMS5003_BODY.step
kicad-packages3d/Pi_Zero_W.stl
kicad-packages3d/SLA-05VDC-SL-C.stp
kicad-packages3d/SO4.stp
kicad-packages3d/SRD-05VDC-SL-C.step
kicad-packages3d/Sensirion_Humidity_SHT3x_STEP-file.step
kicad-packages3d/Tiger Heatsink Mesh ~37mm x 37mm x 20mm.stl
kicad-packages3d/USBC_16PIN.step
kicad-packages3d/VEML6070_v4_cp.step
kicad-packages3d/connectors TH/DIP_sockets/DIP300-skt-flat-18.stp
kicad-packages3d/connectors TH/DIP_sockets/DIP300-skt-flat-24.stp
kicad-packages3d/connectors TH/DIP_sockets/DIP300-skt-flat-8.stp
kicad-packages3d/connectors TH/rectangular/female/right_angle/2.54mm/DS1024-1x1RF1.stp
kicad-packages3d/connectors TH/rectangular/female/right_angle/2.54mm/DS1024-1x2RF1.stp
kicad-packages3d/connectors TH/rectangular/female/right_angle/2.54mm/DS1024-1x3RF1.stp
kicad-packages3d/connectors TH/rectangular/female/right_angle/2.54mm/DS1024-1x4RF1.stp
kicad-packages3d/connectors TH/rectangular/female/right_angle/2.54mm/DS1024-1x6RF1.stp
kicad-packages3d/connectors TH/rectangular/female/right_angle/2.54mm/DS1024-1x7RF1.stp
kicad-packages3d/connectors TH/rectangular/female/right_angle/2.54mm/DS1024-1x8RF1.stp
kicad-packages3d/connectors TH/rectangular/female/right_angle/2.54mm/DS1024-1x9RF1.stp
kicad-packages3d/connectors TH/rectangular/female/right_angle/2.54mm/DS1024-2x10RF1.stp
kicad-packages3d/connectors TH/rectangular/female/right_angle/2.54mm/DS1024-2x20RF1.stp
kicad-packages3d/connectors TH/rectangular/female/right_angle/2.54mm/DS1024-2x2RF1.stp
kicad-packages3d/connectors TH/rectangular/female/right_angle/2.54mm/DS1024-2x3RF1.stp
kicad-packages3d/connectors TH/rectangular/female/right_angle/2.54mm/DS1024-2x7RF1.stp
kicad-packages3d/connectors TH/rectangular/female/right_angle/2.54mm/DS1024-2x8RF1.stp
kicad-packages3d/connectors TH/rectangular/female/right_angle/2.54mm/DS1024-2x9RF1.stp
kicad-packages3d/connectors TH/rectangular/female/vertical/2.54mm/DS1023-1x2SF11.stp
kicad-packages3d/connectors TH/rectangular/female/vertical/2.54mm/DS1023-1x3SF11.stp
kicad-packages3d/connectors TH/rectangular/female/vertical/2.54mm/DS1023-1x4SF11.stp
kicad-packages3d/connectors TH/rectangular/female/vertical/2.54mm/DS1023-1x5SF11.stp
kicad-packages3d/connectors TH/rectangular/female/vertical/2.54mm/DS1023-1x6SF11.stp
kicad-packages3d/connectors TH/rectangular/female/vertical/2.54mm/DS1023-1x7SF11.stp
kicad-packages3d/connectors TH/rectangular/female/vertical/2.54mm/DS1023-1x8SF11.stp
kicad-packages3d/connectors TH/rectangular/female/vertical/2.54mm/DS1023-1x9SF11.stp
kicad-packages3d/connectors TH/rectangular/female/vertical/2.54mm/DS1023-2x10SF11.stp
kicad-packages3d/connectors TH/rectangular/female/vertical/2.54mm/DS1023-2x20SF11.stp
kicad-packages3d/connectors TH/rectangular/female/vertical/2.54mm/DS1023-2x3SF11.stp
kicad-packages3d/connectors TH/rectangular/female/vertical/2.54mm/DS1023-2x4SF11.stp
kicad-packages3d/connectors TH/rectangular/female/vertical/2.54mm/DS1023-2x5SF11.stp
kicad-packages3d/connectors TH/rectangular/female/vertical/2.54mm/DS1023-2x7SF11.stp
kicad-packages3d/connectors TH/rectangular/female/vertical/2.54mm/DS1023-2x9SF11.stp
kicad-packages3d/connectors TH/rectangular/female/vertical/2.54mm/Samtec/SDL-101-TT-10.stp
kicad-packages3d/connectors TH/rectangular/female/vertical/2.54mm/Samtec/SDL-101-TT-11.stp
kicad-packages3d/connectors TH/rectangular/female/vertical/2.54mm/Samtec/SDL-101-TT-12.stp
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
