louiscklaw/kicad_library/sample_project/5x5_pcb/5x5_pcb.sch

## KiCad design sample_project/5x5_pcb/5x5_pcb.sch (2021-09-25)

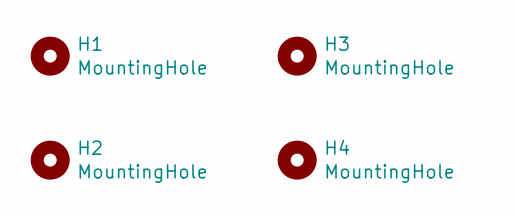
[picture p168: schematic 5x5_pcb.sch]

Parts:
H1, H2, H3, H4: MountingHole; MountingHole_2.7mm_M2.5,rpi_like
