louiscklaw/kicad_library/(commit log)

2018-10-15 import footprint from olimex
2018-10-23 update footprint,
2018-10-23 rename kicad-footprint-generator directory,
    [JST-PH-SMT-SIDE_ENTRY.fcstd, JST-PH-SMT-TOP_ENTRY.fcstd, JST_ZE_top_entry_pad_size.fcstd, buzzer_round_tht_star_mictronics.csv, params.csv, smd_chip_resistors_smd.csv]
2018-10-23 update 2.54 footprint,
2018-10-23 update with integrate KiPart,
    [example.csv]
2018-10-29 fix pin name,
2018-11-01 update push button footprint,
2018-11-03 update pin of uSD,
2018-11-07 fix pin VCC-IO2,
2018-11-08 update LCD power,
2018-11-26 upadte ARDUINO_NANO_V3,
2018-11-26 update for RPi connector,
2018-11-26 update for arduino-nano-v3 connector,
2018-11-26 =update pcb-usb,
2018-11-26 update 3d model,
    [A4988 one body.step]
2018-11-27 update for relay,
2018-11-30 fix EA3036 footprint,
2018-12-13 =update for heatsink,
    [Tiger Heatsink Mesh ~37mm x 37mm x 20mm.stl]
2018-12-13 =update for wireless antenna,
2018-12-22 update for POWER,
2018-12-23 update UART,
2018-12-23 update RASPBERRY IO EXP,
2018-12-26 update power symbol,
2018-12-27 update power mark,
2018-12-28 update atmega328p pin description,
2018-12-29 update for FUSE,
2018-12-29 update for oscillator footprint 3216,
2018-12-29 update HDMI-5V,
2018-12-29 add STM32F030x4/x6/x8,
2018-12-30 update for CAMERA_OV5640,
2018-12-31 update to delete digikey library
    [familylist_refdes.csv]
2018-12-31 update to delete tinkerforge,
    [2920-fuse.step, 3225.step, 5032.step, AB26TRQ.fcstd, AB26TRQ.step, AKL_5_2.fcstd, AKL_5_2.step, AKL_5_2_508_black.fcstd]
2019-01-07 update for AXP209 footprint definition,
2019-04-24 update for orange-pi-footprint,
2019-04-25 update for STM32F407VET6,
2019-04-27 update for endstop and fan connectors,
2019-04-28 update with TO-263, heatsink,
2019-05-06 update for stepper motor b2b footprint,
2019-05-06 fix position stepper motor b2b footprint,
2019-05-06 update copper clearance area for mount holes,,
2019-05-07 put footprint into danger, should not be used,
2019-05-07 update for screw terminals,
2019-05-08 update file permissions only,
    [10-32-1021.stp, 10-32-1031.stp, 10-32-1041.stp, 10-32-1051.stp, 10-32-1061.stp, 10-32-1071.stp, 10-32-1081.stp, 10-32-1091.stp]
2019-05-08 update for esp32 3d model,
    [ESP-07v2.stl, ESP-07v2_4wings.stl, ESP-12.stl, ESP-12E.stl, ESP-12E_4wings.stl, ESP-12_4wings.stl, ESP-13-wroom-02.stl, ESP-13-wroom-02_4wings.stl]
2019-05-09 update reset button,
2019-05-14 update for UBLOX,
    [NEO-M8U Ublox Module.step]
2019-05-15 update for footprint KF,
2019-05-15 update for stepper motor terminals,
    [JST_BXB-XH-A.scad]
2019-05-16 update friendlyarm footprint, delete duplicated,
2019-05-17 update orange pi footprint,
2019-05-19 update for osc debug footprint,
2019-05-19 update for using 8M osc debug footprint,
2019-05-20 update footprint and symbols for varistor,
2019-05-21 update for led library,
2019-05-21 update for SSD1306 I2C interface,
2019-05-21 update ADC.sch,
2019-05-22 update for arduino footprint,.
2019-05-25 update for MP1584,
    [D-SUN_dcdc_step_down_SIMPLE.step]
2019-05-26 refill SSD1306-OLED I2C,
2019-05-26 update for STM32V,
2019-05-26 update for stm32f103c8t6,
2019-05-26 udpate for SPI, I2C,
2019-06-01 update for solder jumper,
2019-06-02 update for SSD1306 12832,
    [MX.STEP, OLED_0.91_128x32.stp]
2019-06-02 update for power symbol,
2019-06-02 update for STM32 footprint,
2019-06-03 update for component 3d model,
    [Cherry MX Keycap.STL, MX.STEP, cherry mx.step, cherry_mx.step, keycap_dsa_signatureplastics_r3.step]
2019-06-04 update for taobao-fuse,
2019-06-04 update for taobao-fuse for mAs,
2019-06-06 update for DC barrel jack,
    [CUI_PJ-102A.STEP]
2019-06-07 update for SHT3x,
    [Sensirion_Humidity_SHT3x_STEP-file.step]
2019-06-07 update for AN9520,
    [AN9520.step]
2019-06-10 update for RA-02,
    [User Library-RA-02.STEP]
2019-06-11 update for ESP-32S,
    [ESP-WROOM-32.step]
2019-06-12 update MMA8451Q,
    [MMA8452QR025_cp.step]
2019-06-12 update for footprint,
2019-06-14 update for RFM95,
    [RFM95.step]
2019-06-15 update for ESP32-WROOM,
2019-06-16 update for ESP32,
2019-06-19 update for STM32F042,
2019-06-22 update for STM32F030F4,
2019-07-05 update for SSD1306,
    [OLED_27x27.STEP, OLED_27x27.step]
2019-07-05 update for HLK-PM03,
    [hlk_pm03.step]
2019-07-05 update for SRD-05VDC-SL-C,
    [SRD-05VDC-SL-C.step]
2019-07-07 update phone jack,
    [4_Pin_audio_jack.STEP]
2019-09-26 update footprint 3d model,
    [691322110003.step, 691322310002.step]
2019-10-14 update components,
    [15EDGK-5.08-02P-14-00A(H).stp, 15EDGK-5.08-03P-14-00A(H).stp, 15EDGK-5.08-04P-14-00A(H).stp, 15EDGK-5.08-05P-14-00A(H).stp, 15EDGK-5.08-06P-14-00A(H).stp, 15EDGK-5.08-07P-14-00A(H).stp, 15EDGK-5.08-08P-14-00A(H).stp, 15EDGK-5.08-09P-14-00A(H).stp]
2020-01-22 init taobao-connector,
2020-01-22 update for ATX 20 pin connector,
    [ATX_20_pin_power_connector.step, C_2_1586037_0_cp.step, c-2-1586037-0-b-3d.stp]
2020-01-22 update to fix footprint.pretty,
2020-03-03 update raspberri pi pin hole connector,
2020-03-09 update for phonix 8 pin connector,
2020-03-09 add phonix connector,
2020-04-06 update licheepi nano footprint size,.
2020-04-06 update licheepi nano footprint,
2020-04-25 re-number licheepi nano footprint,
2020-05-08 feat: adding heatbed-soldering-power-terminal,
2020-05-08 feat: adding pi-nano-footprint,
2020-10-04 update leg assignment,
2021-09-17 update and test,
    [022232041.stp, FanConnector4pin.stl, FanConnector4pin.stp]
2021-09-20 update kicad library,
    [DC_JACK.sch]
2021-09-28 update test,
    [pcb_template.kicad_pcb, pcb_template.sch]
